lcall3/Controller/doc/img/cad assembly.JPG

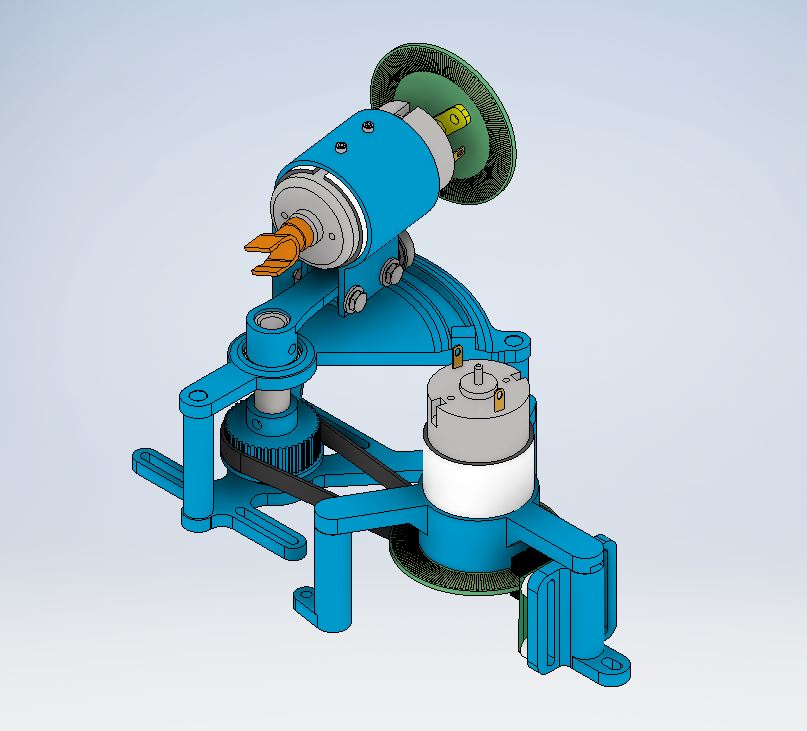
doc/img/cad assembly.JPG
