lcall3/Controller/doc/img/motor mount.png

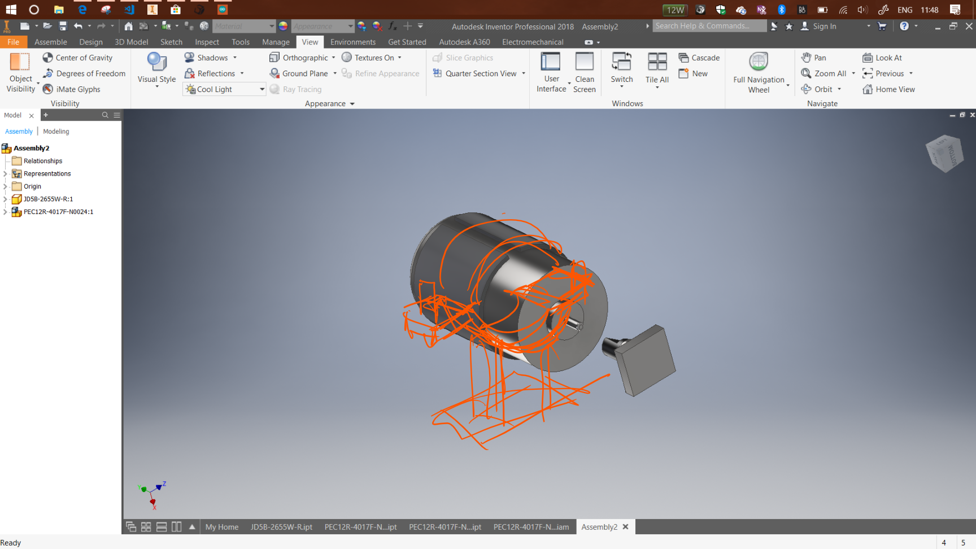
doc/img/motor mount.png
