lcall3/Controller/README.md

# ELEC391 Controller
ELEC391 Laser Lightshow Controller

> **Disclaimer**: Please use this repository as reference material only; we will not be responsible for any occurance of academic dishonesty.
