lcall3/Controller/doc/report/demo2 - demo.pptx

## Laser Light Show

ELEC 391 – Group B1

## Simulink Model

## The Process

Find Motor Parameters
Encoder PCB
System Setup
Controller Code

## Motor Parameters

- Resistance and Impedance
- Torque Constant
- Rotor Inertia
- Back EMF
- Kinetic Friction

R, L (8.4 Ω , 1.12mH)
R, L (8.4 Ω , 1.12mH)
Measured using multimeter
Kτ ( 23.54 (mNm)/A )
Kτ ( 23.54 mNm/A )
J ( 5.93×10^(−6) kg m^2 )
J ( 5.93×〖10〗^(−6) kg m^2 )
B ( 4.964 ×10^(−6) (kg m^2)/s )
B ( 4.964 ×〖10〗^(−6) (kg m^2)/s )
Torque determined from conservation of power
Calculated from mechanical time constant
Kv ( 628.5 (RPM)/V )
Kv ( 628.5 RPM/V )
Back EMF calculated from KVL
Kinetic friction from (torque)/(friction) at no load conditions
Kinetic friction from torque/friction at no load conditions

## Checking Motor Parameters

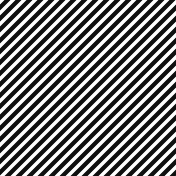
[picture p3: figure]

## Checking Motor Parameters

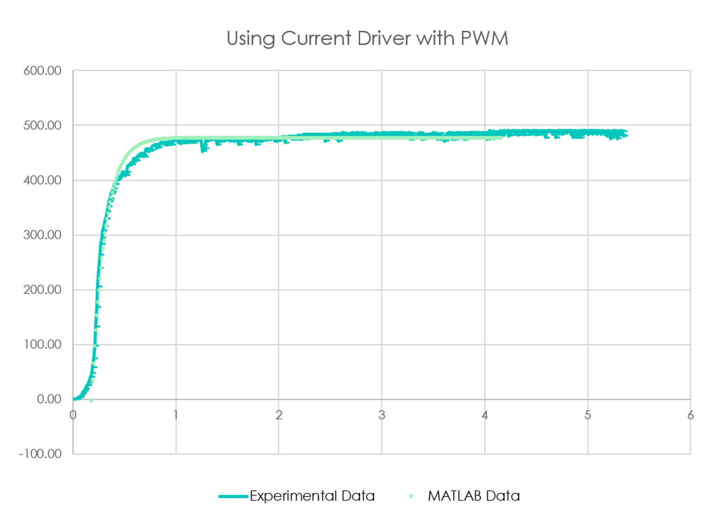
[picture p4: figure]

## Motor Model Roots

-7493

-8

0

* not to scale *

## Simulink Model with PID Control

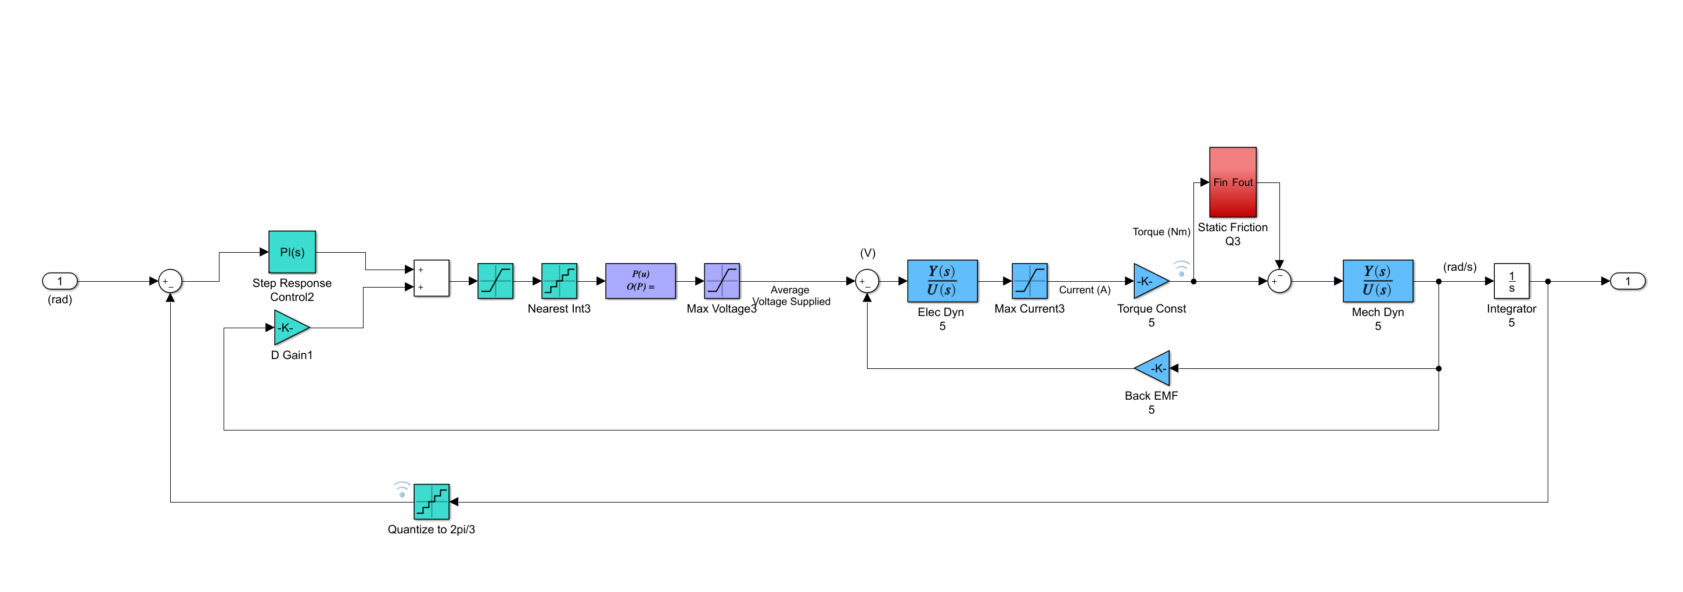
[picture p5: figure]

Static Friction and Cogging

PWM Value between
0 - 255

Input Step

Maps PWM to Average Voltage

Output Position

Derivative Gain on Velocity

Quantizes Angle to Encoder Resolution

Motor Transfer Function

## Controller Logic – Reading Position

On Encoder A Interrupt

A ^ B

Position++

Read Encoder A

End

Position--

On Encoder B Interrupt

Read Encoder B

A ^ B

Position++

End

Position--

State 01

State 00

State 11

State 10

Increment

Decrement

State
<A> <B>

## P Control

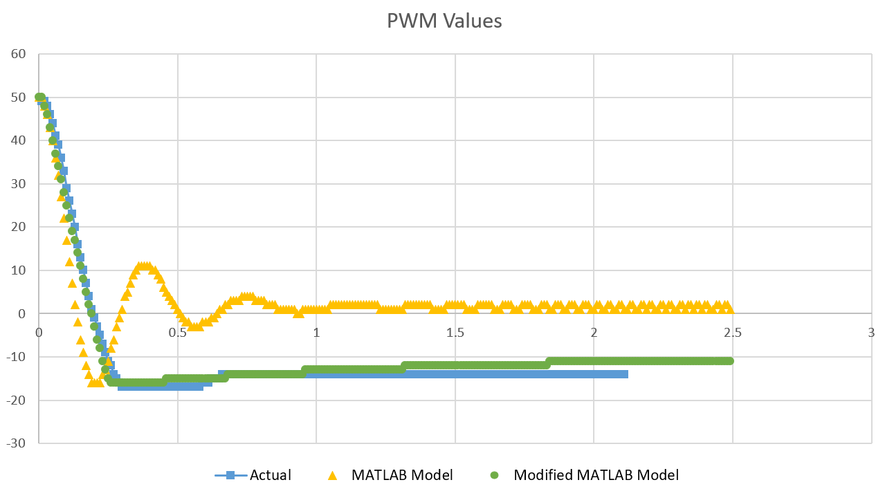
[picture p6: figure]

k_P =0.05(PWM)/(pulse)

## P Control

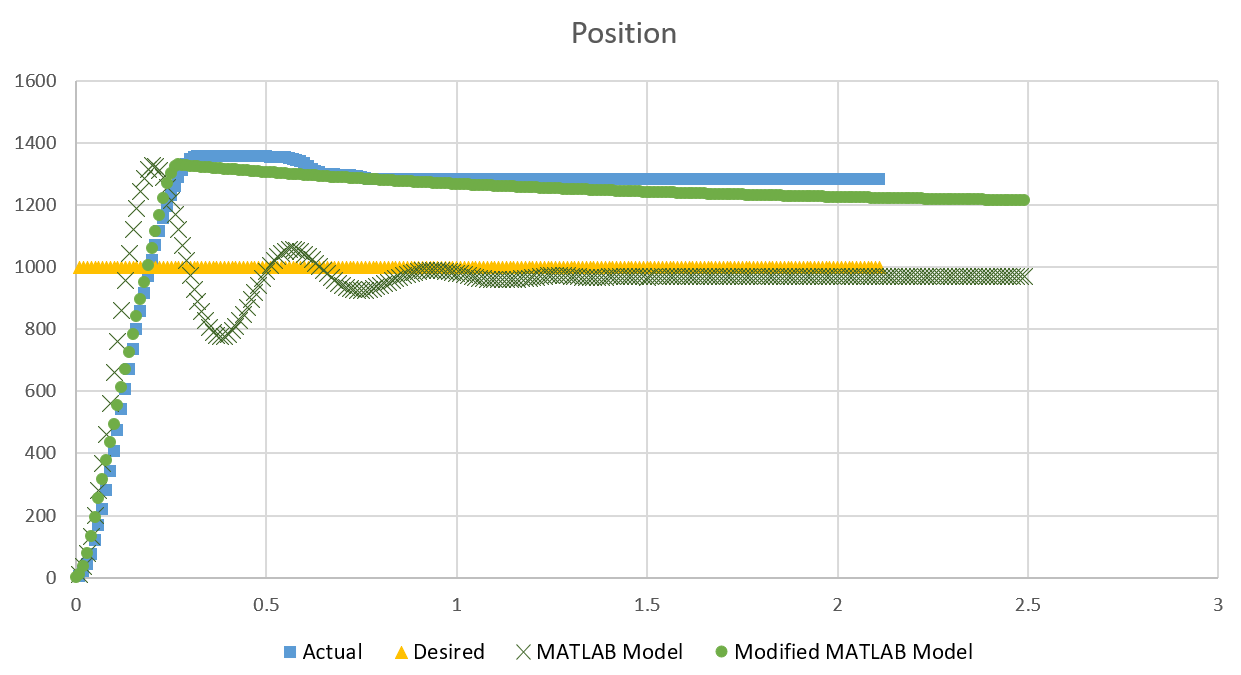
[picture p7: figure]

## PD Control

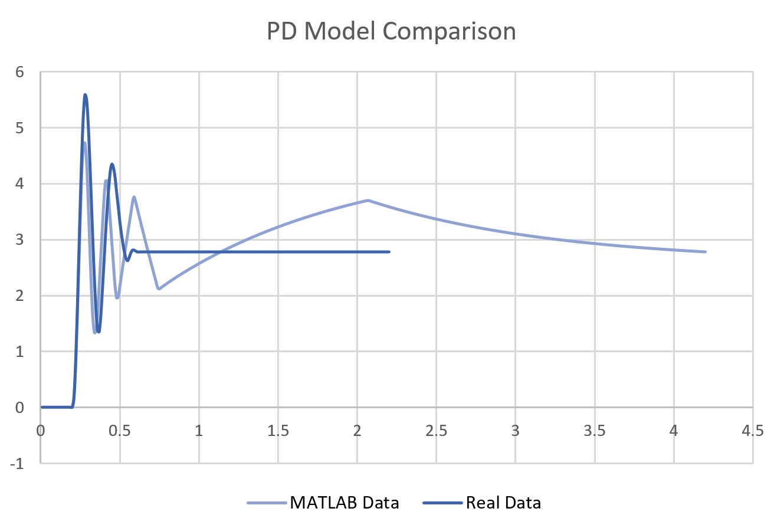
[picture p8: figure]

## Initial Control

- Aim for fastest rise time and small overshoot
- Ensure system is stable

Overshoot | 14.28 %
Rise Time | 0.1 s
Settle Time | 2 s
Control Frequency

k_P | k_I | k_D
17.7 | 0 | -0.4

## Performance

Overshoot | ~ 2 %
Rise Time | ~ 0.13 s
Settle Time | ~ 0.12 s
Control Frequency | ??

## Slide 16

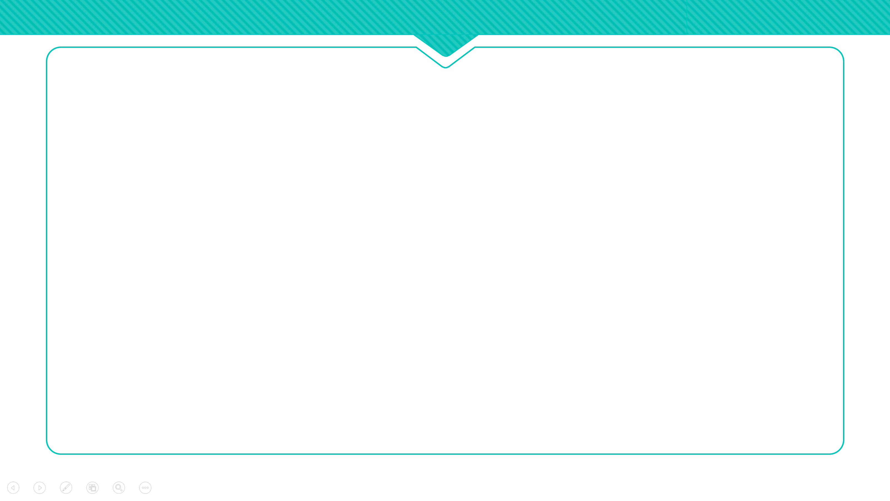
[picture p9: figure]

SYSTEM

INSERT IMAGE OF CAD MODEL FOR SYSTEM

## Performance

Overshoot | ~ 5 %
Rise Time | ~ 0.13 s
Settle Time | ~ 0.3 s
Control Frequency | ??

k_P | k_I | k_D
101.85 | 0 | -2.8838

## Next Steps - Integration

- Measure new motor parameters
- Adjust system integration design
- Improve gear ratios
- Retune PIDs

## System PCB

Current Driver

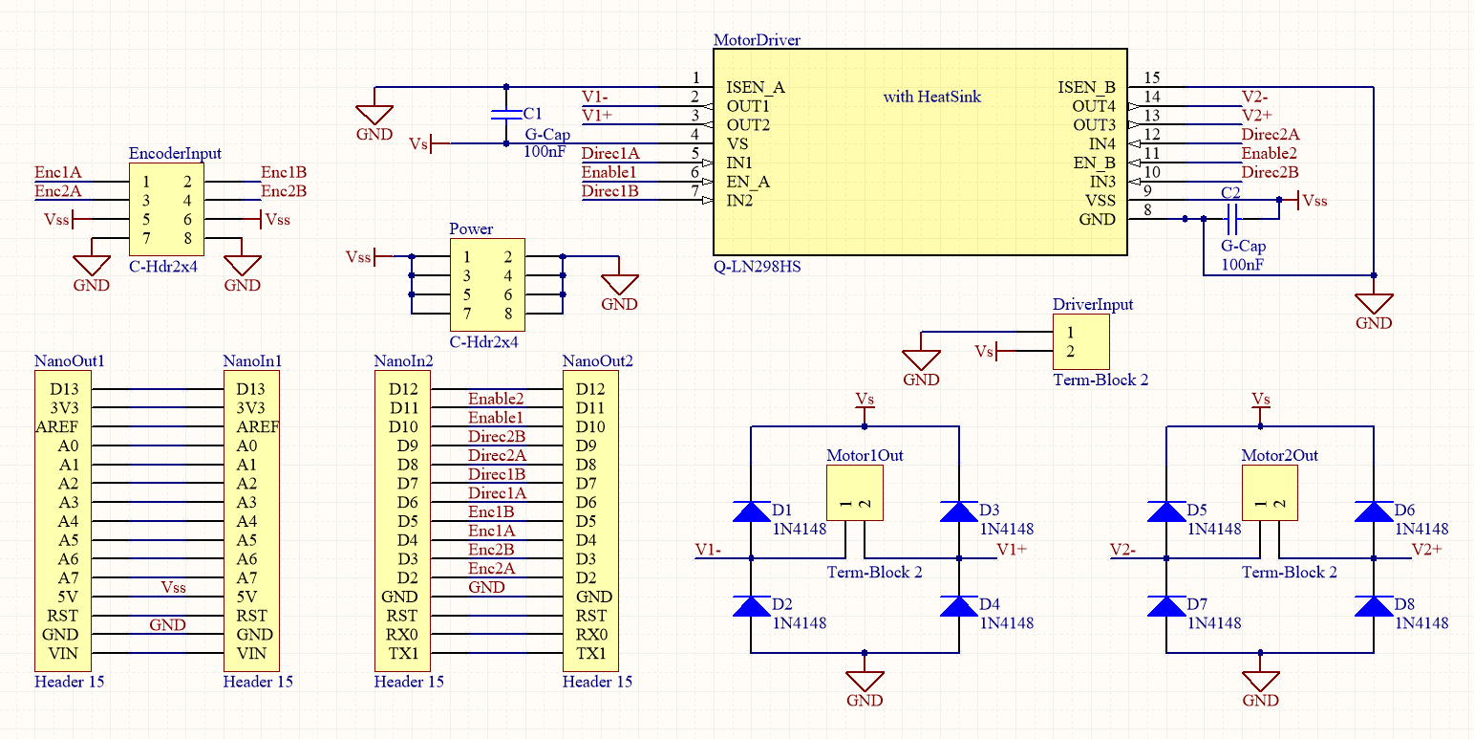
[picture p10: figure]

Pins from Encoder

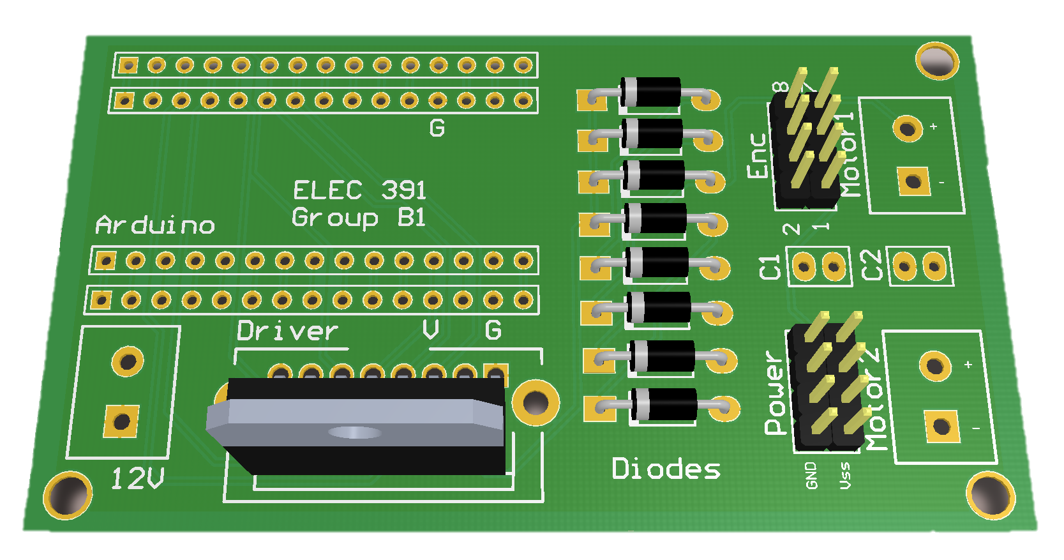
[picture p11: figure]

Extra 5V Pins

12V Input Pins

Arduino Base

Diode Bridge

## Coordinate Mapping Application

## Simulink Model
