lcall3/Controller/doc/report/demo2.pptx

## Laser Light Show

ELEC 391 – Group B1 ( Control )

## Simulink Model

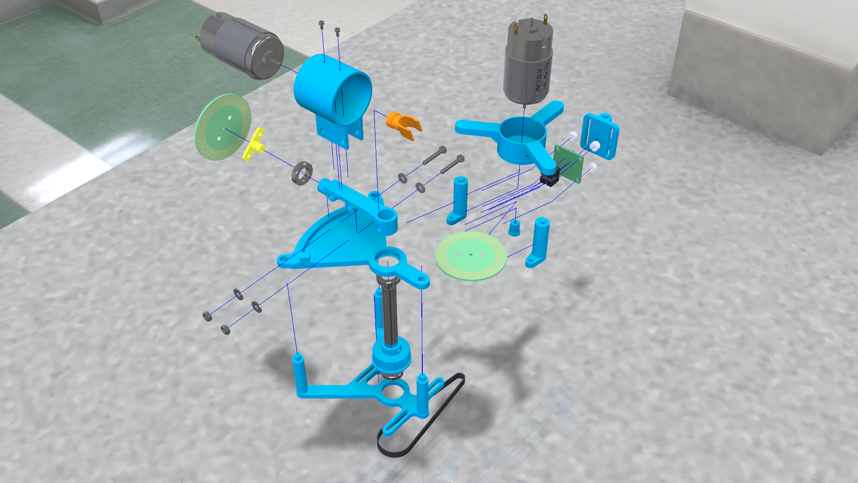
[picture p12: figure]
A birthday cake Description generated with high confidence
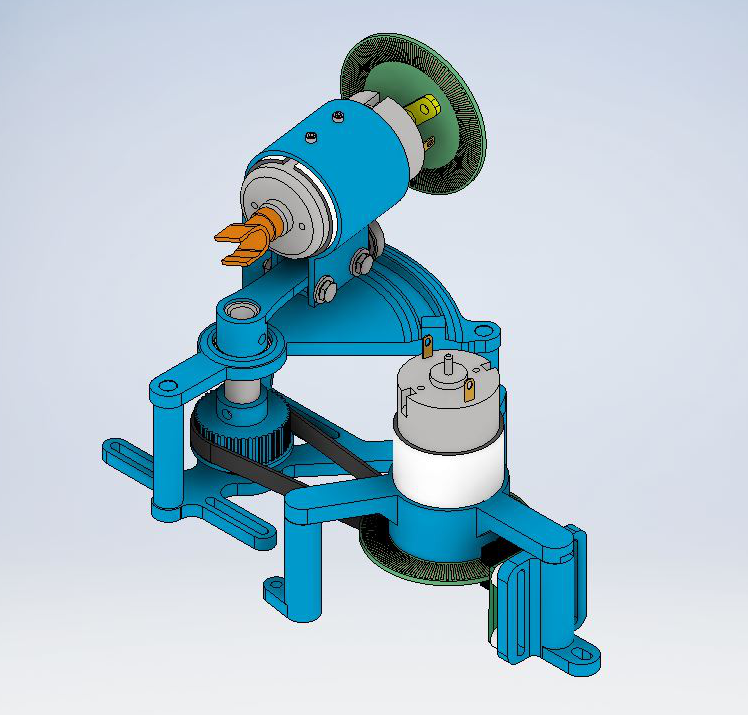
[picture p13: figure]
A close up of a toy Description generated with high confidence

## RCGs

Requirements
PID Values Obtained
Encoder Detects Position and Direction
Constraints
Max Memory / Speed of Microcontroller
Max Motor Current
( < 1A )
Goals
Rise Time
( < 0.017 s )
Overshoot
( < 10 % )
Functioning Microcontroller
No Breadboards
Max Encoder Resolution
( 400 pulses )
Simulink Model of Motor Within 5 % Error

## The Process

Find Motor Parameters
Encoder PCB
System Setup
Controller Code

## Motor Parameters

- Resistance and Impedance
- Torque Constant
- Rotor Inertia
- Back EMF
- Kinetic Friction

R, L (8.4 Ω , 1.12mH)
R, L (8.4 Ω , 1.12mH)
Measured using multimeter
Kτ ( 23.54 (mNm)/A )
Kτ ( 23.54 mNm/A )
J ( 5.93×10^(−6) kg m^2 )
J ( 5.93×〖10〗^(−6) kg m^2 )
B ( 4.964 ×10^(−6) (kg m^2)/s )
B ( 4.964 ×〖10〗^(−6) (kg m^2)/s )
Torque determined from conservation of power
Calculated from mechanical time constant
Kv ( 628.5 (RPM)/V )
Kv ( 628.5 RPM/V )
Back EMF calculated from KVL
Kinetic friction from (torque)/(friction) at no load conditions
Kinetic friction from torque/friction at no load conditions

## Checking Motor Parameters


## Closed Loop Simulink Model

Model Behaviour for Low PWM Values

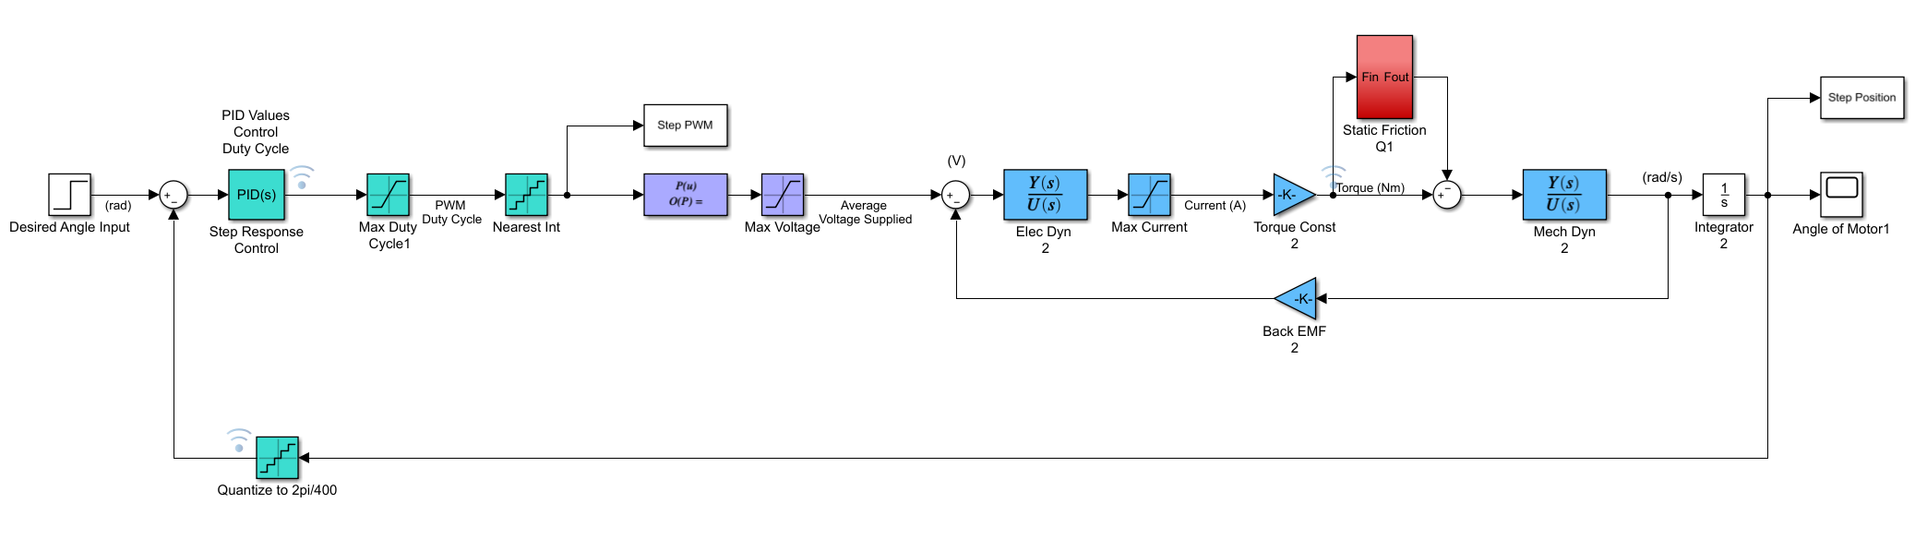
[picture p14: figure]

PWM Value between
0 - 255

Maps PWM to Average Voltage

Rounds PWM to Integer

Quantizes Angle to Encoder Resolution

Motor Transfer Function

## Controller Logic – Reading Position

On Encoder A Interrupt

A ^ B

Position++

Read Encoder A

End

Position--

On Encoder B Interrupt

Read Encoder B

A ^ B

Position++

End

Position--

State 01

State 00

State 11

State 10

Increment

Decrement

State
<A> <B>

## Initial Control

- Aim for fastest rise time and smallest overshoot
- Ensure system is stable

Overshoot
Rise Time
Settle Time
Control Frequency

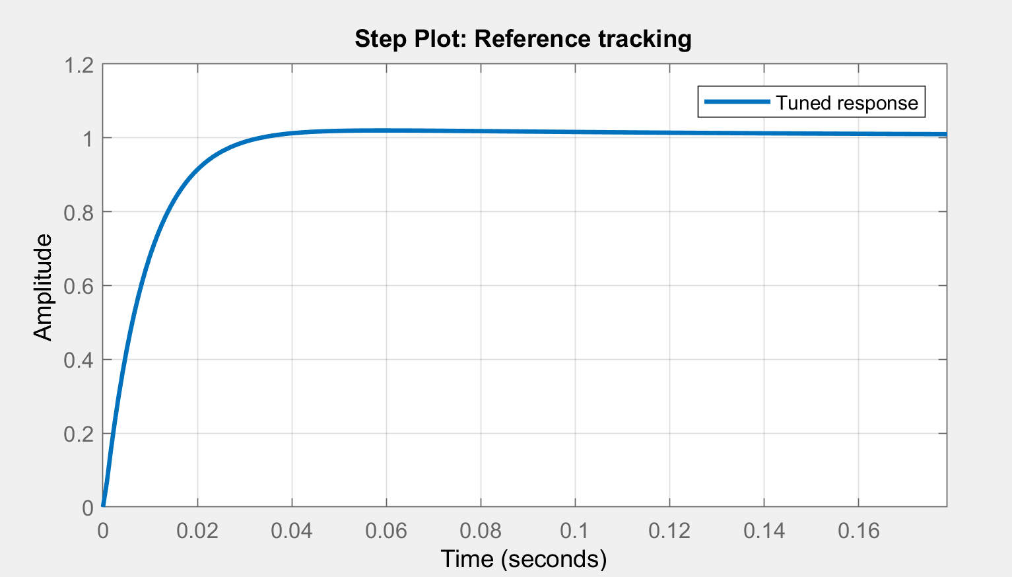
[picture p15: figure]

k_P | k_I | k_D | N
12.43 | 11.1 | 1.1 | 12783.9

## Controller Logic – PID Control

Proportional
Subtract current position from desired position for error value
Multiply by proportional gain
Integral
Keep sum of error values at small intervals
Multiply by integral gain
Derivative
Save position value every millisecond for velocity
Multiply velocity by derivative gain (negative)
Reset sum for each new coordinate

## P Control


Modified MATLAB Model accounts for values of PWM less than 30 being too low to overcome cogging and static friction


## PD Control

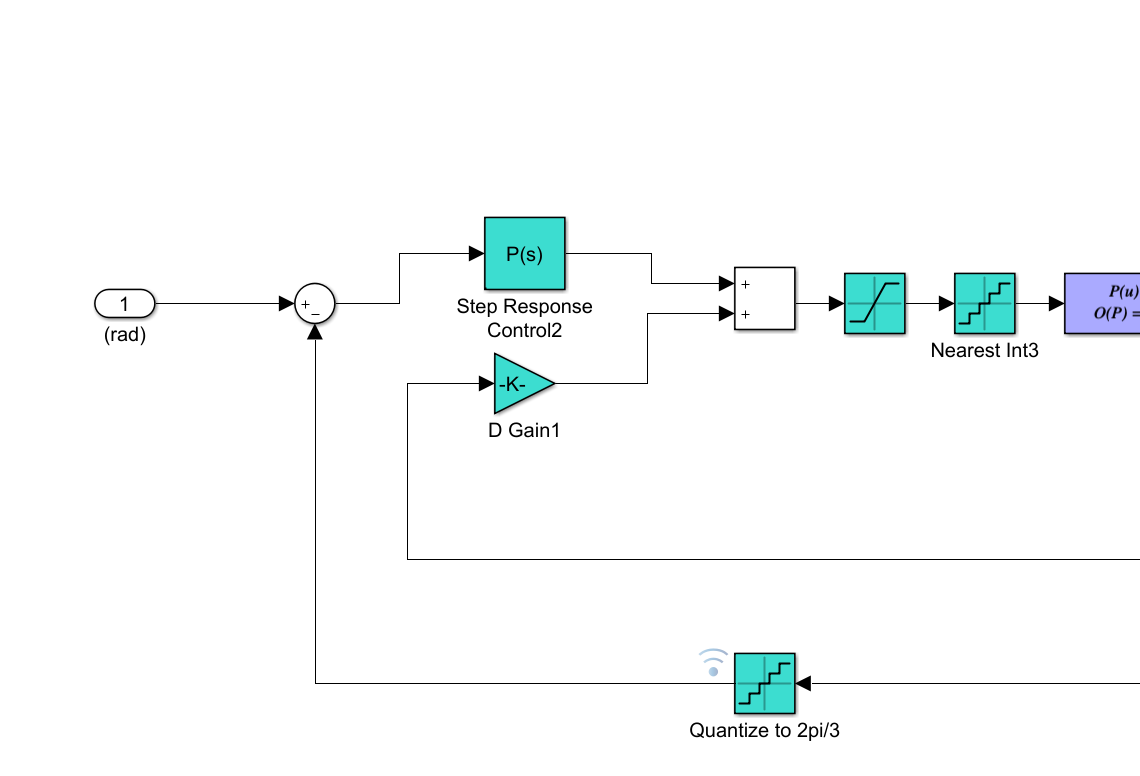
[picture p16: figure]

Simulink model adjusted for derivative control on current velocity instead of rate of error change.
This results in a negative derivative gain.


## Performance

Overshoot | ~ 5 %
Rise Time | ~ 0.13 s
Settle Time | ~ 0.3 s
Control Frequency | ??

## Slide 14


SYSTEM

INSERT IMAGE OF CAD MODEL FOR SYSTEM

## System PCB

Current Driver


Pins from Encoder


Extra 5V Pins

12V Input Pins

Arduino Base

Diode Bridge

## Homing

- dfsa

## Mapping

1

2

-0.7, 0.6

0.8, -0.2

θ1 = 7 pulses

θ1

- Map desired laser path to list of coordinates
- Inverse kinematics are applied to obtain angles
- Angles are converted to encoder positions
- Time vector is generated based on length of each line segment

To Controller

Points:
< n pulses >
Time:
< relative length>

3

4

-0.7, 0.6

0.8, -0.2

θ2

θ1

## Next Steps - Integration

- Measure new motor parameters
- Adjust system integration design
- Improve gear ratios
- Retune PIDs
