lcall3/Controller/data/code speed.pdf

## lcall3 Controller Software Performance Analysis

## Summary

| | Desired Freq | 1000 | Hz | | | Worse case time | 225.60 | us | | | Fmax | 4433 | Hz
Test 1 | Test 2 | Test 3
Encoder ISR with port read | Encoder ISR with digitalRead | float to int conversion
Time | Clock frequency | 1.60E+07 | Hz | Time | Time
[us] | Clock period | 6.25E-08 | s | [us] | [us]
1 | 8 | | | | 1 | 8 | | | | 1 | 0
2 | 4 | Minimum cycles | 64 | | 2 | 8 | Minimum cycles | 128 | | 2 | 4 | Minimum cycles | 0
3 | 4 | Maximum cycles | 128 | | 3 | 8 | Maximum cycles | 192 | | 3 | 4 | Maximum cycles | 64
4 | 8 | Average cycles | 90 | | 4 | 8 | Average cycles | 134 | | 4 | 4 | Average cycles | 51
5 | 4 | Average exec time | 5.60 | us | 5 | 8 | Average exec time | 8.40 | us | 5 | 4 | Average exec time | 3.20 | us
6 | 4 | Max frequency | 1.25E+05 | Hz | 6 | 8 | Max frequency | 8.33E+04 | Hz | 6 | 4 | Max frequency | 2.50E+05 | Hz
7 | 8 | | | | 7 | 8 | | | | 7 | 0
8 | 4 | | | | 8 | 8 | | | | 8 | 4
9 | 4 | | | | 9 | 12 | | | | 9 | 4
10 | 8 | | | | 10 | 8 | | | | 10 | 4
Average | 5.6 | | | | Average | 8.4 | | | | Average | 3.2
Test 4 | Test 5 | Test 6
Serial print 10 characters | Timer 1 ISR (single motor) | Timer 1 ISR (dual motor)
Time | Time | Time
[us] | [us] | [us]
1 | 760 | | | | 1 | 8 | | | | 1 | 8
2 | 760 | Minimum cycles | 12160 | | 2 | 8 | Minimum cycles | 64 | | 2 | 8 | Minimum cycles | 128
3 | 764 | Maximum cycles | 12224 | | 3 | 4 | Maximum cycles | 128 | | 3 | 8 | Maximum cycles | 192
4 | 760 | Average cycles | 12186 | | 4 | 8 | Average cycles | 109 | | 4 | 12 | Average cycles | 141
5 | 760 | Average exec time | 761.60 | us | 5 | 8 | Average exec time | 6.80 | us | 5 | 8 | Average exec time | 8.80 | us
6 | 764 | Max frequency | 1.31E+03 | Hz | 6 | 4 | Max frequency | 1.25E+05 | Hz | 6 | 12 | Max frequency | 8.33E+04 | Hz
7 | 764 | | | | 7 | 8 | | | | 7 | 8
8 | 760 | | | | 8 | 4 | | | | 8 | 8
9 | 764 | | | | 9 | 8 | | | | 9 | 8
10 | 760 | | | | 10 | 8 | | | | 10 | 8
Average | 761.6 | | | | Average | 6.8 | | | | Average | 8.8
Test 7 | Test 8
Single motor test | Dual motor PID control test
Time | Time
[us] | [us]
1 | 20 | | | | 1 | 188
2 | 20 | Minimum cycles | 256 | | 2 | 184 | Minimum cycles | 2944
3 | 16 | Maximum cycles | 448 | | 3 | 184 | Maximum cycles | 3136
4 | 28 | Average cycles | 326 | | 4 | 196 | Average cycles | 3021
5 | 24 | Average exec time | 20.40 | us | 5 | 196 | Average exec time | 188.80 | us
6 | 16 | Max frequency | 3.57E+04 | Hz | 6 | 184 | Max frequency | 5.10E+03 | Hz
7 | 28 | | | | 7 | 184
8 | 16 | | | | 8 | 192
9 | 20 | | | | 9 | 188
10 | 16 | | | | 10 | 192
Average | 20.4 | | | | Average | 188.8
Trial | Trial
Trial | Trial | Trial
Trial | Trial | Trial
