lcall3/Controller/doc/papers/motorParameter.pdf

MEASURING MOTOR PARAMETERS | File: Motor parameters

These are the motor parameters that are needed:
Motor voltage constant | Ke (volts-sec/rad)
Motor torque constant | KT (lb-in/amp)
Motor resistance | Ra (ohms)
Motor inductance | La (Henries)
Motor inertia | Jm (lb-in-sec^2)
Load inertia reflected to the motor armature shaft Jload (lb-in-sec^2)
Total inertia=Jm+Jload | Jtotal(lb-in-sec^2)

Note that the above values are stated for a single winding with dc motors, and are the phase values for a BLDC motor. Brushless dc motors (BLDC) are 3 phase synchronous motors used in a configuration to be treated as dc drives.

MOTOR RESISTANCE

For the winding resistance use an ohmmeter. For a dc motor measure the resistance between the 2 armature wires. If it is a WYE connected BLDC motor, the resistance is the line-to-line resistance. Thus divide the resistance(l-l) by 2 to get the phase resistance.

MOTOR VOLTAGE CONSTANT Ke

To measure the Ke of the motor, put the motor shaft in a lathe and rotate the shaft at some speed [rpm] such as 1000rpm. With a dc motor, use a dc voltmeter to measure the armature voltage. The Ke is then the voltage you read divided by the speed in rad/sec. Convert rpm to rad/sec as-

- = 60sec | sec
2 | min
min

rad
x
rev

radians
x

rev π
[ ]
speed[] rpm

Volts v
or
speed rad
Volts v Ke | [ | /sec]

[ ] =

With a BLDC motor use an ac voltmeter to measure the voltage between any 2 wires of the 3 motor wires and then convert the line-to-line voltage to the phase voltage value by dividing the line-to-line voltage by 3 =1.73.

1.73

( | ) ( | ) K line to line K phase | e

e

− − =

MOTOR TORQUE CONSTANT KT (for a BLDC MOTOR)

The motor torque constant (KT) can be computed from the voltage constant (Ke) as-

- =
- − | − rpm
K | volts
amp
lb in K | e | l l

T

( )
0.00684

The derivation for the above equation is-

Equate Electrical Power to Mechanical Power converted to Watts

1.356
60 | 12
2 3 | x

T
x E x I x N x

π =

where: T= lb-in
I= Amps
E= Voltsrms(line-to-line)
N= rpm
Rearranging terms and simplifying:
| I

T
N

E Ke = = 0.00684

- = | = | −
rpm

Volts
K | Back emf cons | t
N
E Where | rms l l

e

( | ) : | tan ,
- | − = | = | A
lb in K | Torque cons | t
I

T
T | tan ,

Converting rpm to rad/sec-

=

=

= | −
| sec

9.554
2
sec

60
2 min
min
60sec | ( | )
rad

v

x

rad

v x
x

rev

v x rev x K | l l

e
π | π

Thus

0.00684 9.554

[ sec/ ]
x
K v | rad K | e

T

− =

=
- − | −
| sec
15.3 | ( | )
rad

v
K
amp
lb in K | l l
T | e

MOTOR TORQUE CONSTANT Kt (for a DC MOTOR)

1.356
60 12

2
x

T E I N π =

E I = 0.011827 N T

I

T
N

E Ke = = 0.011827

- =
- −
RPM

K V
amp
lb in Therefore | K | e
T | 0.011827

:

MOTOR INERTIA Jm

Motor rotor inertia can be measured by making an experiment. The inertia can be calculated from the equation-
[ | ] | [ | ] |
- − = | − − | sec^2
rad Acceleration torque lb in Inertia lb in sec^2 x acceleration
Also | (rearranging terms)
[ | ] lb in sec^2
acceleration
accel torque Inertia = | − −

DC MOTORS

To do this test it is necessary to measure the acceleration of the motor rotor and the acceleration torque of the motor rotor. These two parameters are described as follows:

ACCELERATION – This parameter is determined by putting a step in current into the motor winding to bring the motor up to rated speed. The motor will accelerate exponentially. The acceleration is a measure of the rate of change of velocity over a period of time. To make this test, a dc tachometer should be connected to the motor shaft. The output of the tachometer should be connected to a stripchart recorder. When a step input in current is applied to the motor winding, the chart recorder will plot the rate of change of the motor shaft velocity as a function of the tachometer output voltage. The tachometer calibration can be used to convert volts to rpm. The acceleration is therefore the change in velocity for the linear part of the exponential curve divided by the time elapsed for the detected rate of change in velocity. The resulting calculation of the acceleration must have the dimensions changed to be in units of rad/sec^2.

TORQUE- An ammeter must be inserted in series with the motor input winding. When the step in input current is applied to the motor input, the maximum value of current should be noted. This current must be converted to torque. The torque is equal to the maximum value of current observed multiplied by the motor torque constant. Torque [lb-in]= amps[a] x KT [lb-in/a]. The inertia is then the acceleration torque divided by the acceleration as stated above.

BLDC MOTORS- The tests described thus far must be modified for a bldc motor. A bldc motor must be tested with its servo amplifier. The step input will be a step in dc voltage to the servo amplifier input. The voltage step should be large enough to cause the motor to reach rated speed. With bldc motors it is not possible to measure the high frequency phase current in a WYE connected motor. Thus some other procedure must be used to measure the current or torque and velocity. Commercial bldc servo amplifiers have two dc output test points. One output is a dc voltage proportional to velocity with a given calibration. The voltage can be directly connected to a strip chart as described previously to measure the motor acceleration, A second test output provides a dc voltage proportional to torque or a percentage of rated torque. This calibrated voltage can also be recorded with a stripchart recorder to observe its maximum value for a step voltage input to the servo amplifier. The inertia can thus be calculated as done previously.
MOTOR INDUCTANCE L

To measure the motor inductance use a low voltage ac source to the motor winding. For a dc motor, apply the ac voltage to the armature winding. For a BLDC motor apply the ac voltage to one pair of the three wires. In both cases measure the voltage and the current. Remember that the BLDC motor is usually connected in WYE. Thus the readings will be line-to-line. You want the phase values for the voltage, so divide the voltage by 2. The impedance of the BLDC motor phase winding is then-
[]
[ | ] [ | ] ohms
line current amps
phase voltage volts Im pedance = | =
The | tan | tan | [ | ] ² | 2 impedance = reacc | ce + resis | ce = ohms
[] | 2 | 2 Reac tan ce vars = impedance − resistan ce

Solve for the reactance from this equation. Note that the phase resistance was measured previously. The inductance can than be calculated from-

The reac tan ce [vars] = 2π x frequency x induc tan ce
The frequency is probably going to be from the ac source at 60 Hz. Thus-
[ | ] | [ ]
x frequency[] hZ
reac | ce | s Induc | ce henries
2π

tan var
tan | =

METRIC CONVERSIONS

If metric values are used, units conversions are included

The equation to calculate inertia for round objects (such as the motor shaft) is-

SHAFTS,PULLEYS,GEARS

ENGLISH

J = D[in]⁴

x LGTH[in] x 7.2 x 10⁻⁵ = [lb-in-s²
]
D=Diameter
METRIC

J = D[cm]⁴

x LGTH[cm] x 0.077 x 10⁻⁶ = [Kg-M² ]

The equation to calculate the inertia of round hollow shafts is-

HOLLOW SHAFT-GEAR OR PULLEY

ENGLISH

J = [D1

4
– D2

4

] x LGTH [in] x 7.2 x 10⁻⁵ = [lb-in-sec² ]

D = [in]

METRIC

J = [D1

4
– D2

4

] x LGTH [cm] x 0.077 x 10⁻⁶ = [KG-M² ]

D= [cm]

MECHANICAL TIME CONSTANT tm

With the motor constants known, you can then calculate the mechanical time constant-

[] | e( L L ) | T
l l | total at motor

T

e( L L )

L L
m | K | * K
| R * J
sec | 0.86
* K
1.73

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
Note that we use the phase values instead of line-to-line values. Use half the resistance line-to-line and add some resistance for the wiring from the amplifier to the motor. Usually a factor of 1.35 times the phase value of the resistance is a good approximation.

The equation to calculate the reflected inertia of a lead screw is-

LEAD SCREW

METRIC

[ | ] 16 6366
[ ] | [ ] 0.00788[ | / cm ] J | 2

2

4 | 3
ref | Kg M
x | xN
D cm xL cm x | Kg = | = | −
0.077 10 | [ | ] [cm] | [ ] J | 6 | 2

2

4
ref | x | x | Kg M
N
D | x L cm = | = | − ⁻

ENGLISH

[ | sec ] N | 16 246 in
D[in] | L[in] x 0.284[lb/in ] J | 2
2 | 2
4 | 3
ref = | = lb − in − x | x | x

x

[Lb -in -sec ] N

D[in] L[in]x 7.21 x 10 J | 2

2

4 | -5
ref = | = x

The equation to calculate the reflected inertia of a rack drive is-

RACK DRIVE

L=lead = in/rev

ENGLISH
[] |
- =
- = | 2

2 2 2
ref | 386(2 ) lb -in -sec
[2 rad]

[rev]
[rev]

L[in]
386

sec J
π | π
x | x

WT lbs x

=
- − − 0.00259
(2 )

sec

2

2
x

lb in
π

0.00259 [lb -in -s ] 2

in J | WT[lb] x L | 2

2
ref | =

- = | x
π

Jref = WT[lbs] x L²

x 0.00006569 = [lb-in-sec² ]

METRIC

2

2 2
ref | 2 rad 10mm | (20 )
| rev
x
rev
mm J | WT[Kg] x L
π | π
cm | Kg cm
x | − =
- =
[ | ] (20 ) (100cm)
cm J | Wt[Kg] x L | 2

2
ref | Kg M M
x | = | −
- = | π

0.00000002535
rev

mm J WT[Kg] x L

2
ref | x
- =

0.02535 10 [Kg - M ]
rev
mm J | WT[Kg] x L | 6 | 2

2
ref | =
- = | − x | x
