lcall3/Controller/CAD/Motor serial.png

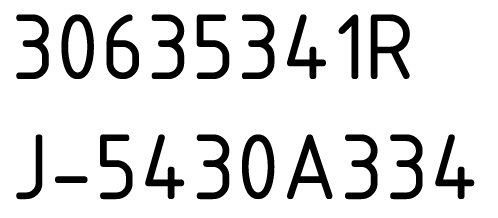
CAD/Motor serial.png
