lcall3/Controller/doc/img/control.png

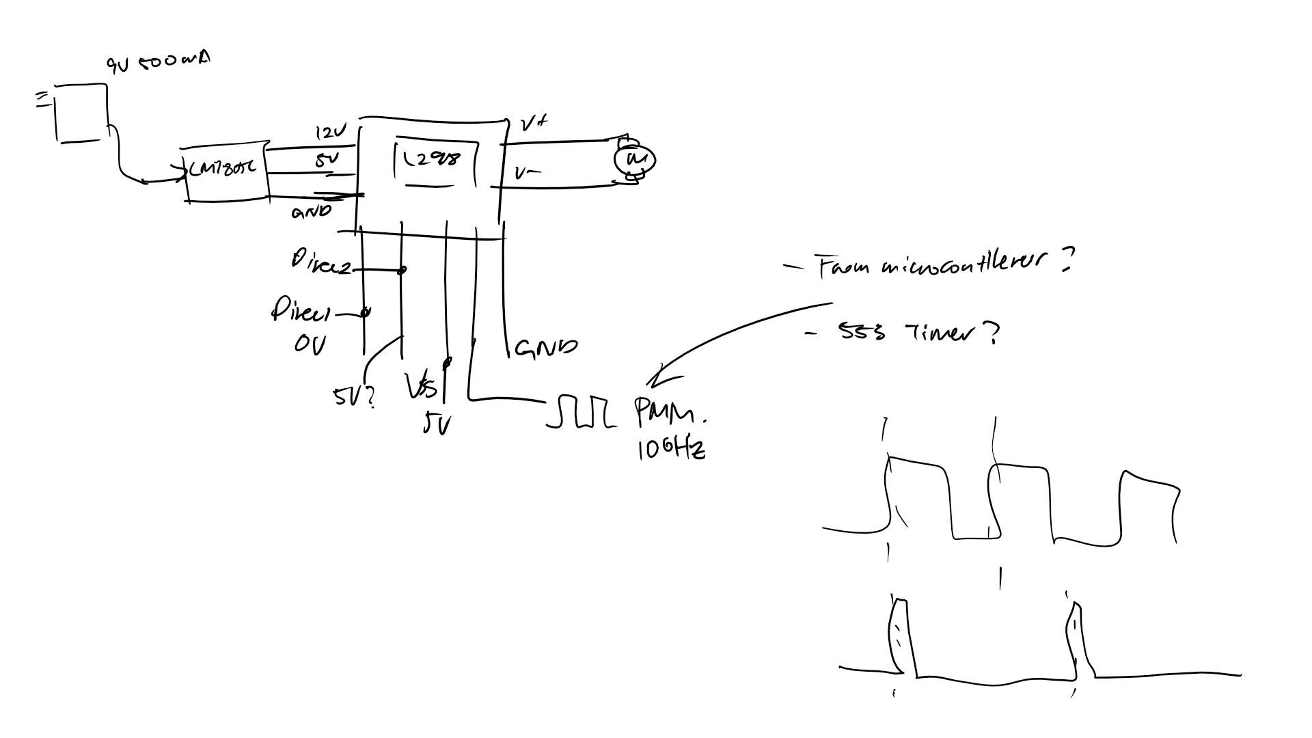
doc/img/control.png
