lcall3/Controller/doc/img/current driver functions.JPG

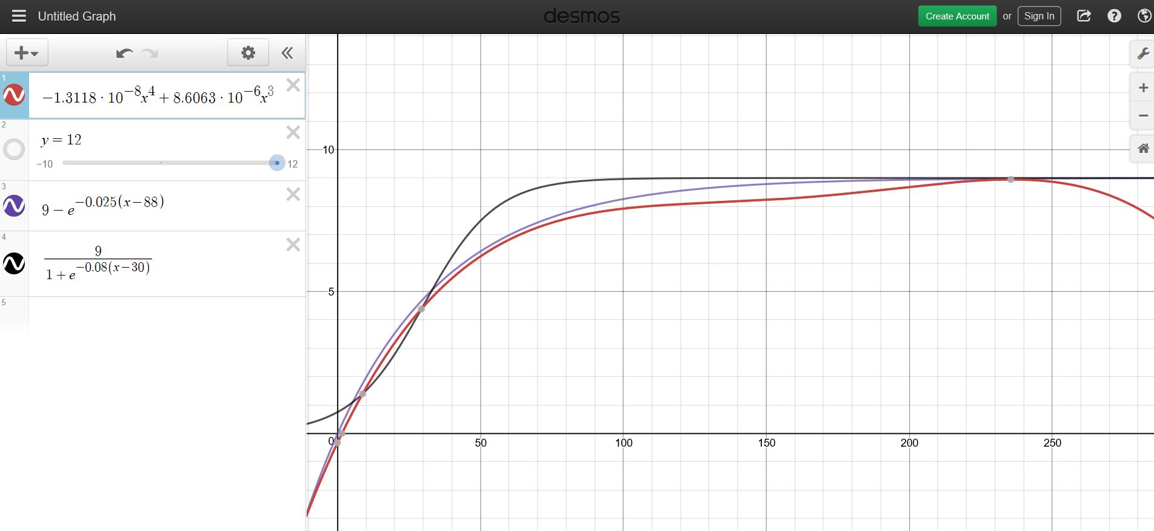
doc/img/current driver functions.JPG
