lcall3/Controller/doc/img/MotorInertia.JPG

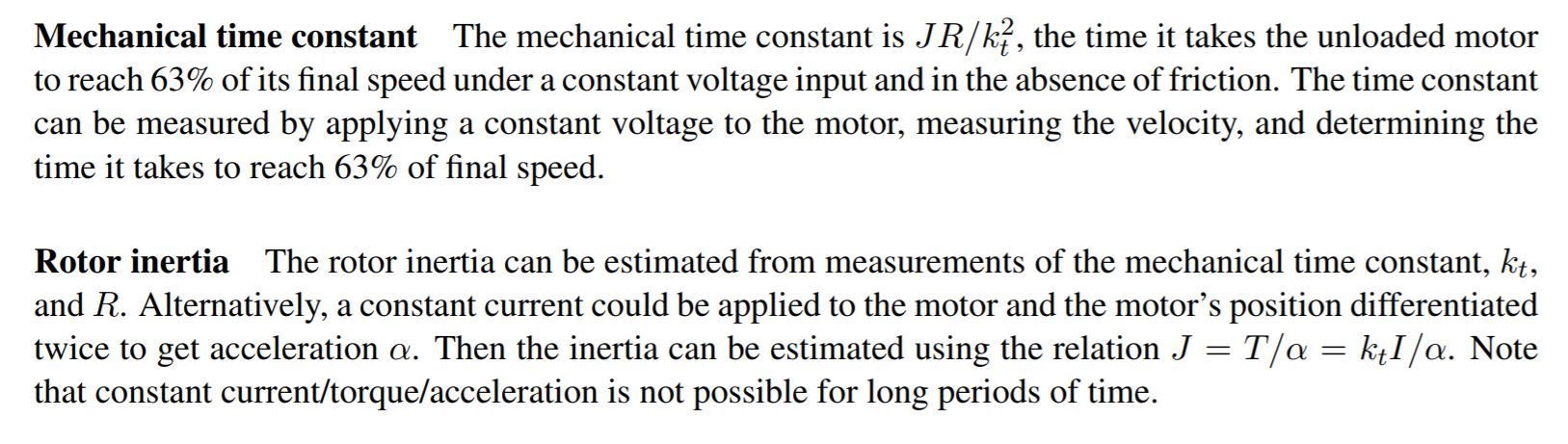
doc/img/MotorInertia.JPG
