lcall3/Controller/doc/img/v1.png

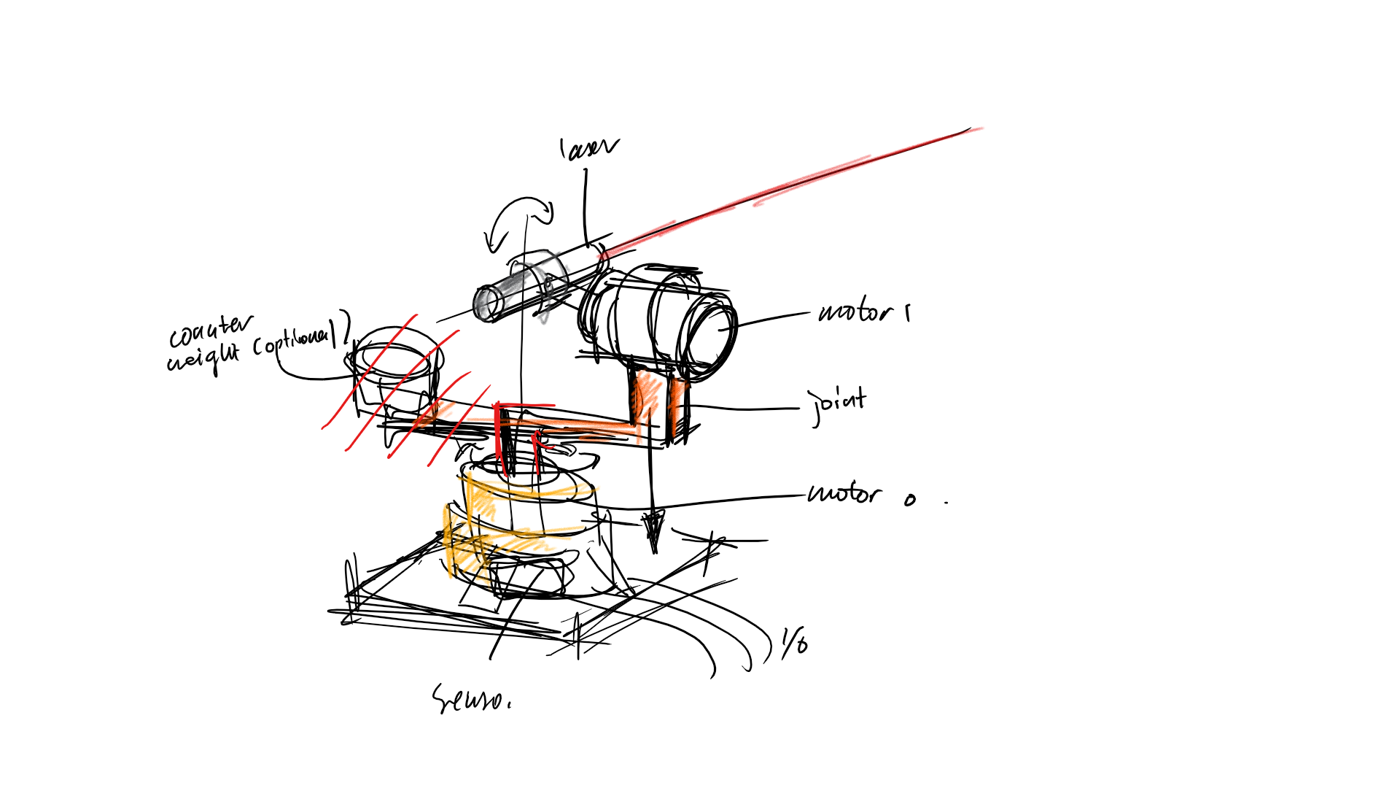
doc/img/v1.png
