lcall3/Controller/doc/img/View1 (2).png

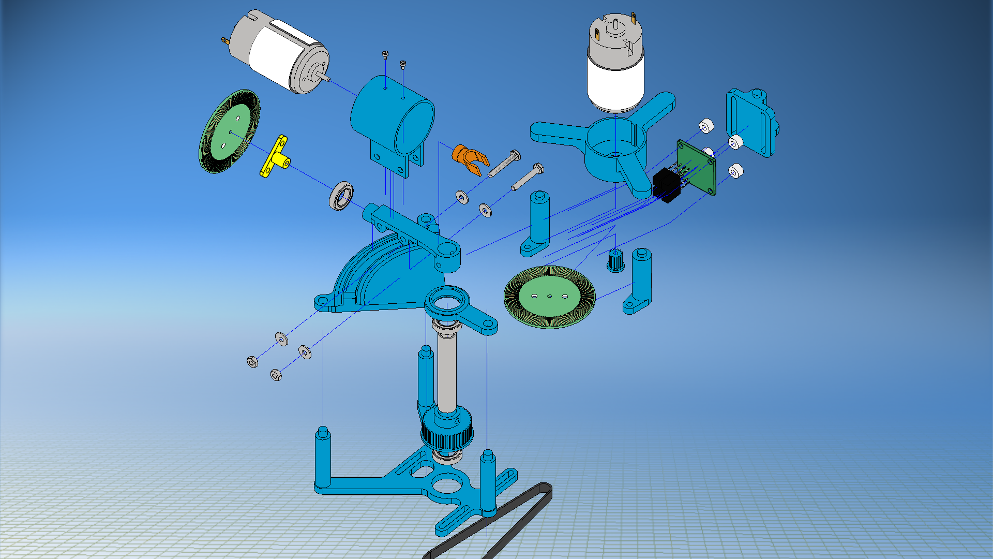
doc/img/View1 (2).png
