lcall3/Controller/doc/img/View1.png

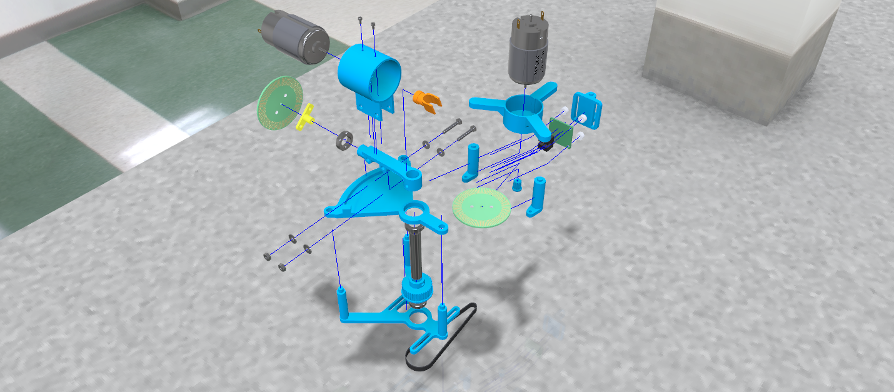
doc/img/View1.png
