lcall3/Controller/model/Single Motor - Commercial/Images/pid_rlocus.png

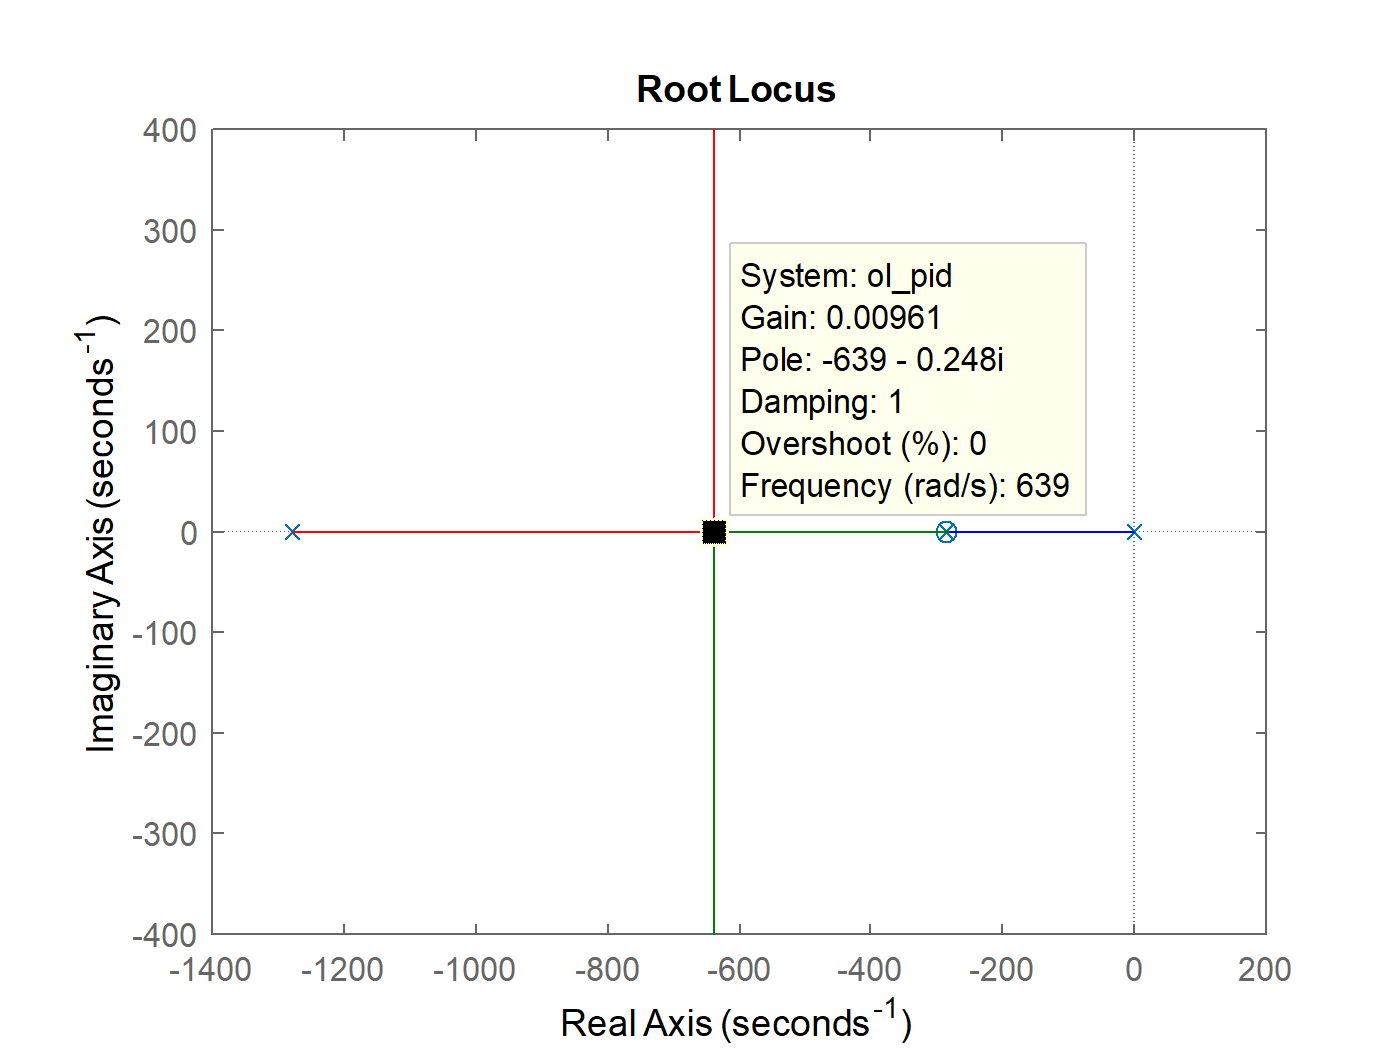
model/Single Motor - Commercial/Images/pid_rlocus.png
