lcall3/Controller/cad/dxf/16gt2.dxf

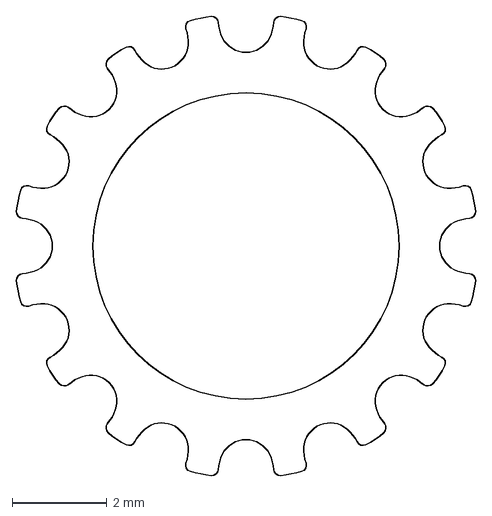
[picture p25: CAD file, 2018-04-03]
cad/dxf/16gt2.dxf
9.68 x 9.68 mm
