lcall3/Controller/cad/release/40x40x10 DC Fan.STEP

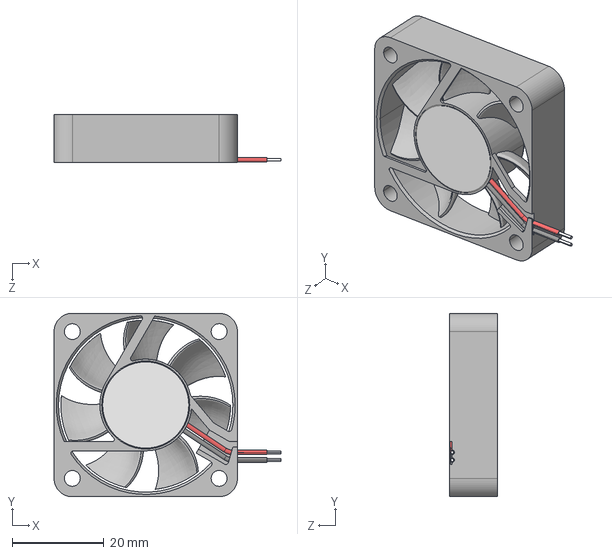
[picture p26: CAD file, 2018-03-31]
cad/release/40x40x10 DC Fan.STEP
49.5 x 40.0 x 10.5 mm
