lcall3/Controller/cad/stl/04-02 - GT2Yaw1p9mm.stl

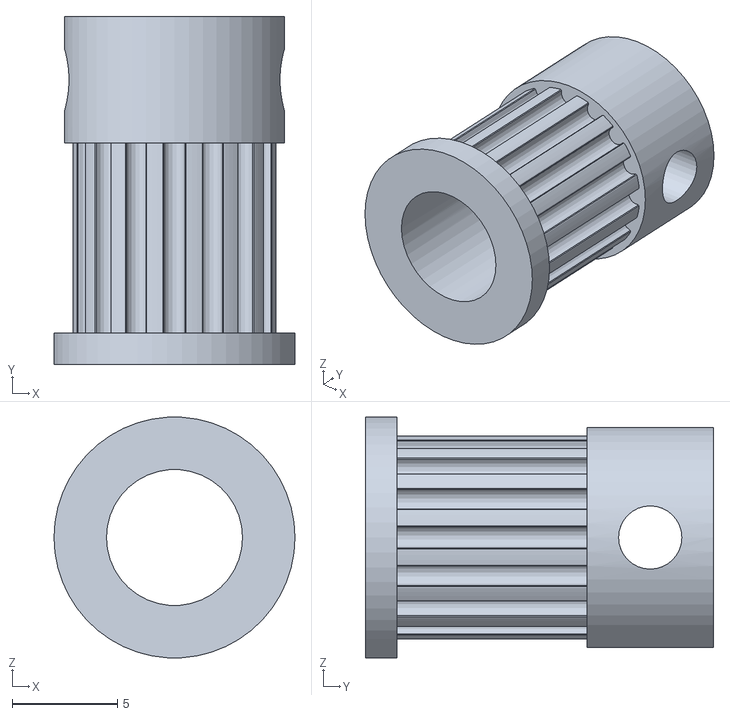
[picture p27: CAD file, 2018-04-03]
cad/stl/04-02 - GT2Yaw1p9mm.stl
11.4 x 16.5 x 11.4
