lcall3/Controller/cad/dxf/ctrlLeft.dxf

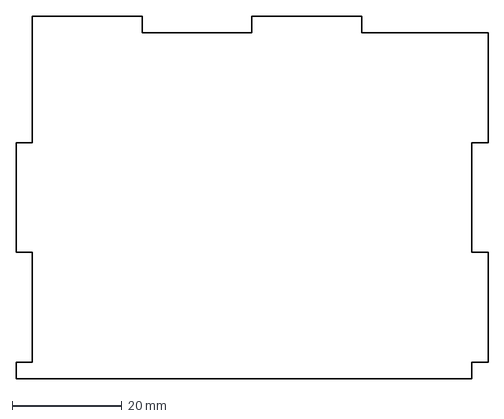
[picture p28: CAD file, 2018-03-31]
cad/dxf/ctrlLeft.dxf
86.0 x 66.0 mm
