lcall3/Controller/cad/stl/04-02 GT2Yaw1p95.stl

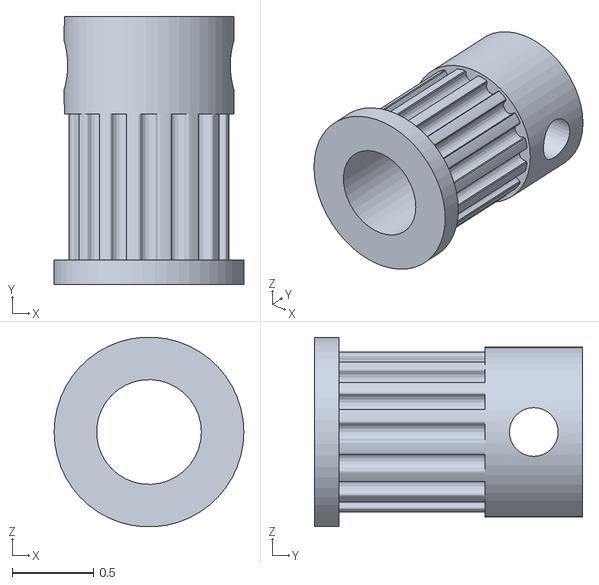
[picture p29: CAD file, 2018-04-03]
cad/stl/04-02 GT2Yaw1p95.stl
1.17 x 1.65 x 1.17
