lcall3/Controller/cad/dxf/ctrlRightPowerPlate.dxf

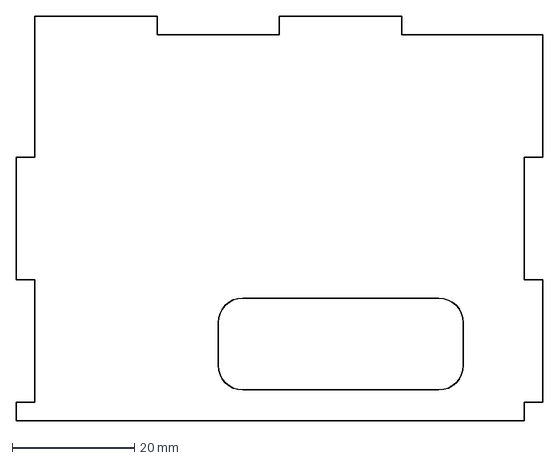
[picture p30: CAD file, 2018-03-31]
cad/dxf/ctrlRightPowerPlate.dxf
86.0 x 66.0 mm
