lcall3/Controller/cad/stl/04-02 GT2Yaw1p9.stl

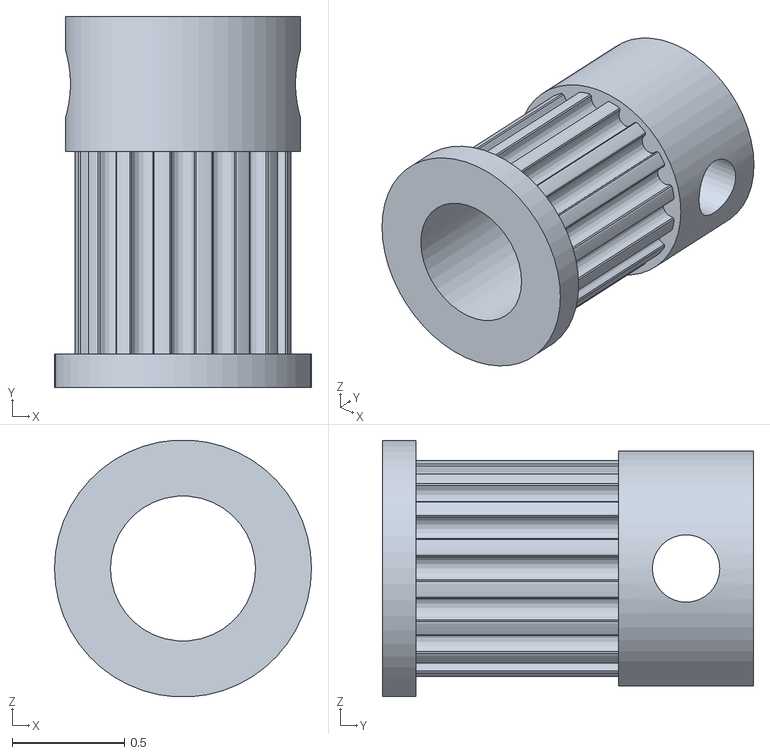
[picture p31: CAD file, 2018-04-03]
cad/stl/04-02 GT2Yaw1p9.stl
1.14 x 1.65 x 1.14
