lcall3/Controller/cad/dxf/ctrlTopPlate.dxf

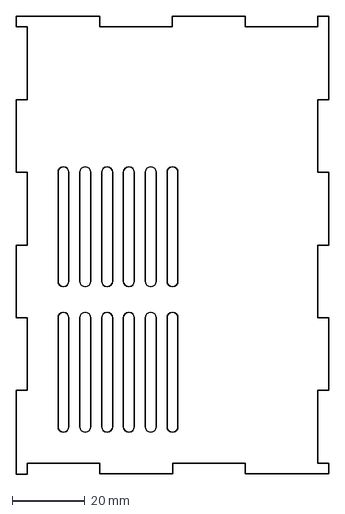
[picture p32: CAD file, 2018-03-31]
cad/dxf/ctrlTopPlate.dxf
86.0 x 126.0 mm
