lcall3/Controller/cad/dxf/ctrlBackPlate.dxf

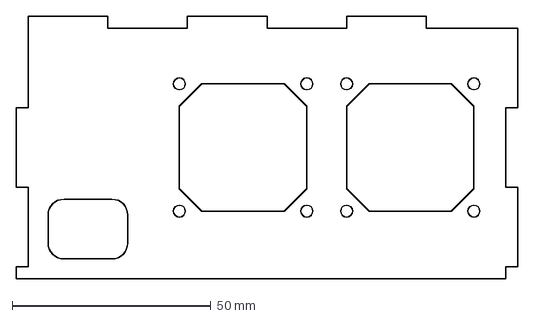
[picture p33: CAD file, 2018-03-31]
cad/dxf/ctrlBackPlate.dxf
126.0 x 66.0 mm
