lcall3/Controller/cad/stl/04-02 ShaftSyncAdapter.stl

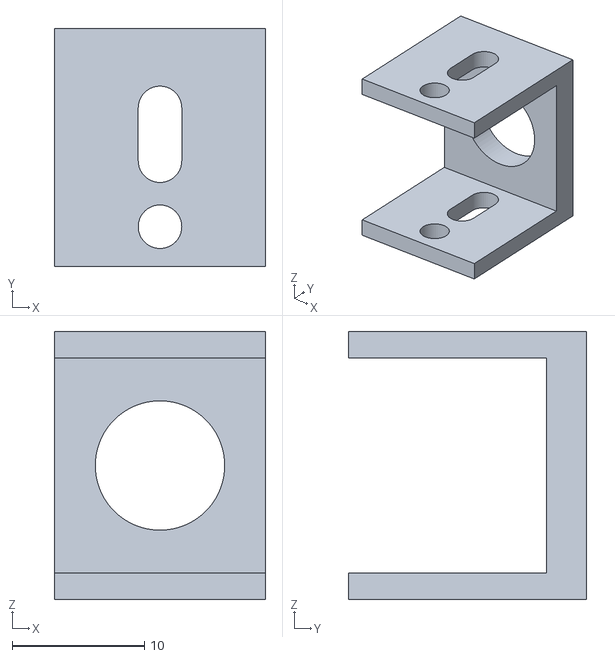
[picture p34: CAD file, 2018-04-03]
cad/stl/04-02 ShaftSyncAdapter.stl
16.0 x 18.0 x 20.3
