lcall3/Controller/cad/dxf/ctrlFrontPlate.dxf

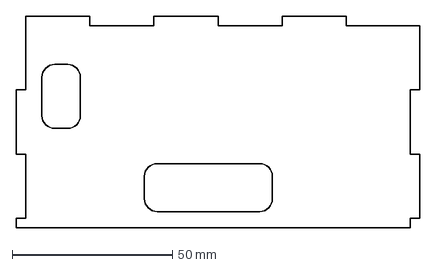
[picture p35: CAD file, 2018-03-31]
cad/dxf/ctrlFrontPlate.dxf
126.0 x 66.0 mm
