lcall3/Controller/cad/stl/04-02 ForceStopper.stl

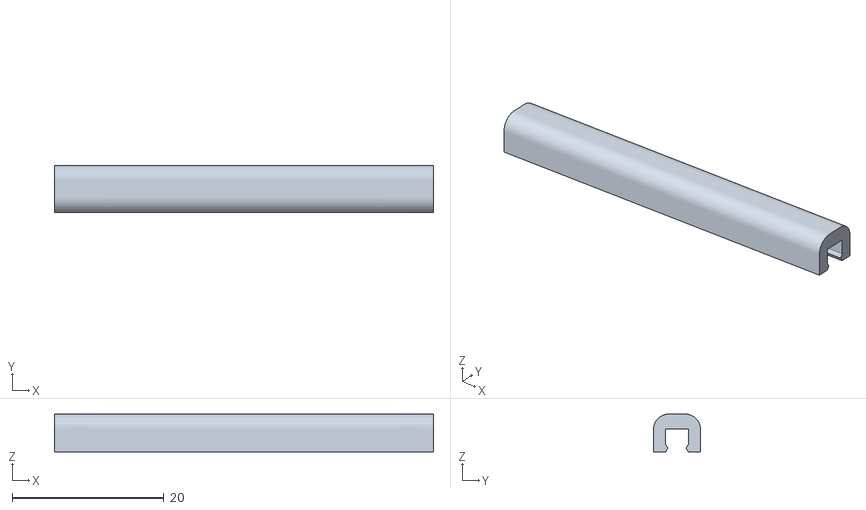
[picture p36: CAD file, 2018-04-03]
cad/stl/04-02 ForceStopper.stl
50.0 x 6.20 x 5.00
