lcall3/Controller/cad/dxf/pitchencodermount.dxf

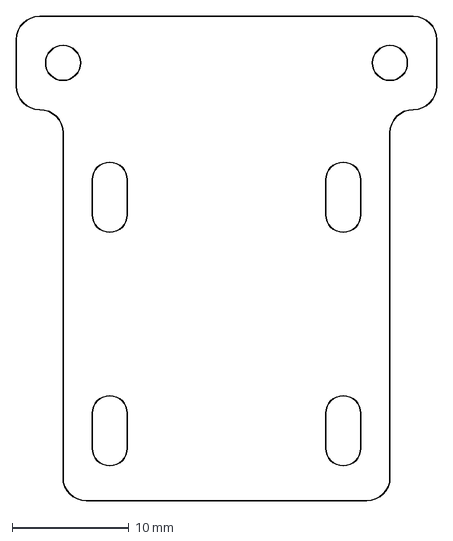
[picture p37: CAD file, 2018-03-30]
cad/dxf/pitchencodermount.dxf
36.0 x 41.5 mm
