lcall3/Controller/cad/stl/04-01 OmegaRing.stl

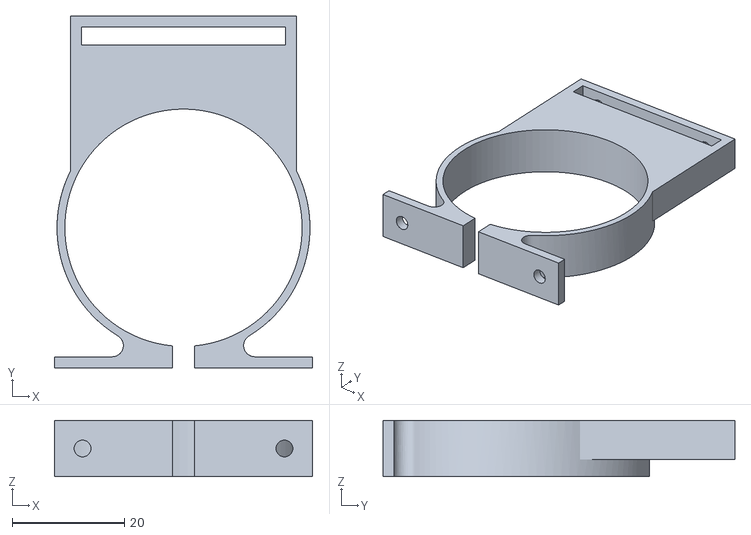
[picture p38: CAD file, 2018-04-02]
cad/stl/04-01 OmegaRing.stl
46.0 x 62.8 x 10.0
