lcall3/Controller/cad/dxf/pitchbase.dxf

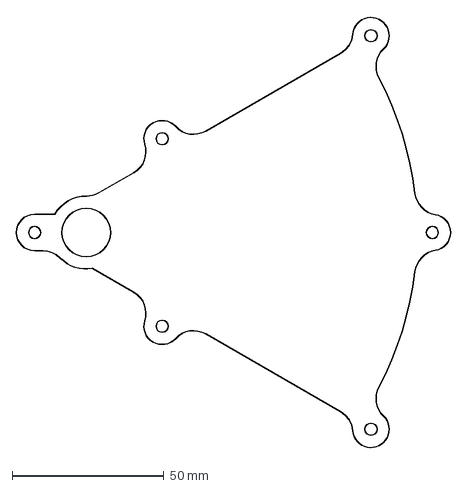
[picture p39: CAD file, 2018-03-30]
cad/dxf/pitchbase.dxf
143.0 x 142.4 mm
