lcall3/Controller/cad/stl/04-01 LaserDiodeAdapterLarge.stl

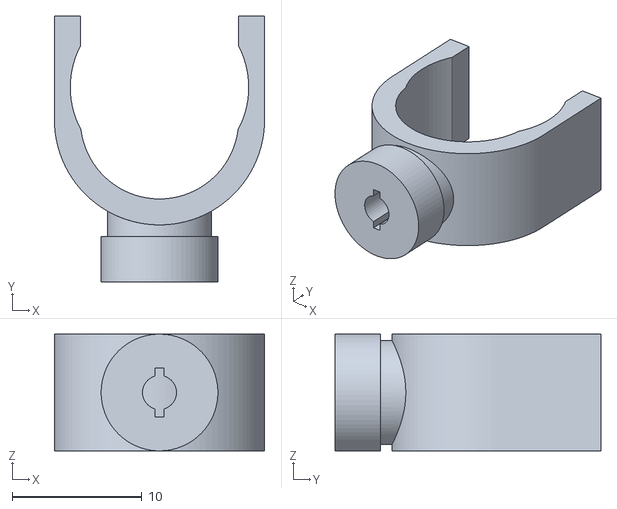
[picture p40: CAD file, 2018-04-01]
cad/stl/04-01 LaserDiodeAdapterLarge.stl
16.2 x 20.5 x 9.00
