lcall3/Controller/cad/dxf/bottombaseplate.dxf

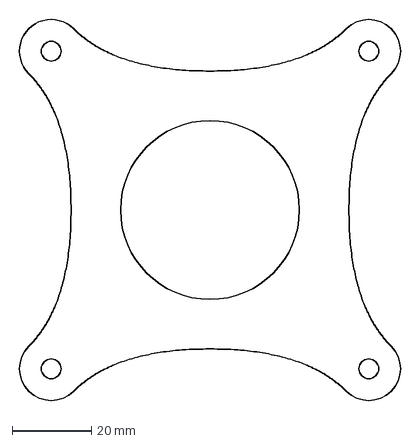
[picture p41: CAD file, 2018-03-30]
cad/dxf/bottombaseplate.dxf
97.6 x 97.6 mm
