lcall3/Controller/cad/stl/03-31 ShaftBushing.stl

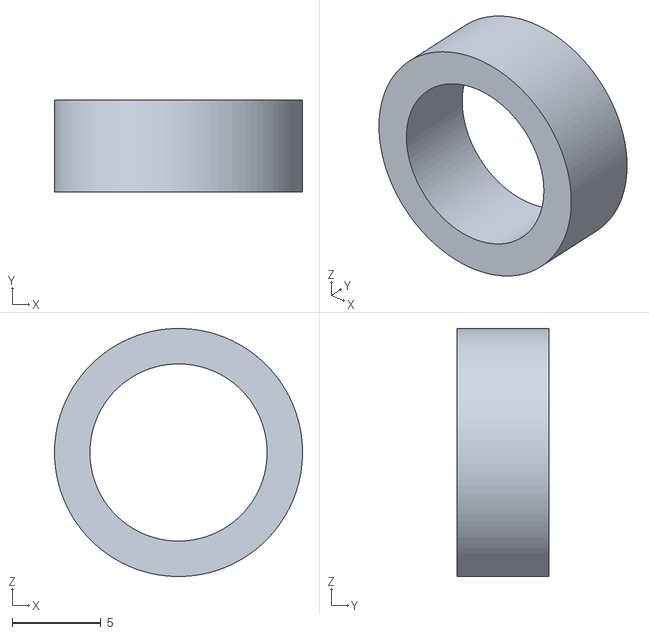
[picture p42: CAD file, 2018-03-31]
cad/stl/03-31 ShaftBushing.stl
14.0 x 5.20 x 14.0
