lcall3/Controller/cad/dxf/baseplate.dxf

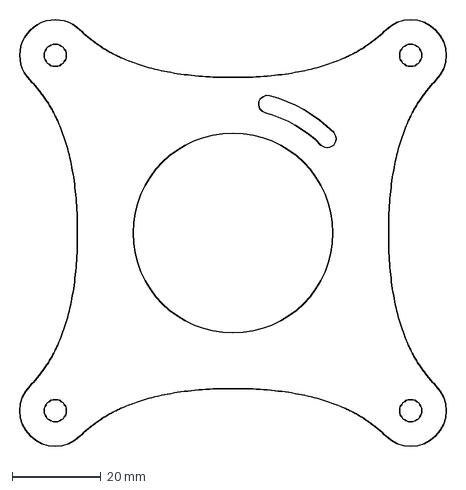
[picture p43: CAD file, 2018-03-30]
cad/dxf/baseplate.dxf
97.6 x 97.6 mm
