lcall3/Controller/cad/stl/03-31 EncoderWheelAdapter.stl

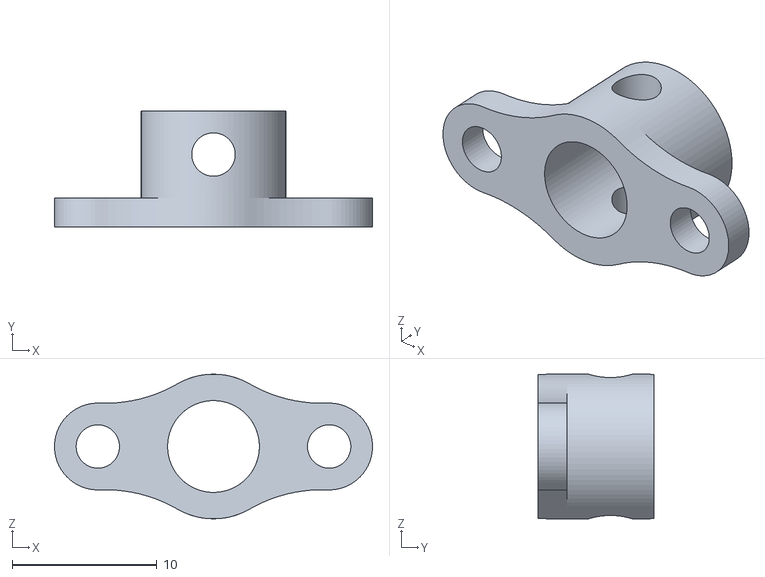
[picture p44: CAD file, 2018-03-31]
cad/stl/03-31 EncoderWheelAdapter.stl
22.0 x 8.00 x 10.0
