lcall3/Controller/cad/dxf/yawencodermount.dxf

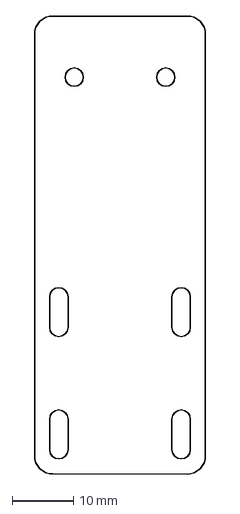
[picture p45: CAD file, 2018-03-30]
cad/dxf/yawencodermount.dxf
28.0 x 75.0 mm
