lcall3/Controller/cad/stl/03-31 tube.stl

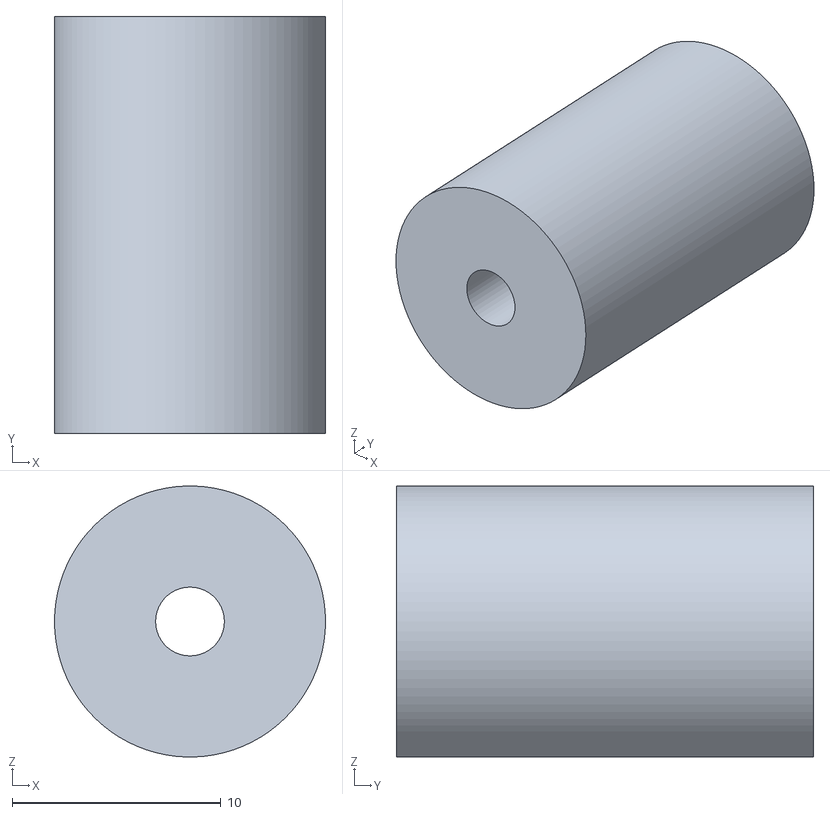
[picture p46: CAD file, 2018-03-31]
cad/stl/03-31 tube.stl
13.0 x 20.0 x 13.0
