lcall3/Controller/cad/dxf/yawplate.dxf

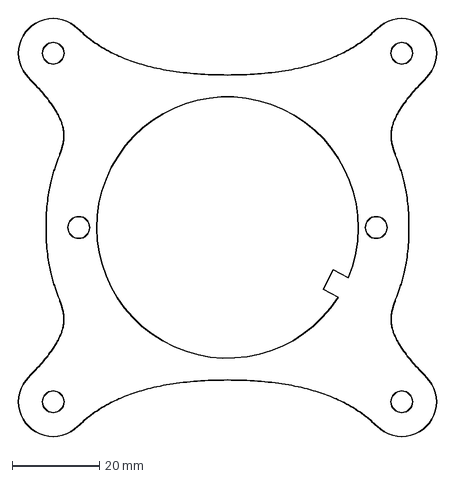
[picture p47: CAD file, 2018-03-30]
cad/dxf/yawplate.dxf
96.9 x 96.9 mm
