lcall3/Controller/cad/stl/03-31 Tensioner.stl

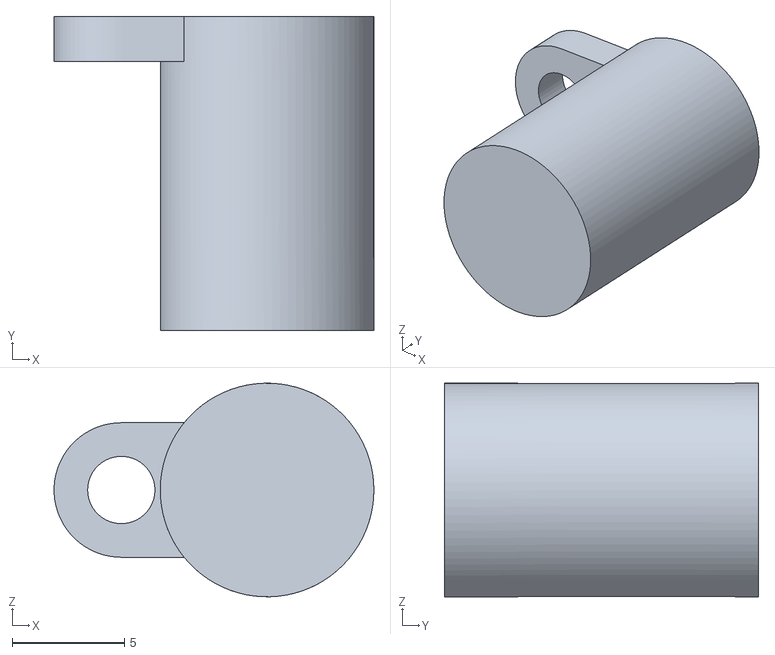
[picture p48: CAD file, 2018-03-31]
cad/stl/03-31 Tensioner.stl
14.3 x 14.0 x 9.52
