lcall3/Controller/cad/dxf/EncoderPCBMount.dxf

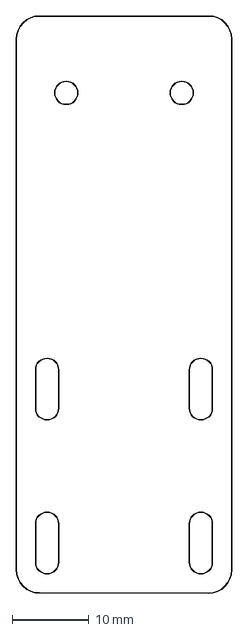
[picture p49: CAD file, 2018-03-28]
cad/dxf/EncoderPCBMount.dxf
28.0 x 75.0 mm
