lcall3/Controller/cad/stl/03-31B DefaultMotorMount.stl

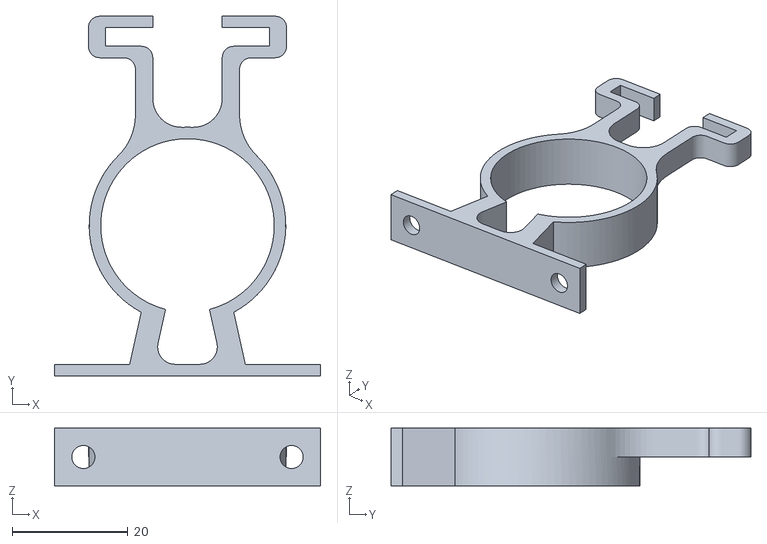
[picture p50: CAD file, 2018-03-31]
cad/stl/03-31B DefaultMotorMount.stl
46.0 x 62.2 x 10.0
