lcall3/Controller/cad/dxf/RailPlate.dxf

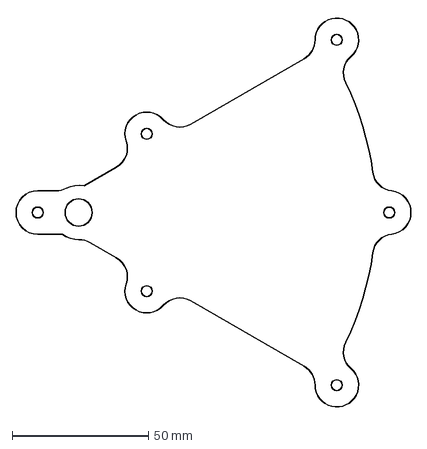
[picture p51: CAD file, 2018-03-28]
cad/dxf/RailPlate.dxf
145.0 x 144.0 mm
