lcall3/Controller/cad/stl/03-31B DefaultMotorMountBack.stl

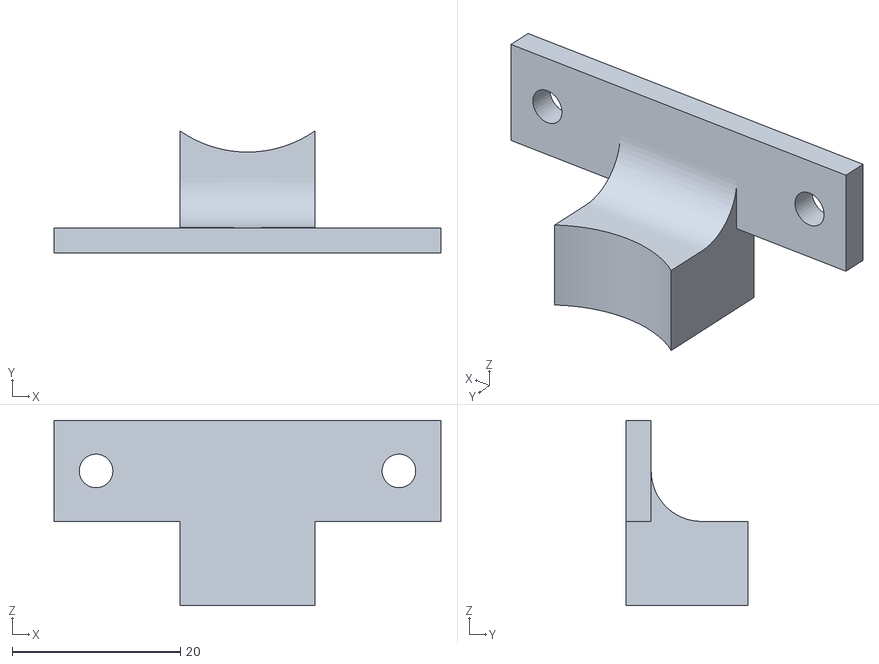
[picture p52: CAD file, 2018-03-31]
cad/stl/03-31B DefaultMotorMountBack.stl
46.0 x 14.5 x 22.0
