lcall3/Controller/cad/dxf/YawBottomPlate.dxf

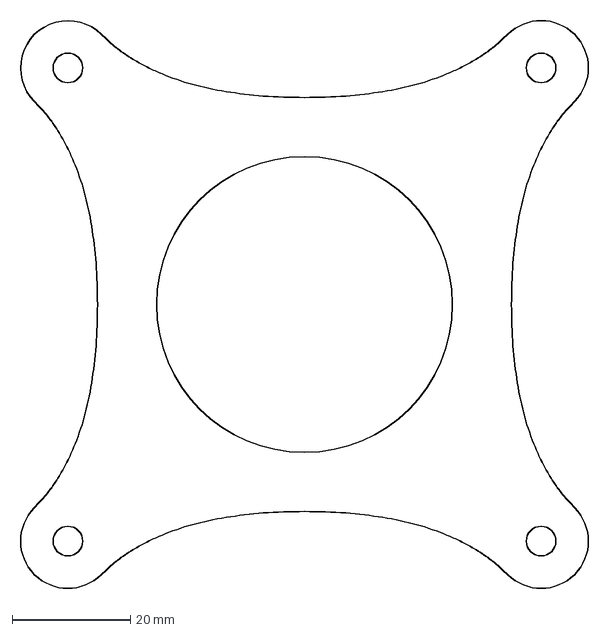
[picture p53: CAD file, 2018-03-28]
cad/dxf/YawBottomPlate.dxf
97.6 x 97.6 mm
