lcall3/Controller/cad/stl/pitch6mmBearingAdapter.stl

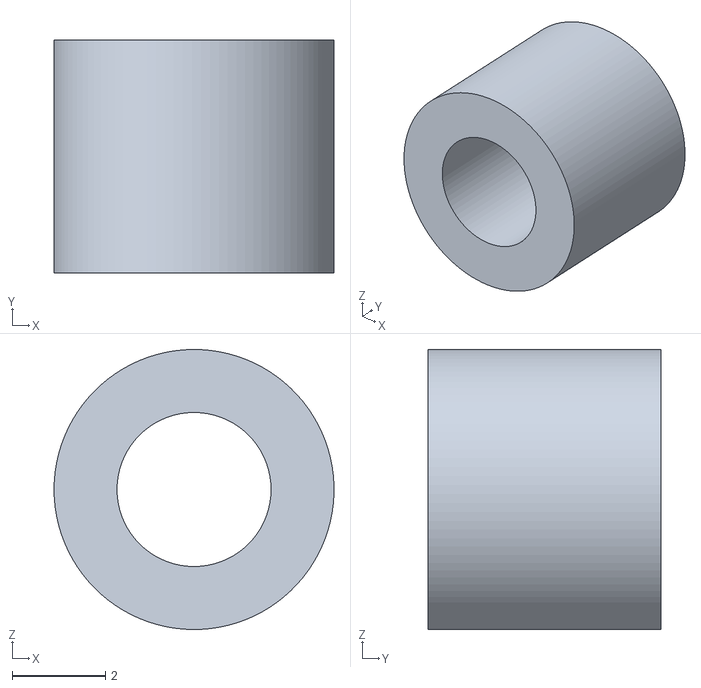
[picture p54: CAD file, 2018-03-31]
cad/stl/pitch6mmBearingAdapter.stl
6.00 x 5.00 x 6.00
