lcall3/Controller/cad/dxf/YawMotorPlate.dxf

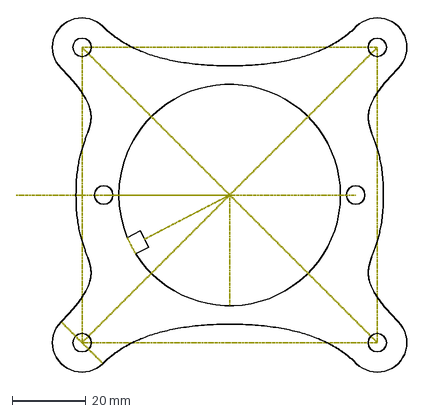
[picture p55: CAD file, 2018-03-27]
cad/dxf/YawMotorPlate.dxf
106.2 x 96.9 mm
