lcall3/Controller/cad/stl/03-31 LaserDiodeAdapter.stl

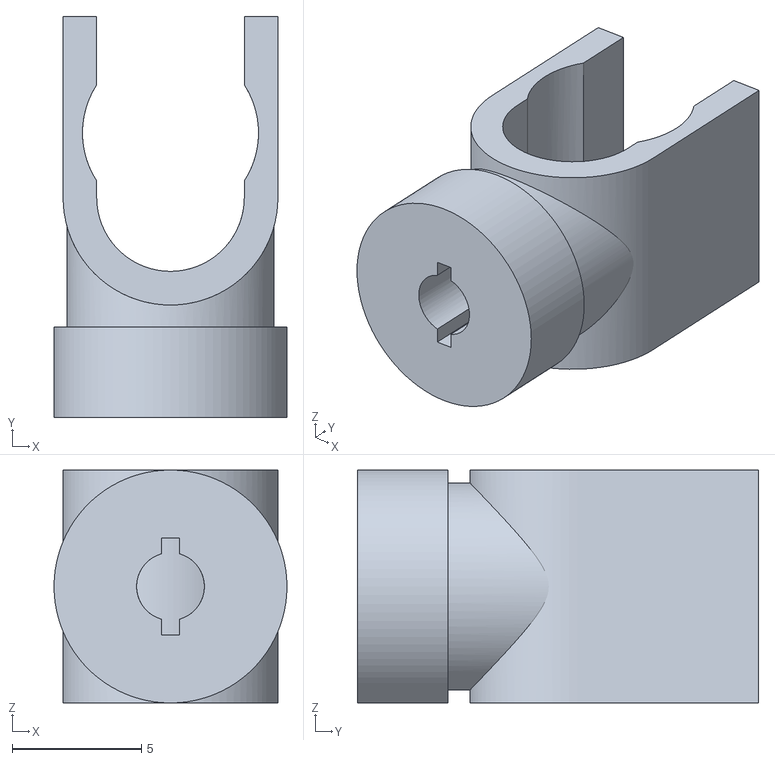
[picture p56: CAD file, 2018-03-31]
cad/stl/03-31 LaserDiodeAdapter.stl
9.00 x 15.5 x 9.00
