lcall3/Controller/cad/stl/pitchThings.stl

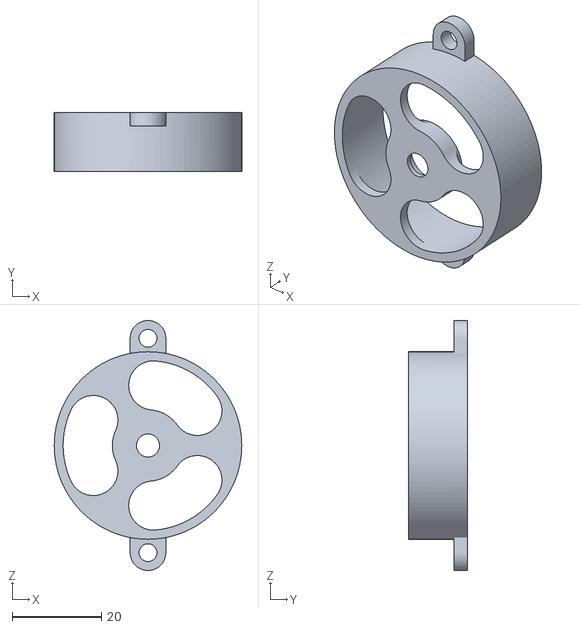
[picture p57: CAD file, 2018-03-31]
cad/stl/pitchThings.stl
42.0 x 13.2 x 56.0
