lcall3/Controller/cad/stl/04-01 EncoderWheelAdapterSmallSlotted.stl

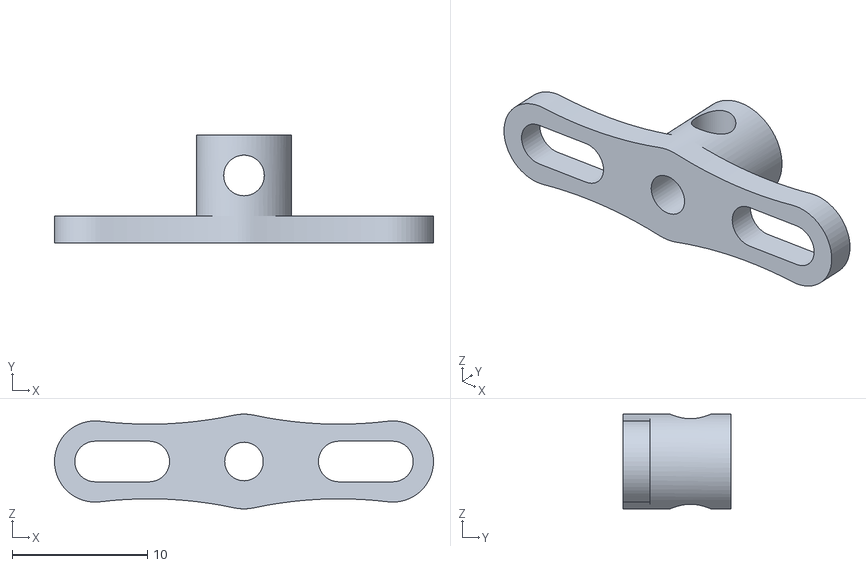
[picture p58: CAD file, 2018-03-31]
cad/stl/04-01 EncoderWheelAdapterSmallSlotted.stl
28.0 x 8.00 x 7.00
