lcall3/Controller/cad/stl/03-31 EncoderWheelAdapterSlotted.stl

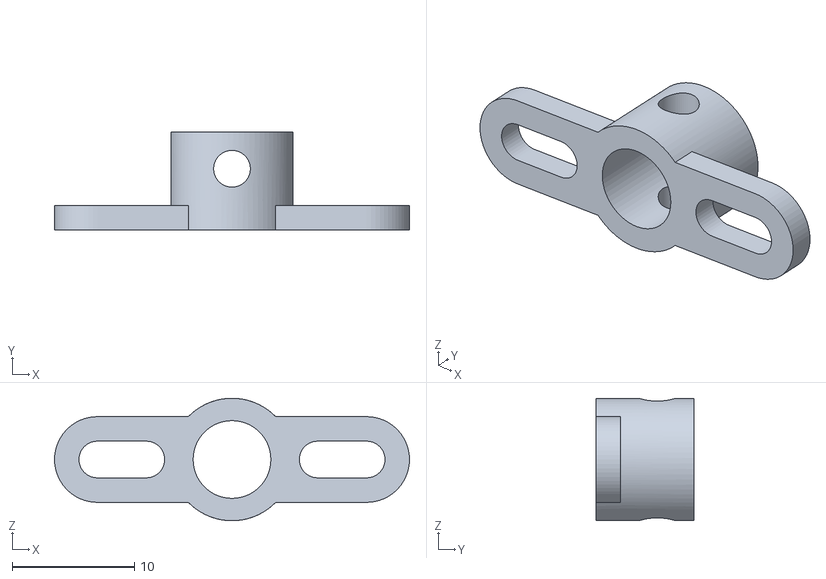
[picture p59: CAD file, 2018-03-31]
cad/stl/03-31 EncoderWheelAdapterSlotted.stl
29.0 x 8.00 x 10.0
