lcall3/Controller/cad/stl/03-31 EncoderWheelAdapterSmall.stl

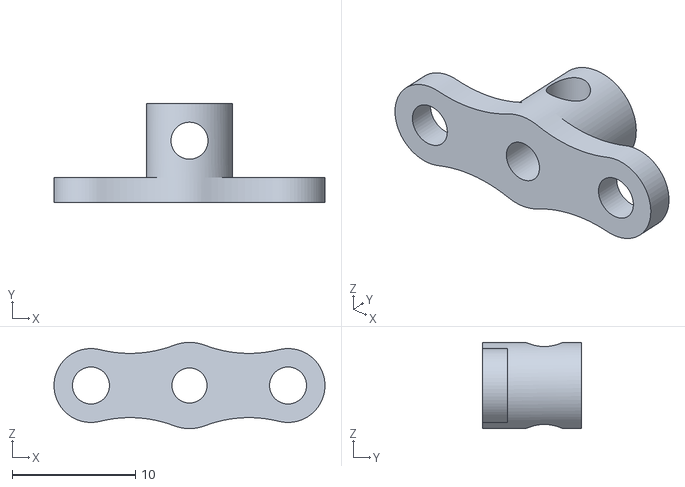
[picture p60: CAD file, 2018-03-31]
cad/stl/03-31 EncoderWheelAdapterSmall.stl
22.0 x 8.00 x 7.00
