lcall3/Controller/cad/stl/pitch_stator_front_attachment_flashlight_v2.stl

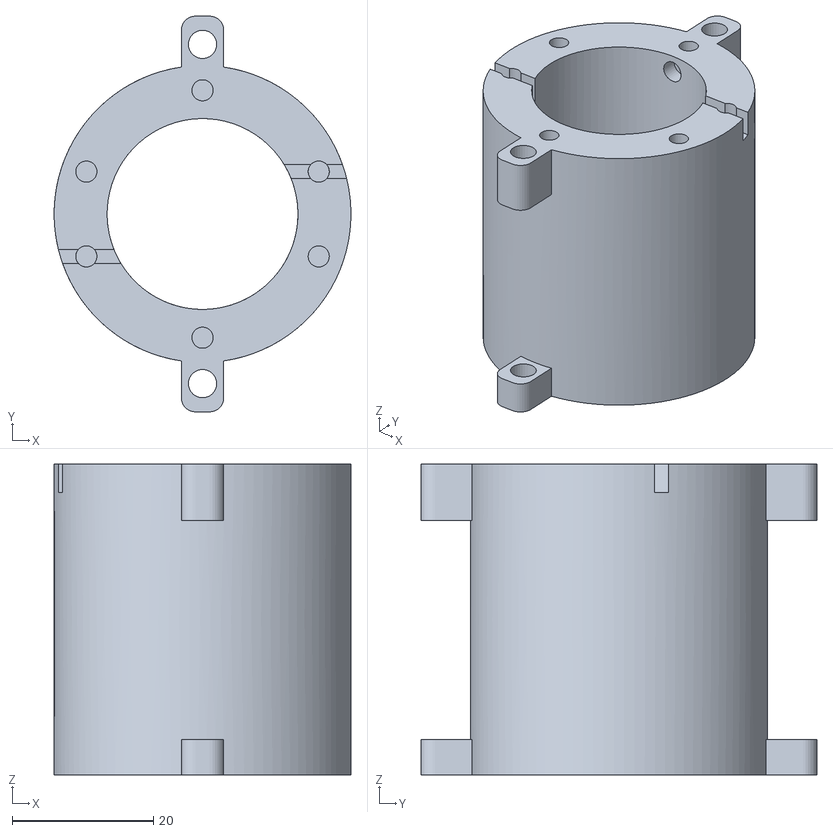
[picture p61: CAD file, 2018-03-31]
cad/stl/pitch_stator_front_attachment_flashlight_v2.stl
42.0 x 56.0 x 44.0
