lcall3/Controller/cad/stl/03-29 GT2Yaw.stl

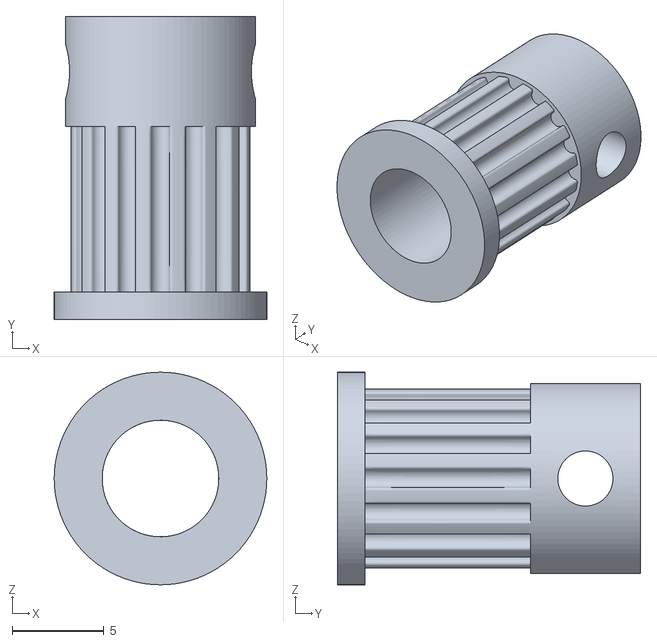
[picture p62: CAD file, 2018-03-30]
cad/stl/03-29 GT2Yaw.stl
11.6 x 16.5 x 11.6
