lcall3/Controller/cad/stl/03-29 YawTopClamp.stl

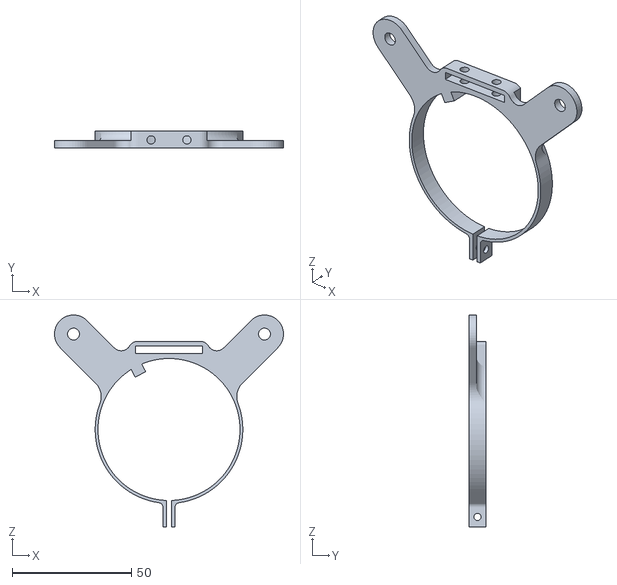
[picture p63: CAD file, 2018-03-30]
cad/stl/03-29 YawTopClamp.stl
96.0 x 7.00 x 88.8
