lcall3/Controller/cad/stl/03-29.stl

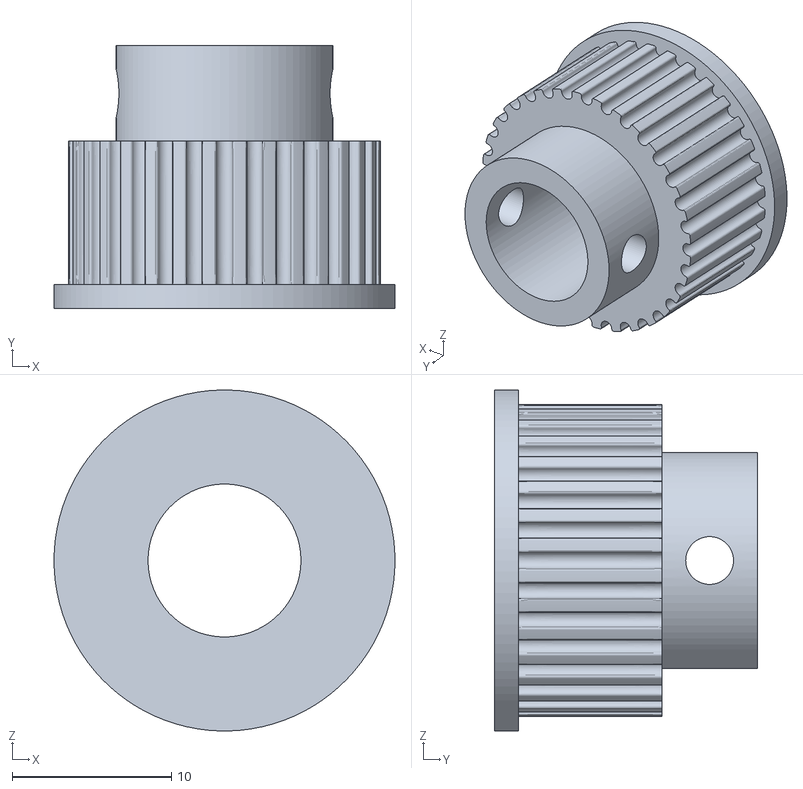
[picture p64: CAD file, 2018-03-30]
cad/stl/03-29.stl
21.4 x 16.5 x 21.4
