lcall3/Controller/cad/stl/04-01 OmegaRingTypeC.stl

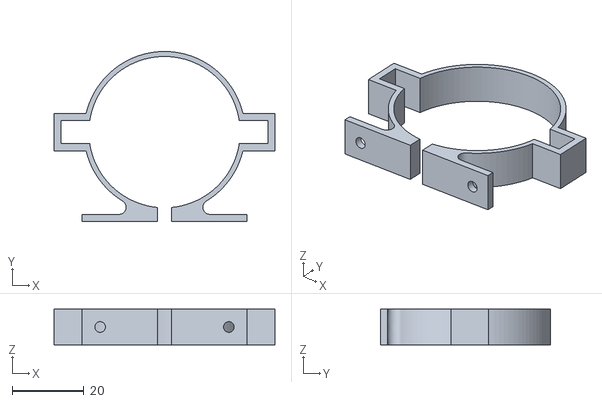
[picture p65: CAD file, 2018-03-30]
cad/stl/04-01 OmegaRingTypeC.stl
61.8 x 47.5 x 10.0
