lcall3/Controller/cad/stl/03-29 ShaftArm.stl

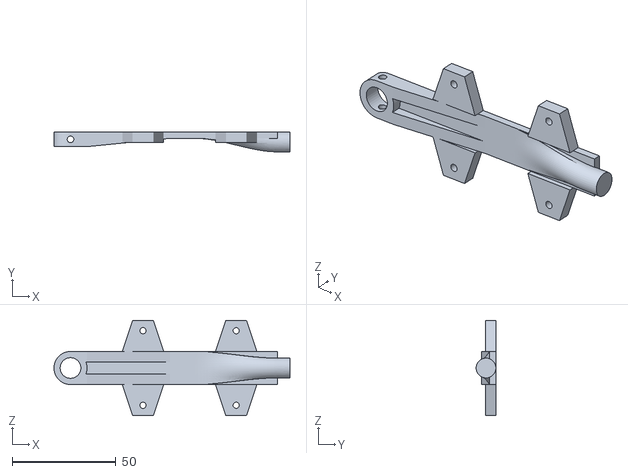
[picture p66: CAD file, 2018-03-30]
cad/stl/03-29 ShaftArm.stl
114.0 x 9.53 x 46.0
