lcall3/Controller/cad/STL/03-05 Pok Mk3 Yaw Motor Support.stl

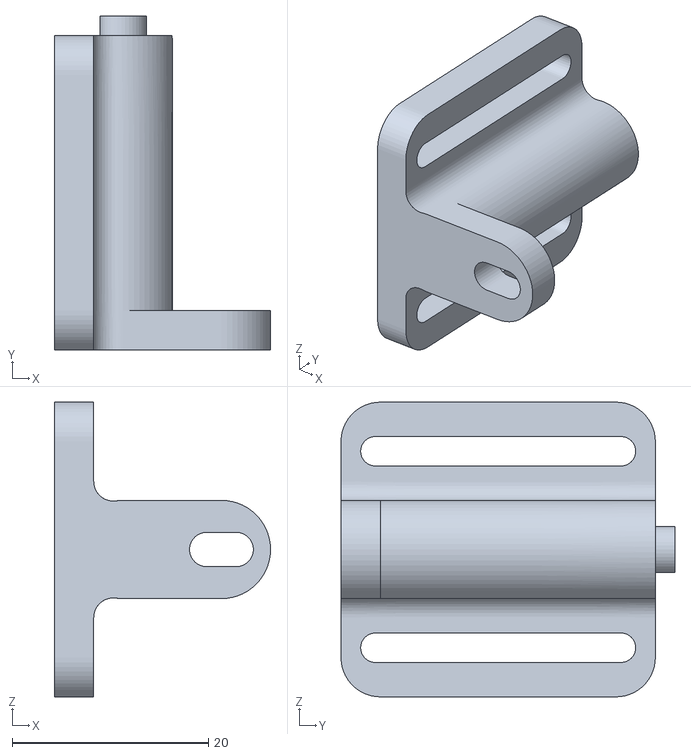
[picture p67: CAD file, 2018-03-06]
cad/STL/03-05 Pok Mk3 Yaw Motor Support.stl
22.0 x 34.0 x 30.0
