lcall3/Controller/cad/STL/03-05 ER Pok Mk3 Support .stl

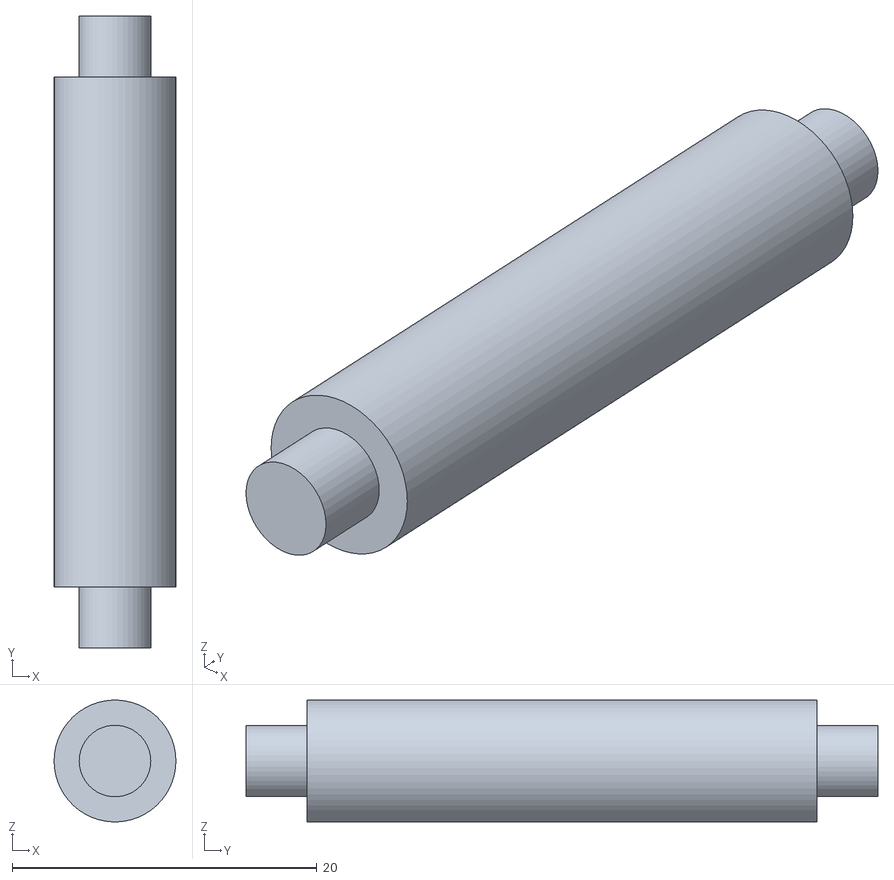
[picture p68: CAD file, 2018-03-06]
cad/STL/03-05 ER Pok Mk3 Support .stl
8.00 x 41.5 x 7.99
