lcall3/Controller/cad/STL/03-05 Pok Mk3 Base.stl

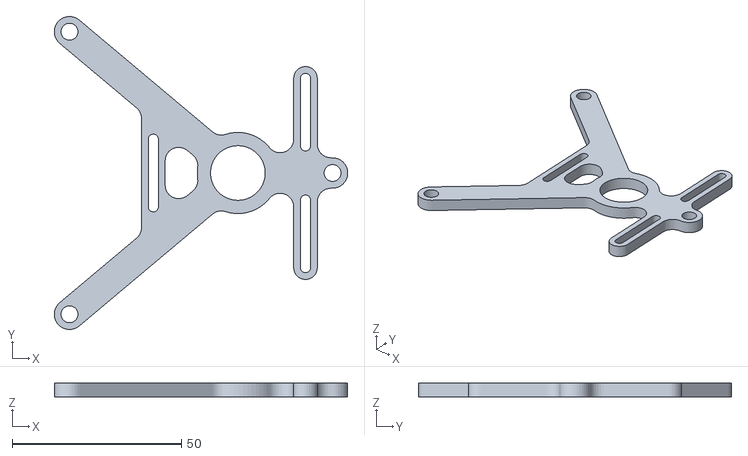
[picture p69: CAD file, 2018-03-06]
cad/STL/03-05 Pok Mk3 Base.stl
86.8 x 92.6 x 4.00
