lcall3/Controller/cad/STL/03-04 GT2 Gear Big.stl

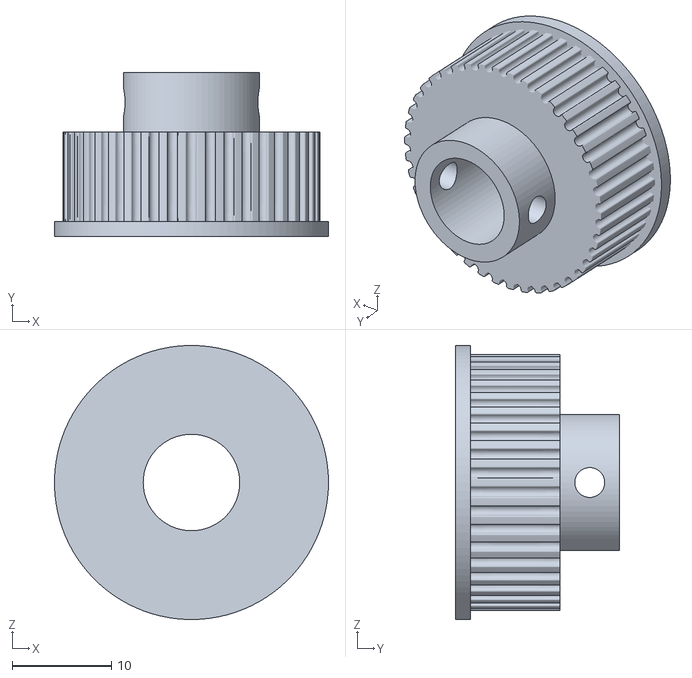
[picture p70: CAD file, 2018-03-05]
cad/STL/03-04 GT2 Gear Big.stl
27.5 x 16.5 x 27.5
