lcall3/Controller/cad/STL/03-04 Yaw Platform Top.stl

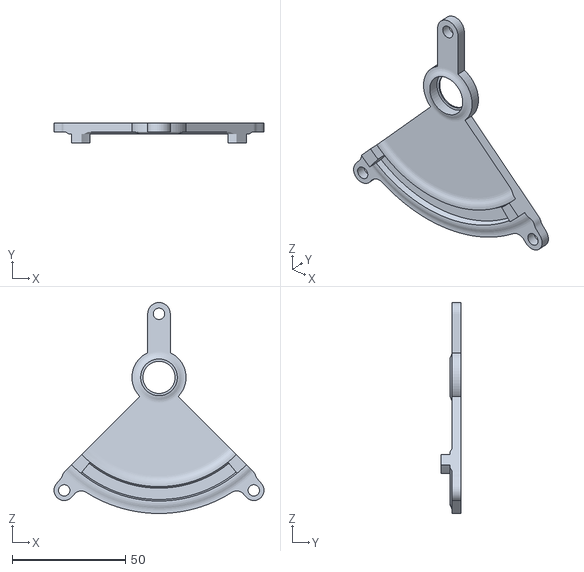
[picture p71: CAD file, 2018-03-05]
cad/STL/03-04 Yaw Platform Top.stl
92.6 x 9.00 x 93.0
