lcall3/Controller/cad/STL/03-04 Pok Mk3 Yaw Motor Mount Mk2.stl

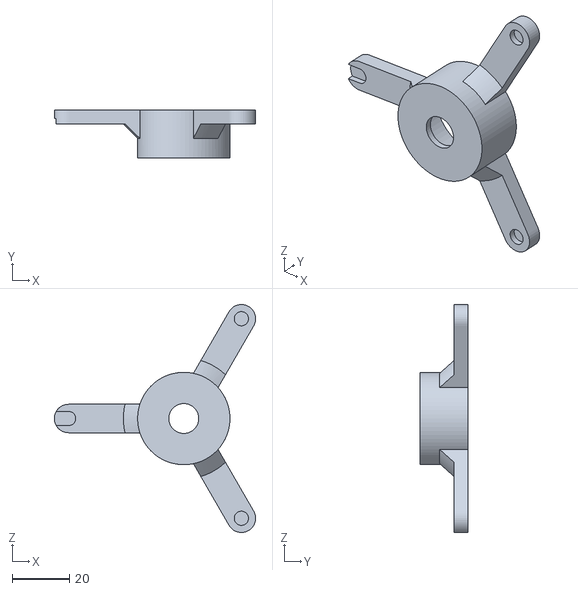
[picture p72: CAD file, 2018-03-05]
cad/STL/03-04 Pok Mk3 Yaw Motor Mount Mk2.stl
70.6 x 17.0 x 80.0
