lcall3/Controller/cad/STL/03-04 GT2 Gear Pinion.stl

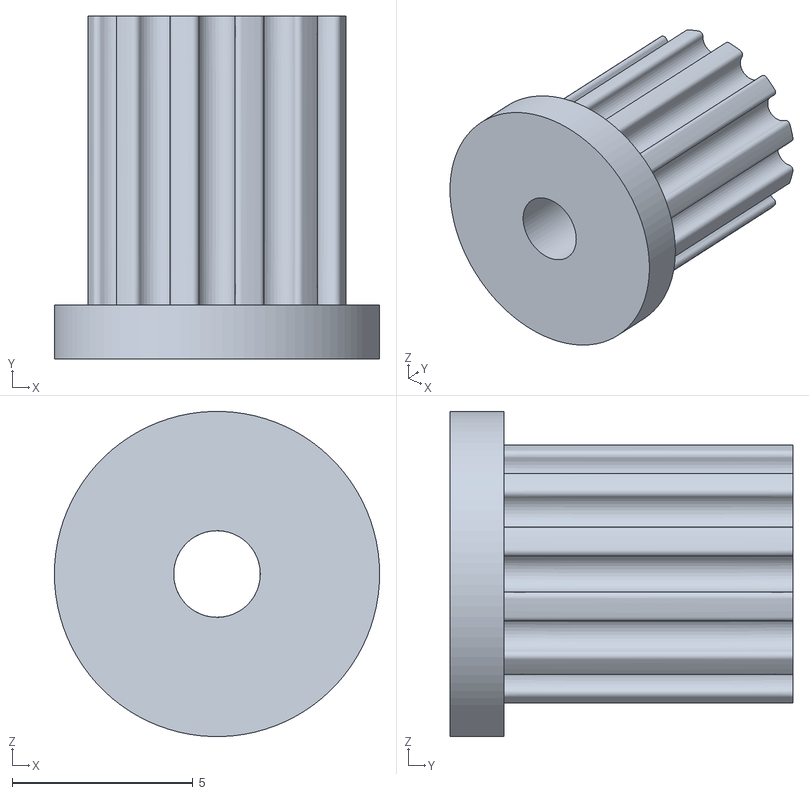
[picture p73: CAD file, 2018-03-05]
cad/STL/03-04 GT2 Gear Pinion.stl
9.01 x 9.50 x 9.00
