lcall3/Controller/CAD/STL/feb28 Pok Mk3 Yaw Motor Mount Mk2.stl

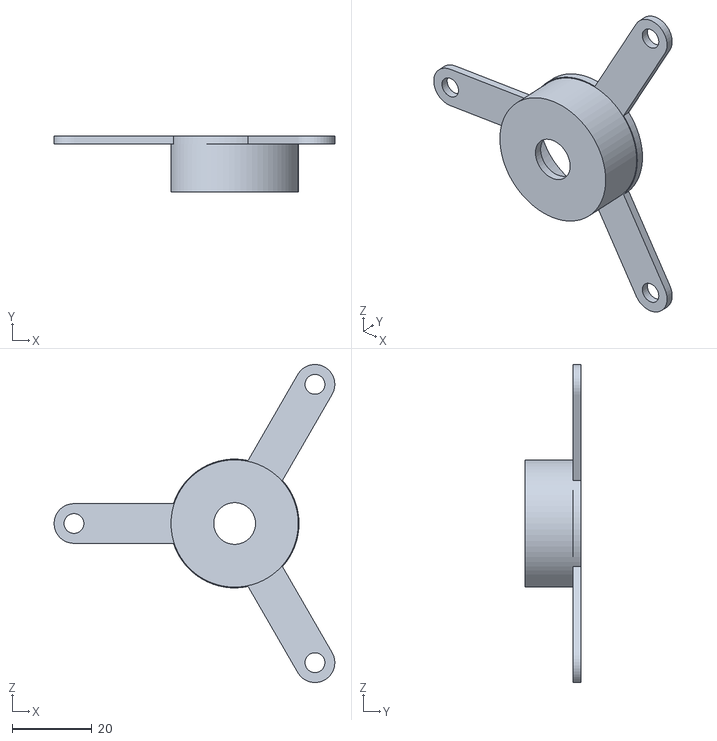
[picture p74: CAD file, 2018-03-02]
CAD/STL/feb28 Pok Mk3 Yaw Motor Mount Mk2.stl
70.6 x 14.0 x 80.0
