lcall3/Controller/CAD/STL/feb28 Pok Mk3 Yaw Motor Support.stl

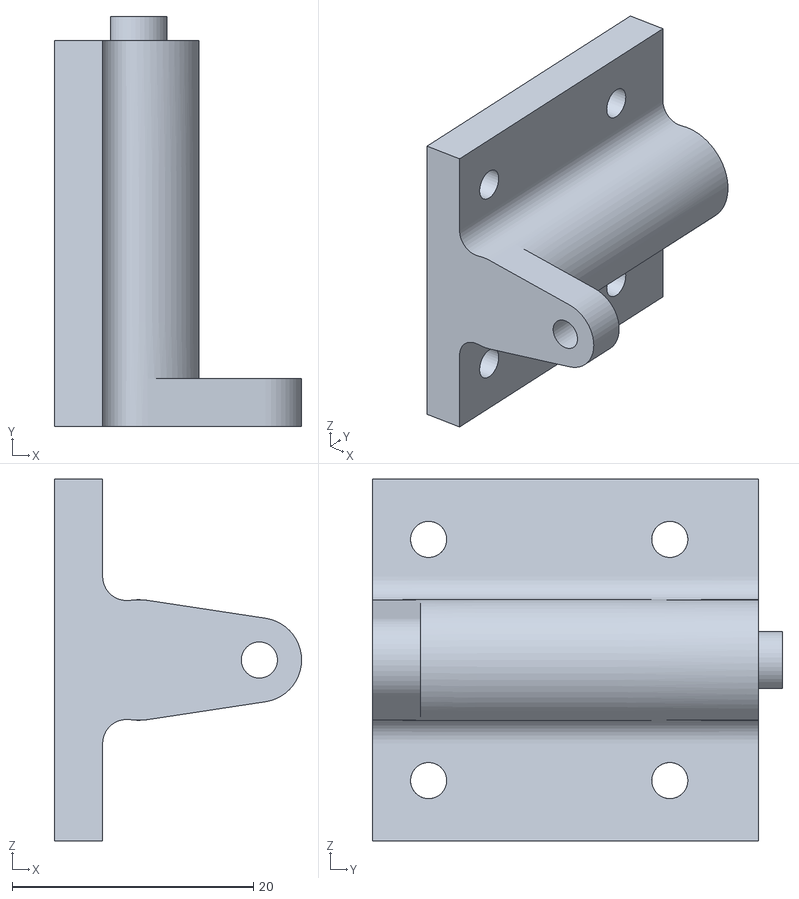
[picture p75: CAD file, 2018-03-02]
CAD/STL/feb28 Pok Mk3 Yaw Motor Support.stl
20.5 x 34.0 x 30.0
