lcall3/Controller/CAD/STL/feb28 Pok Mk3 Yaw Motor Support Min.stl

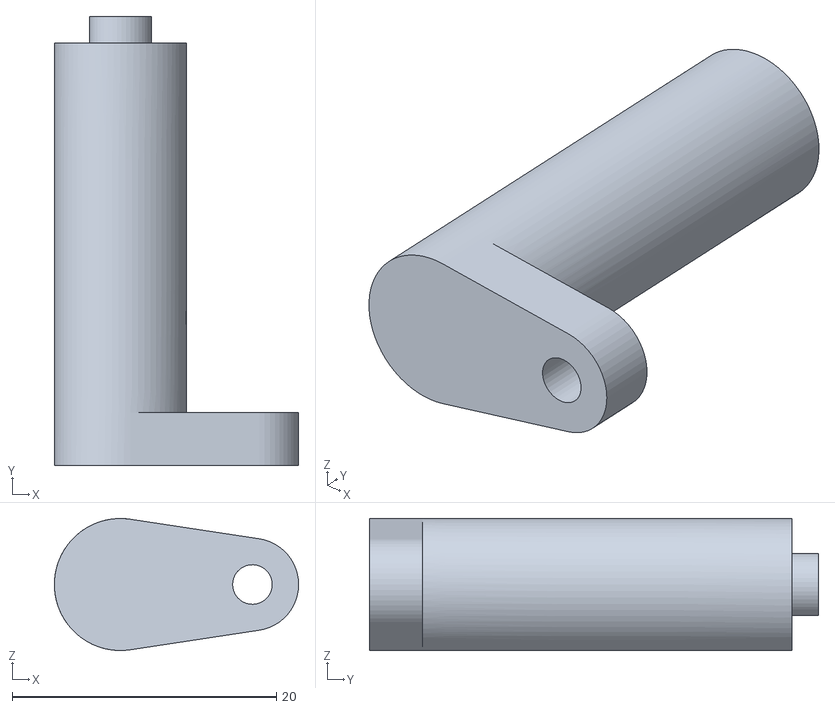
[picture p76: CAD file, 2018-03-02]
CAD/STL/feb28 Pok Mk3 Yaw Motor Support Min.stl
18.5 x 34.0 x 10.00
