lcall3/Controller/CAD/STL/GT2 Gear Big.stl

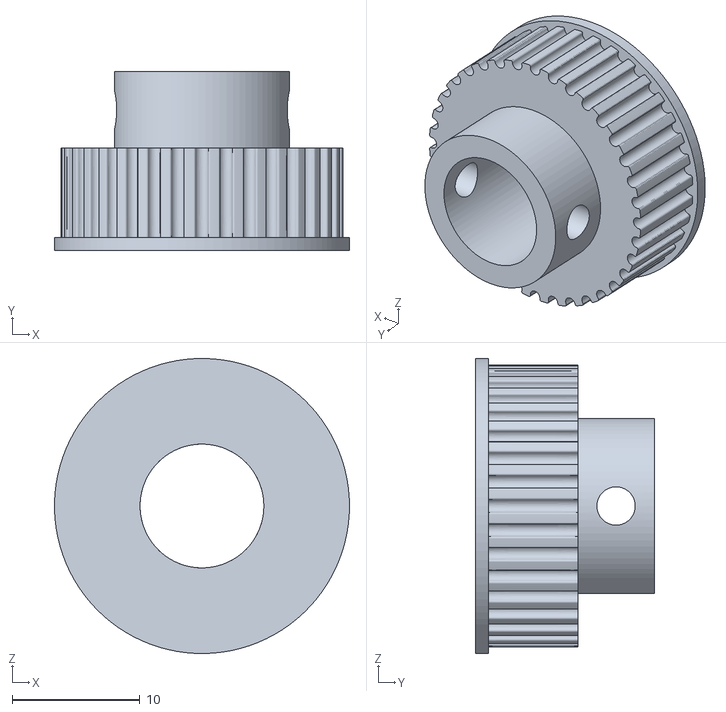
[picture p77: CAD file, 2018-02-28]
CAD/STL/GT2 Gear Big.stl
23.1 x 14.0 x 23.1
