lcall3/Controller/CAD/STL/Feb13 - Test GT2 Gear.stl

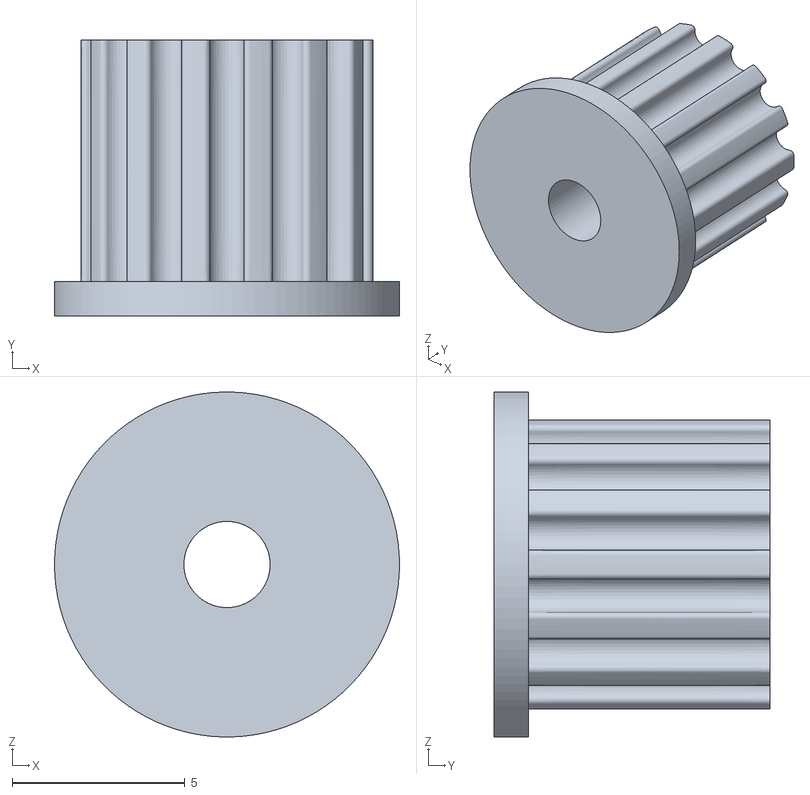
[picture p78: CAD file, 2018-02-14]
CAD/STL/Feb13 - Test GT2 Gear.stl
10.0 x 8.00 x 9.99
