lcall3/Controller/CAD/STL/Feb13 - Pok Base.stl

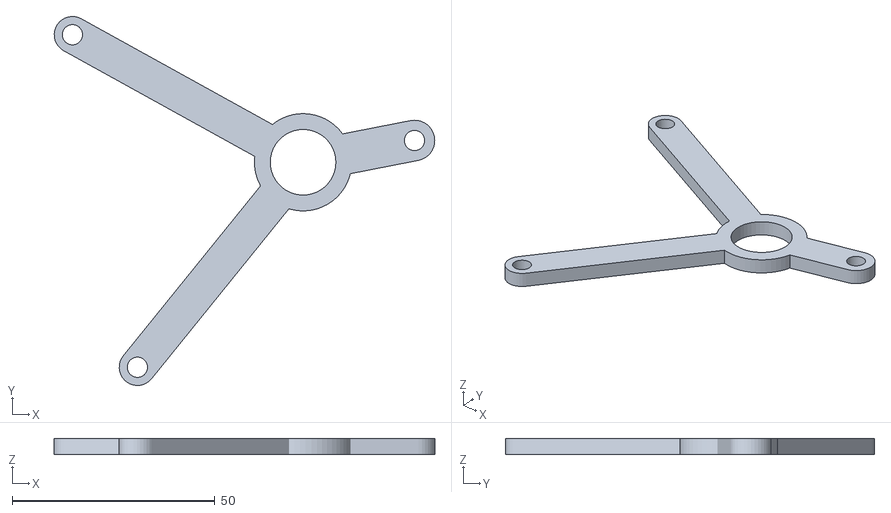
[picture p79: CAD file, 2018-02-14]
CAD/STL/Feb13 - Pok Base.stl
93.9 x 91.0 x 4.00
