lcall3/Controller/CAD/STL/Feb13 - Default Test motor mount.stl

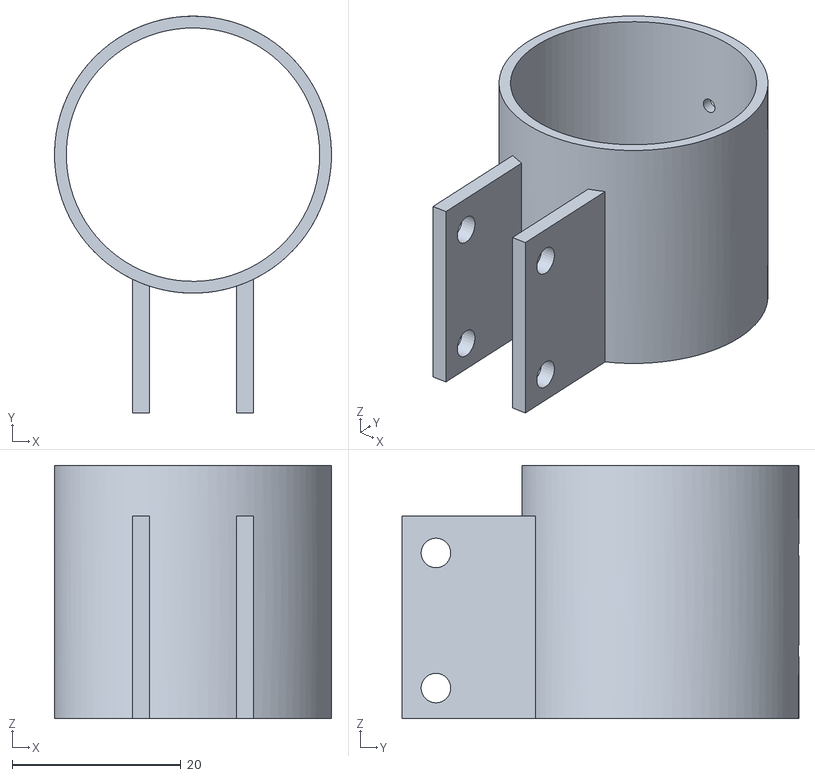
[picture p80: CAD file, 2018-02-14]
CAD/STL/Feb13 - Default Test motor mount.stl
32.8 x 47.0 x 30.0
