lcall3/Controller/CAD/STL/GT2 16 Teeth Free Pulley.stl

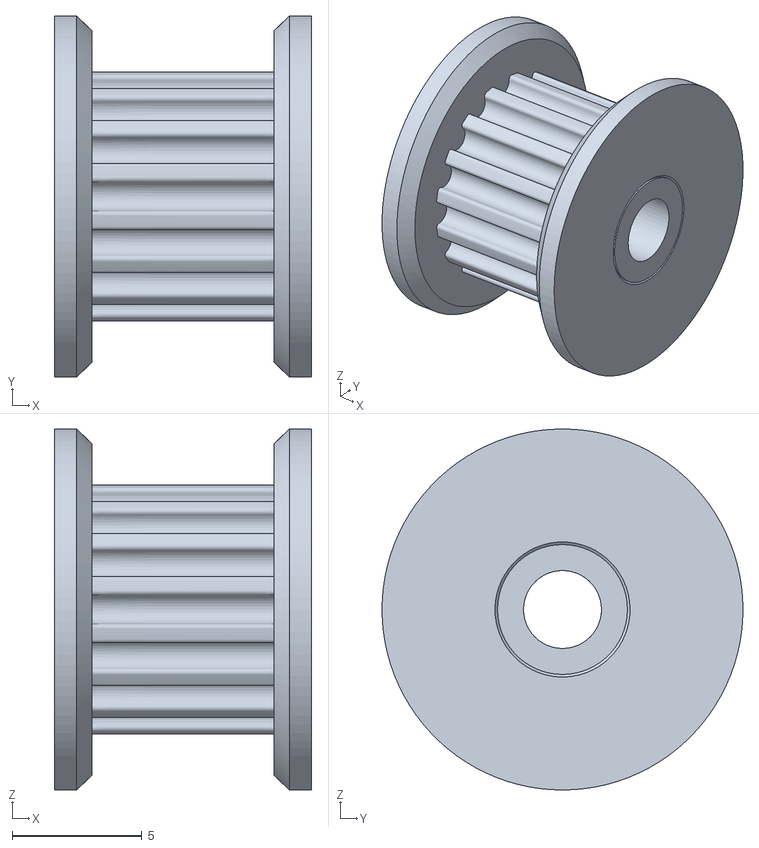
[picture p81: CAD file, 2018-02-14]
CAD/STL/GT2 16 Teeth Free Pulley.stl
9.90 x 13.9 x 13.9
