lcall3/Controller/cad/STL/03-05 Pok Mk3 Support.stl

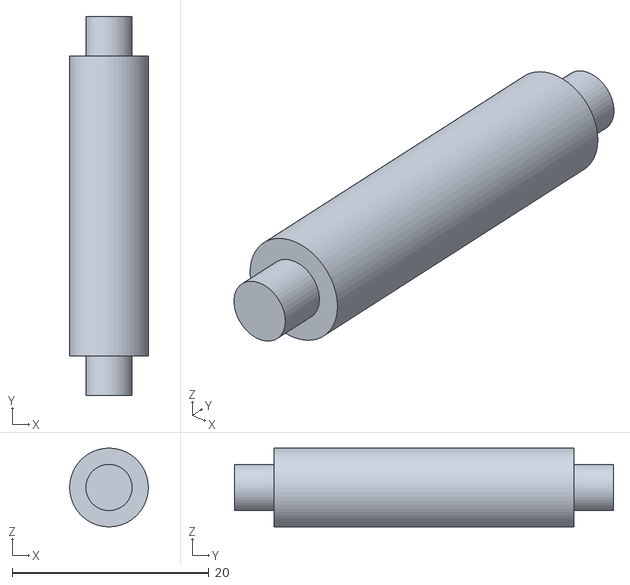
[picture p82: CAD file, 2018-02-13]
cad/STL/03-05 Pok Mk3 Support.stl
8.00 x 38.5 x 8.00
