lcall3/Controller/CAD/STL/Feb13 - Pok Header Mount.stl

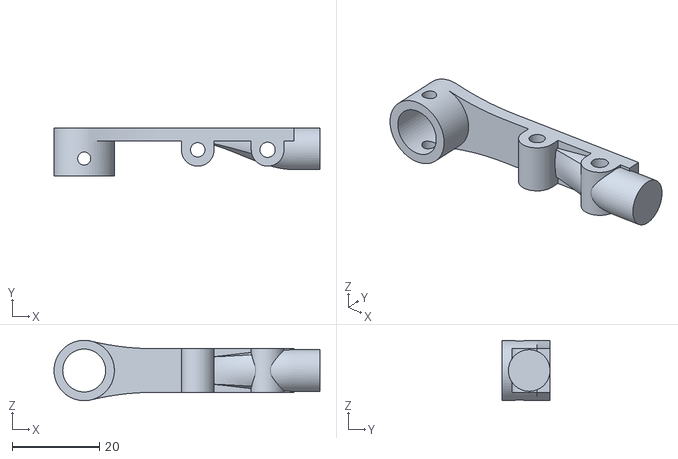
[picture p83: CAD file, 2018-02-13]
CAD/STL/Feb13 - Pok Header Mount.stl
60.9 x 11.0 x 13.8
