lcall3/Controller/CAD/STL/Feb13 - Yaw Platform Top.stl

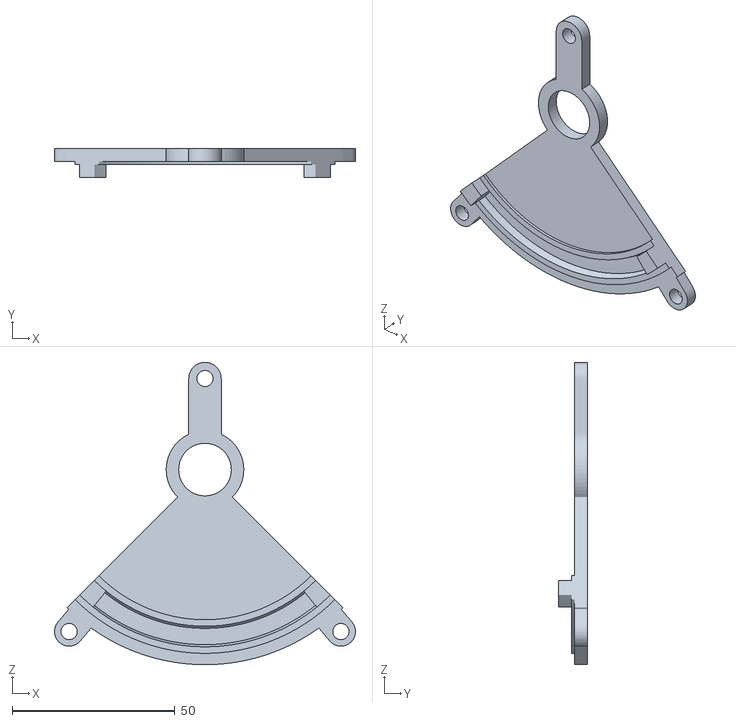
[picture p84: CAD file, 2018-02-13]
CAD/STL/Feb13 - Yaw Platform Top.stl
92.6 x 9.00 x 93.0
