lcall3/Controller/CAD/STL/Pok Yaw Motor Face Mount.stl

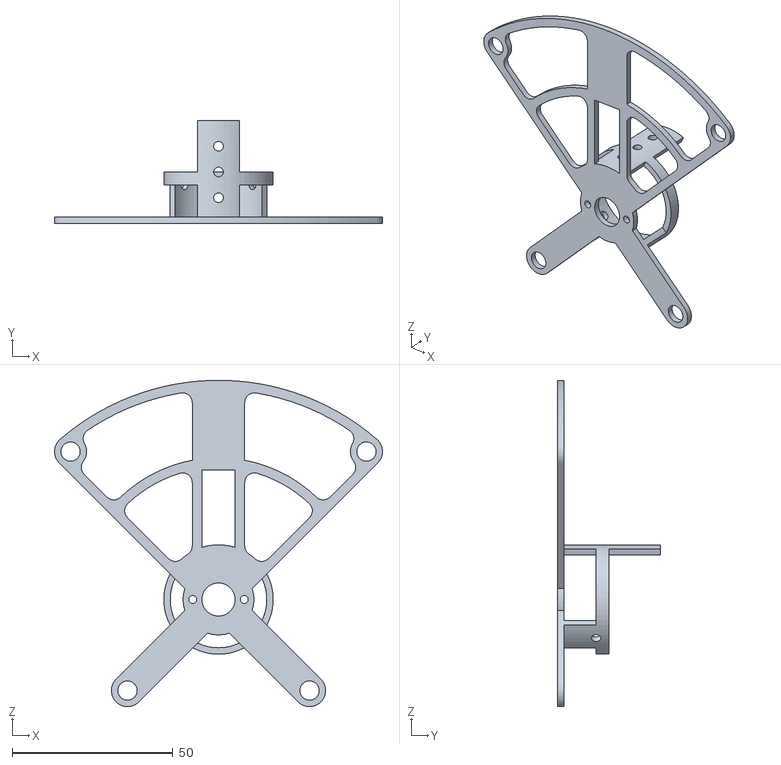
[picture p85: CAD file, 2018-02-07]
CAD/STL/Pok Yaw Motor Face Mount.stl
101.9 x 32.0 x 101.4
