lcall3/Controller/CAD/STL/Encoder Mount.stl

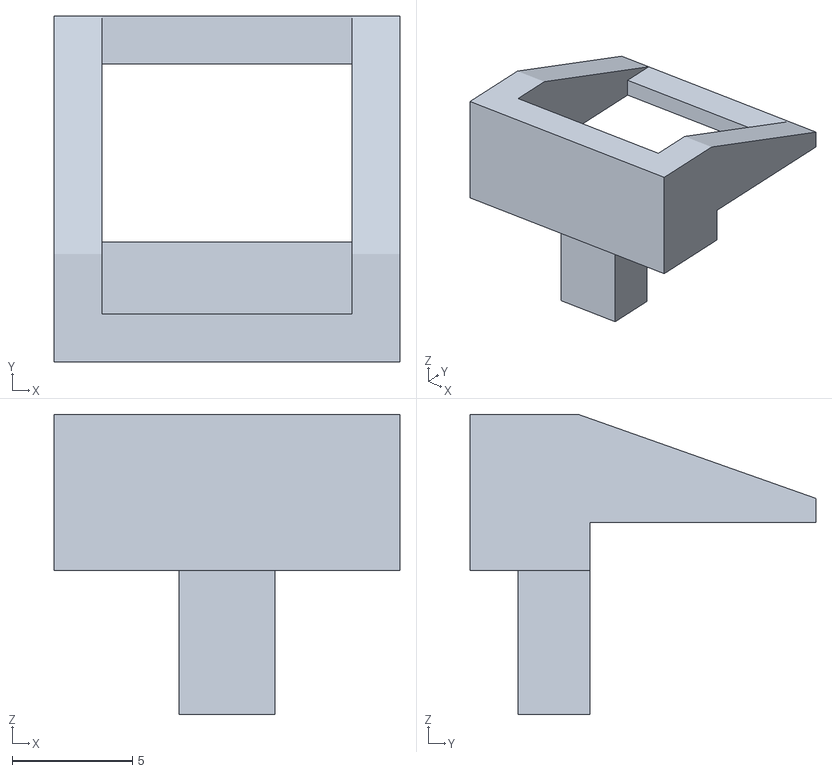
[picture p86: CAD file, 2018-01-30]
CAD/STL/Encoder Mount.stl
14.4 x 14.4 x 12.5
