lcall3/Controller/CAD/STL/Jan25 - Laser Mount.stl

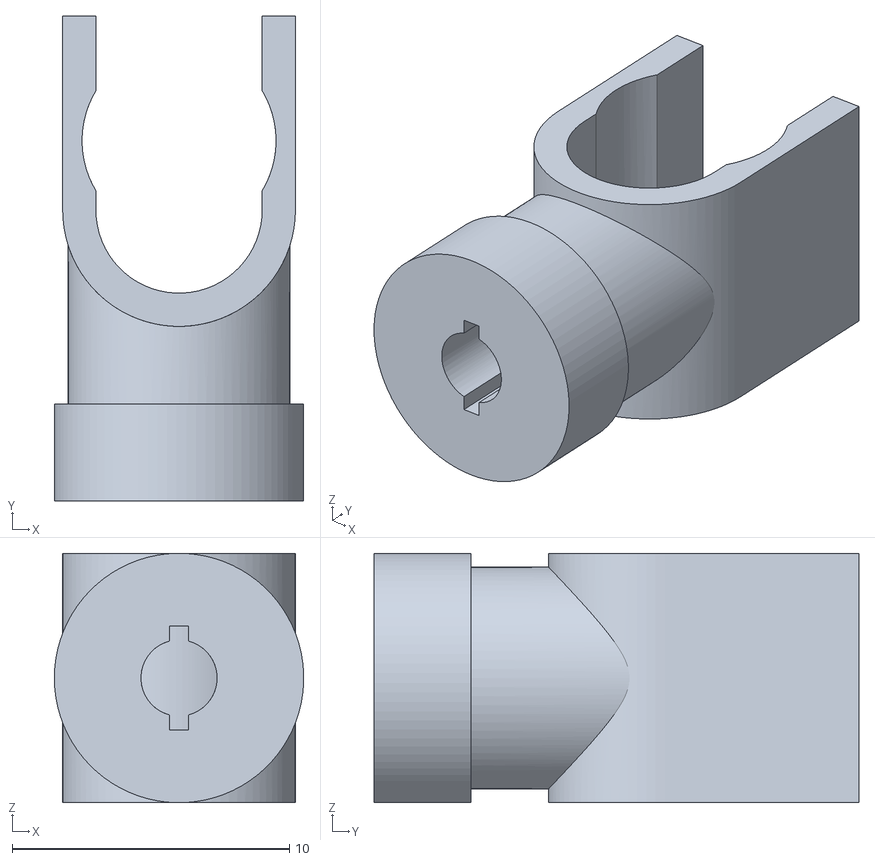
[picture p88: CAD file, 2018-01-29]
CAD/STL/Jan25 - Laser Mount.stl
9.00 x 17.5 x 9.00
