lcall3/Controller/CAD/STL/Jan25 - Motor Mount Slot Lock.stl

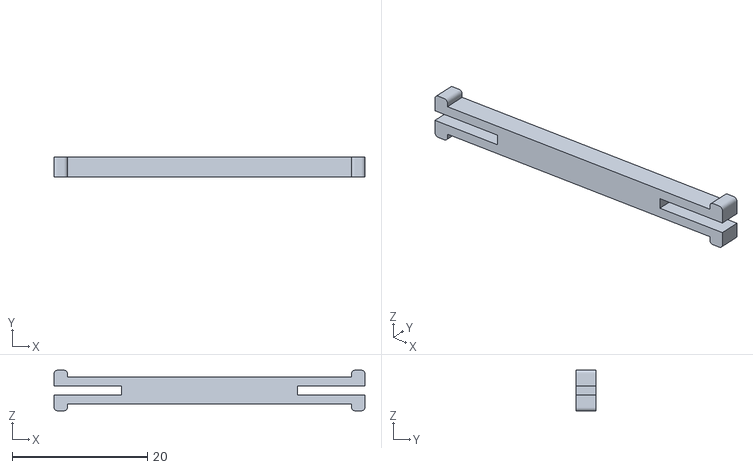
[picture p89: CAD file, 2018-01-29]
CAD/STL/Jan25 - Motor Mount Slot Lock.stl
46.0 x 3.00 x 6.00
