lcall3/Controller/CAD/STL/Jan25 - Motor Reversed Mount.stl

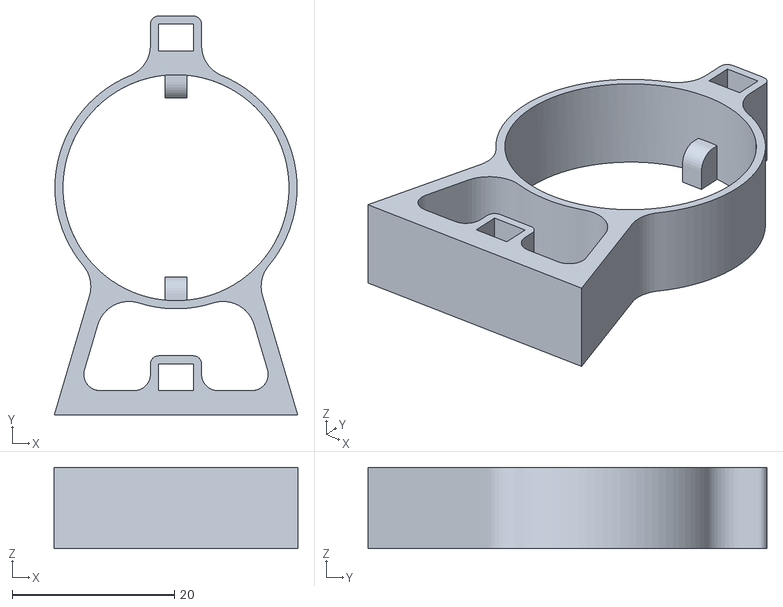
[picture p90: CAD file, 2018-01-29]
CAD/STL/Jan25 - Motor Reversed Mount.stl
30.0 x 49.1 x 10.0
