lcall3/Controller/CAD/STL/Jan25 - Motor Reversed Mount Midsection.stl

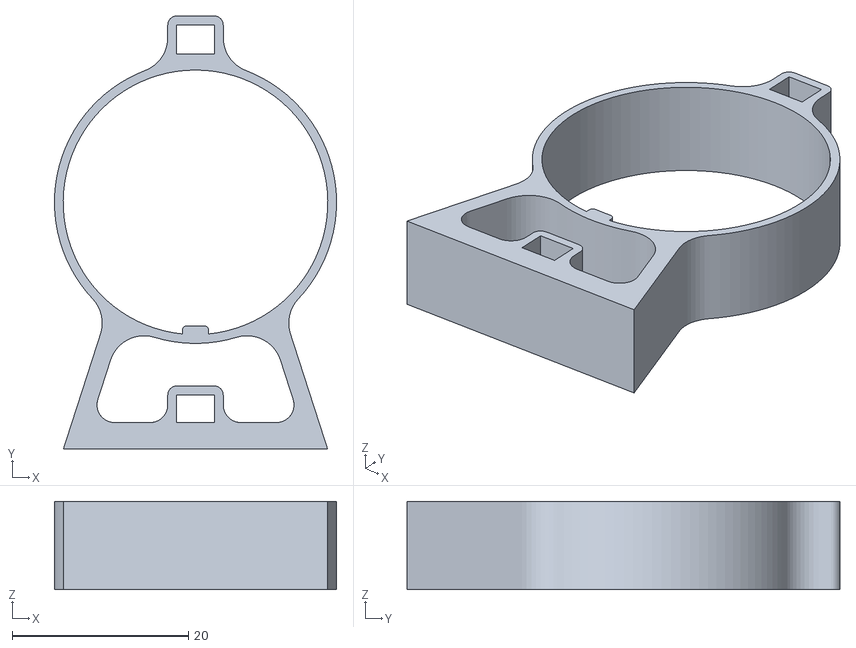
[picture p91: CAD file, 2018-01-29]
CAD/STL/Jan25 - Motor Reversed Mount Midsection.stl
32.0 x 49.1 x 10.0
