lcall3/Controller/cad/STL/Encoder Wheel.STL

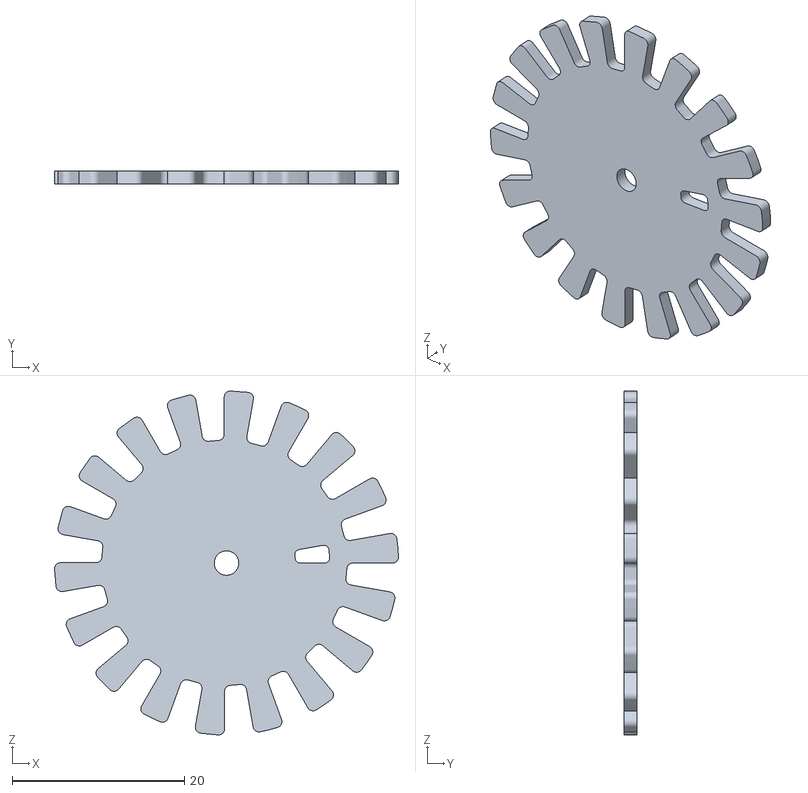
[picture p92: CAD file, 2018-01-24]
cad/STL/Encoder Wheel.STL
40.0 x 1.50 x 40.0
