lcall3/Controller/CAD/STL/Rotary Encoder Mount Mk2.stl

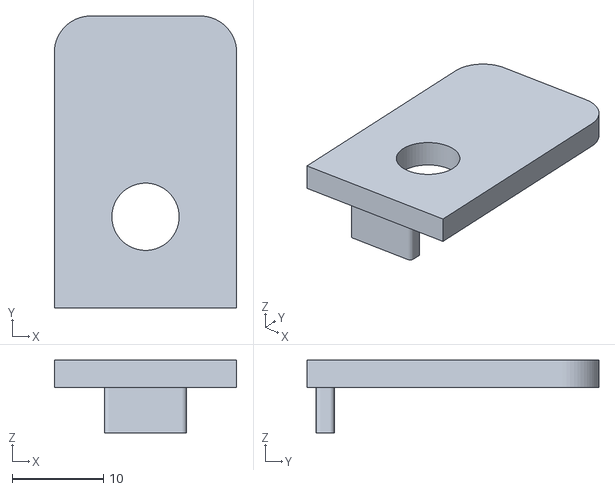
[picture p93: CAD file, 2018-01-24]
CAD/STL/Rotary Encoder Mount Mk2.stl
20.0 x 32.0 x 8.00
