lcall3/Controller/CAD/STL/Motor Shaft Gear.stl

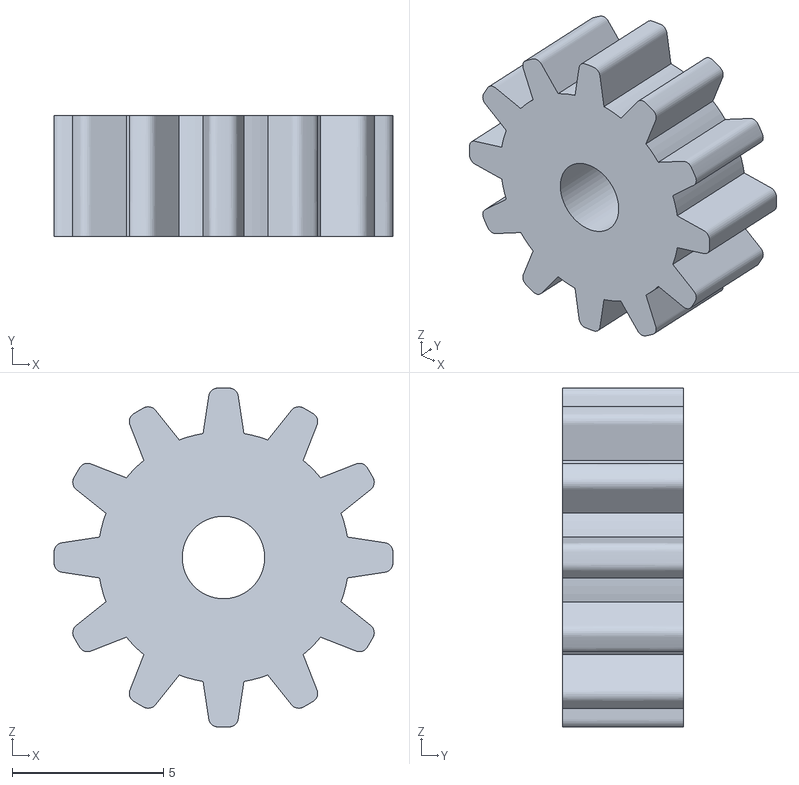
[picture p94: CAD file, 2018-01-24]
CAD/STL/Motor Shaft Gear.stl
11.2 x 4.00 x 11.2
