lcall3/Controller/CAD/STL/Motor Face Mount Mk2.stl

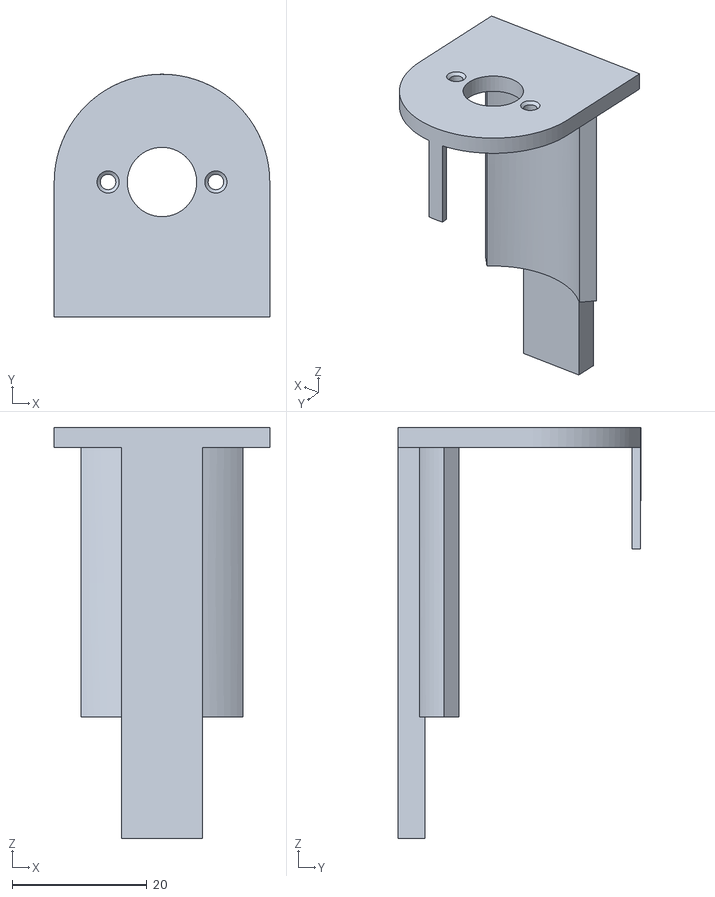
[picture p95: CAD file, 2018-01-24]
CAD/STL/Motor Face Mount Mk2.stl
32.0 x 36.0 x 61.0
