lcall3/Controller/CAD/STL/Motor Rotary Encoder Coupler.stl

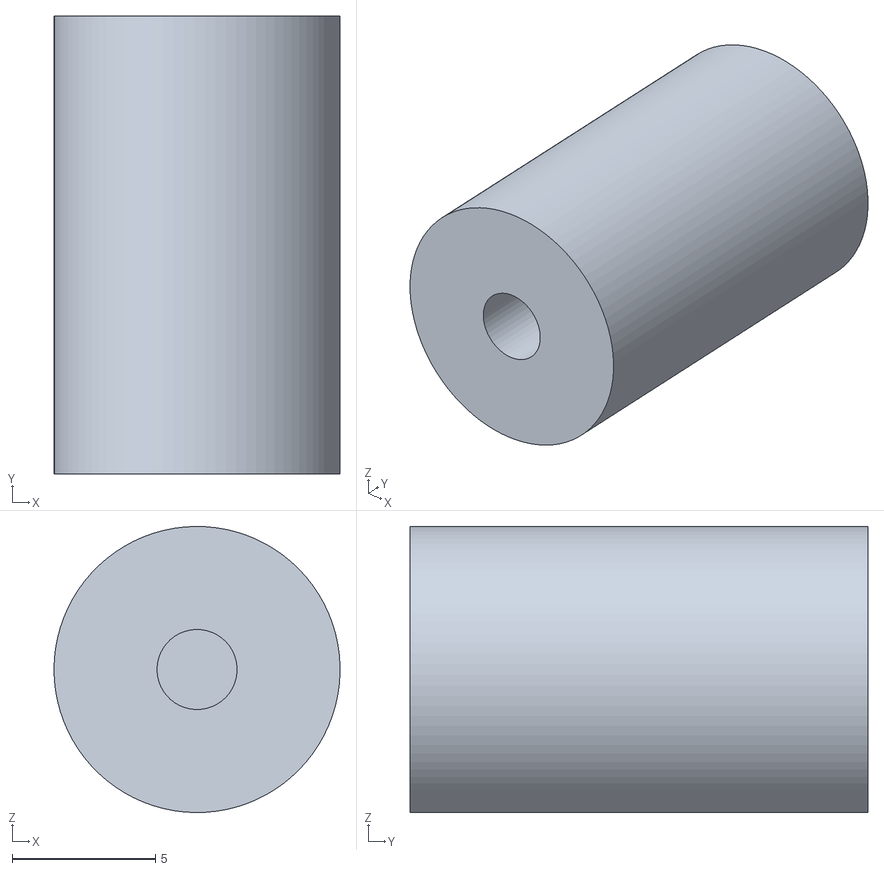
[picture p96: CAD file, 2018-01-16]
CAD/STL/Motor Rotary Encoder Coupler.stl
10.00 x 16.0 x 10.00
