lcall3/Controller/CAD/STL/Laser Mount.stl

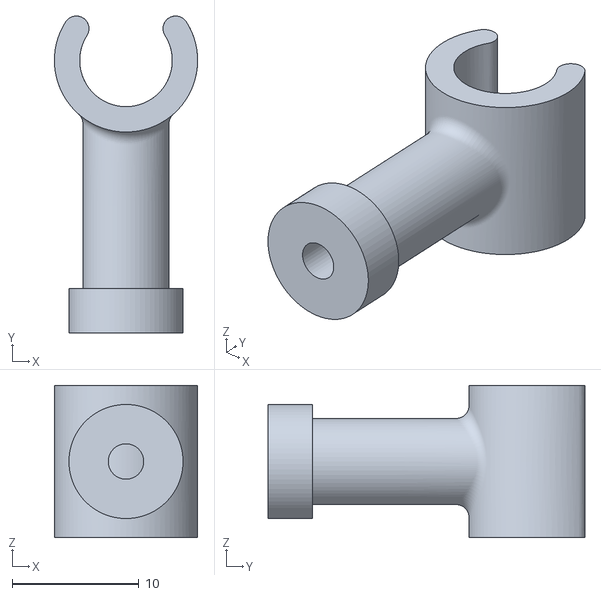
[picture p97: CAD file, 2018-01-16]
CAD/STL/Laser Mount.stl
11.3 x 25.0 x 12.0
