lcall3/Controller/CAD/STL/Motor Face Mount.stl

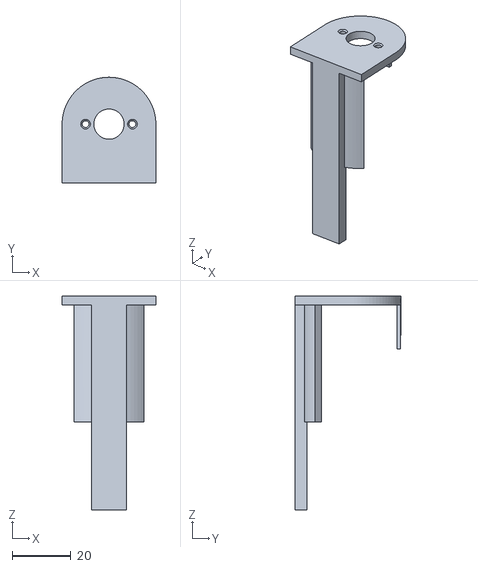
[picture p98: CAD file, 2018-01-13]
CAD/STL/Motor Face Mount.stl
32.0 x 36.0 x 73.0
