lcall3/Controller/(list of files, cad)

Other CAD files:
cad/stl/04-02 GT2Yaw1p94wide.stl
cad/stl/03-29 OmegaRing.stl
CAD/STL/Motor Shaft Gear E.stl
CAD/STL/Rotary Encoder Mount.stl
CAD/Brass Bushing.ipt
CAD/Default Motor Testbench Mk1.iam
CAD/Default Motor Testbench Mk2.iam
CAD/Default Motor Testbench Mk3.iam
CAD/Default Motor Testbench Mk4-1.idw
CAD/Default Motor Testbench Mk4.iam
CAD/Default Motor Testbench Mk4.ipn
CAD/Encoder Mount.ipt
CAD/Encoder Wheel (G16).ipt
CAD/Encoder Wheel With Holes(G16).ipt
CAD/GP1A52HRJ00F (Large slot detector).ipt
CAD/GT2 16 Teeth Free Pulley.ipt
CAD/GT2 Gear Pinion.ipt
CAD/GT2 Gear.ipt
CAD/JD5B-2655W-R.ipt
CAD/Laser Mount Mk2.ipt
CAD/Laser Mount.ipt
CAD/Motor Face Mount Mk2.ipt
CAD/Motor Face Mount.ipt
CAD/Motor Mount C-Clamp Base.ipt
CAD/Motor Mount C-Clamp Top.ipt
CAD/Motor Mount Slot Lock.ipt
CAD/Motor Reversed Mount Midsection.ipt
CAD/Motor Reversed Mount.ipt
CAD/Motor Rotary Encoder Coupler.ipt
CAD/Motor Shaft Gear E.ipt
CAD/Motor Shaft Gear.ipt
CAD/Nylon M3 4mm Spacer.ipt
CAD/PEC12R-4017F-N0024 Base.ipt
CAD/PEC12R-4017F-N0024 Shaft.ipt
CAD/PEC12R-4017F-N0024.iam
CAD/Pok Default Pitch Motor Mount.ipt
CAD/Pok Header Mount.ipt
CAD/Pok Mk 3 Yaw Motor Mount.ipt
CAD/Pok Mk1.iam
CAD/Pok Mk2.iam
CAD/Pok Mk3 Base.ipt
CAD/Pok Mk3 Support.ipt
CAD/Pok Mk3 Yaw Motor Mount Mk2.ipt
CAD/Pok Mk3 Yaw Motor Support Min.ipt
CAD/Pok Mk3 Yaw Motor Support.ipt
CAD/Pok Mk3-DESKTOP-CU9Q4HD.iam
CAD/Pok Mk3.iam
CAD/Pok Washer I2mmO5mm.ipt
CAD/Pok X-Carriage Bottom Support.ipt
CAD/Pok X-Carriage Top Support.ipt
CAD/Pok Y-Carriage.ipt
CAD/Pok Yaw Motor Face Mount Mk2.ipt
CAD/Pok Yaw Motor Face Mount.ipt
CAD/Rod 3-8in Shortened.ipt
CAD/Rod 3-8in.ipt
CAD/Rotary Encoder Mount Mk2.ipt
CAD/Rotary Encoder Mount.ipt
CAD/Shaft Encoder Adapter.ipt
CAD/Shaft Washer.ipt
CAD/Slot Detector Holder.ipt
CAD/Yaw Platform Top.ipt
cad/Belt.ipt
cad/Demo2 Drawings.idw
cad/PitchMotor.iam
cad/Pok Mk3 Demo.iam
cad/Pok Mk3 Demo.ipn
cad/RailBaseBottom.idw
cad/ShaftSyncAdapter.ipt
cad/release/40x40x10 DC Fan.ipt
cad/release/Belt.ipt
cad/release/Board.ipt
cad/release/ControlBox.iam
cad/release/ControlBox.ipn
cad/release/ControlBoxFace.ipt
cad/release/ControlBoxFlatFace.ipt
cad/release/ControlBoxSide.ipt
cad/release/ControlBoxSidePower.ipt
cad/release/ControlBoxTop.ipt
cad/release/CurrentDriver1.iam
cad/release/CurrentDriver2.iam
cad/release/D1.iam
cad/release/D2.iam
cad/release/D3.iam
cad/release/D4.iam
cad/release/D5.iam
cad/release/D6.iam
cad/release/D7.iam
cad/release/D8.iam
cad/release/DIP14.ipt
cad/release/DefaultMotorMount.ipt
cad/release/DefaultMotorMountBack.ipt
cad/release/EncoderPCB.ipt
cad/release/EncoderPCBAssembly.iam
cad/release/EncoderPCBMount.ipt
cad/release/EncoderReadingsAddArrows.iam
cad/release/EncoderWheelAdapter.ipt
cad/release/EncoderWheelAdapterDefaultSlotted.ipt
cad/release/EncoderWheelAdapterSlotted.ipt
cad/release/EncoderWheelAdapterSmall.ipt
cad/release/EncoderWheelAdapterSmallSlotted.ipt
cad/release/EncoderWheelPitch.ipt
cad/release/EncoderWheelYaw.ipt
cad/release/Fasteners/StandoffM4x10A.ipt
cad/release/Fasteners/StandoffM4x15A.ipt
cad/release/Fasteners/StandoffM4x15B.ipt
cad/release/Fasteners/StandoffM4x20A.ipt
cad/release/Fasteners/StandoffM4x20B.ipt
cad/release/Fasteners/StandoffM4x5A.ipt
cad/release/Fasteners/StandoffM4x5B.ipt
cad/release/ForceStopper.ipt
cad/release/GP1A52HRJ00F.ipt
cad/release/GT2Shaft16T.ipt
cad/release/GT2Shaft20T.ipt
cad/release/GT2Shaft32T.ipt
cad/release/GT2Shaft48T.ipt
cad/release/GT2Shaft64T.ipt
cad/release/GT2TimingBeltGear.ipt
cad/release/GT2Yaw.ipt
cad/release/Header1x4.iam
cad/release/Header1x8.iam
cad/release/JD5B-2655W-R.ipt
cad/release/LaserDiodeAdapter.ipt
cad/release/LaserDiodeAdapterLarge.ipt
cad/release/MULTIWATT15.ipt
cad/release/Magnet3010.ipt
cad/release/Magnet6010.ipt
cad/release/Not.iam
cad/release/OmegaRing.ipt
cad/release/OmegaRingTypeB.ipt
cad/release/OmegaRingTypeC.ipt
cad/release/OutputG.iam
cad/release/OutputV.iam
cad/release/PitchAssembly.iam
cad/release/PitchAssemblyB.iam
cad/release/PitchAssemblyC.iam
cad/release/PitchAssemblyNFinal.iam
cad/release/PitchAssemblyOTS.iam
cad/release/PitchMotor.iam
cad/release/PitchMotor/MockPitchMotor.ipt
cad/release/PitchMotor/OldVersions/MockPitchMotor.0003.ipt
cad/release/PitchMotor/OldVersions/pitch_motor_flashlight_attached_model.0006.iam
cad/release/PitchMotor/OldVersions/pitch_shaft.0001.ipt
cad/release/PitchMotor/OldVersions/pitch_stator_front_attachment_flashlight.0003.ipt
cad/release/PitchMotor/Rovo/OldVersions/RovoPitch.0002.iam
cad/release/PitchMotor/Rovo/OldVersions/pitchThings.0003.ipt
cad/release/PitchMotor/Rovo/OldVersions/pitch_StatorShell_v3_Top_Flashlight_attachment.0002.ipt
cad/release/PitchMotor/Rovo/OldVersions/pitch_StatorShell_v3_Top_Flashlight_attachment.0003.ipt
cad/release/PitchMotor/Rovo/OldVersions/pitch_StatorShell_v5.0001.ipt
cad/release/PitchMotor/Rovo/OldVersions/pitch_bearing_mount.0001.ipt
cad/release/PitchMotor/Rovo/OldVersions/pitch_stator_front_attachment_flashlight_v2.0003.ipt
cad/release/PitchMotor/Rovo/OldVersions/pitch_tube_commutator_attachment.0001.ipt
cad/release/PitchMotor/Rovo/RovoPitch.iam
cad/release/PitchMotor/Rovo/pitch6mmBearingAdapter.ipt
cad/release/PitchMotor/Rovo/pitchThings.ipt
cad/release/PitchMotor/Rovo/pitch_StatorShell_v3_Top_Flashlight_attachment.ipt
cad/release/PitchMotor/Rovo/pitch_StatorShell_v5.ipt
cad/release/PitchMotor/Rovo/pitch_bearing_mount.ipt
cad/release/PitchMotor/Rovo/pitch_stator_front_attachment_flashlight_v2.ipt
cad/release/PitchMotor/Rovo/pitch_tube_commutator_attachment.ipt
cad/release/PitchMotor/Rovo/tube.ipt
cad/release/PitchMotor/pitch_RotorCore.ipt
cad/release/PitchMotor/pitch_StatorShell_v1_Top_Flashlight_attachment.ipt
cad/release/PitchMotor/pitch_StatorShell_v5.ipt
cad/release/PitchMotor/pitch_commutator_attachment1.ipt
cad/release/PitchMotor/pitch_motor_flashlight_attached_model.iam
cad/release/PitchMotor/pitch_pressurecap-front.ipt
cad/release/PitchMotor/pitch_shaft.ipt
cad/release/PitchMotor/pitch_stator_front_attachment_flashlight.ipt
cad/release/PowerPlug.iam
cad/release/PwrJack2.1mm.ipt
cad/release/R1038_ZZ_W Bearing.ipt
cad/release/RailBase.ipt
cad/release/RailBaseBottom.ipt
cad/release/ReleaseAssembly.iam
cad/release/Rod3_8in.ipt
cad/release/SecondaryEncoderPCBMount.ipt
cad/release/ShaftArm.ipt
cad/release/ShaftArmB.ipt
cad/release/ShaftArmC.ipt
cad/release/ShaftArmTwoWheels.ipt
cad/release/ShaftBushing.ipt
cad/release/ShaftSyncAdapter.ipt
cad/release/Tensioner.ipt
cad/release/User_Library-Header_Male_4Pin_BodyArray.ipt
cad/release/User_Library-Header_Male_4Pin_PinArray.ipt
cad/release/User_Library-Header_Male_8Pin_BodyArray.ipt
cad/release/User_Library-Header_Male_8Pin_PinArray.ipt
cad/release/VLM-650-03-LPT.ipt
cad/release/WoodBase.ipt
cad/release/YawAssembly.iam
cad/release/YawBottomPlate.ipt
cad/release/YawBottomPlateThick.ipt
cad/release/YawMotor.iam
cad/release/YawMotorPlate.ipt
cad/release/YawTopClamp.ipt
cad/release/diode.ipt
cad/release/pcb.iam
cad/release/pitch_tube_commutator_attachment.ipt
