lcall3/Controller/PCB/GerberInstructions.JPG

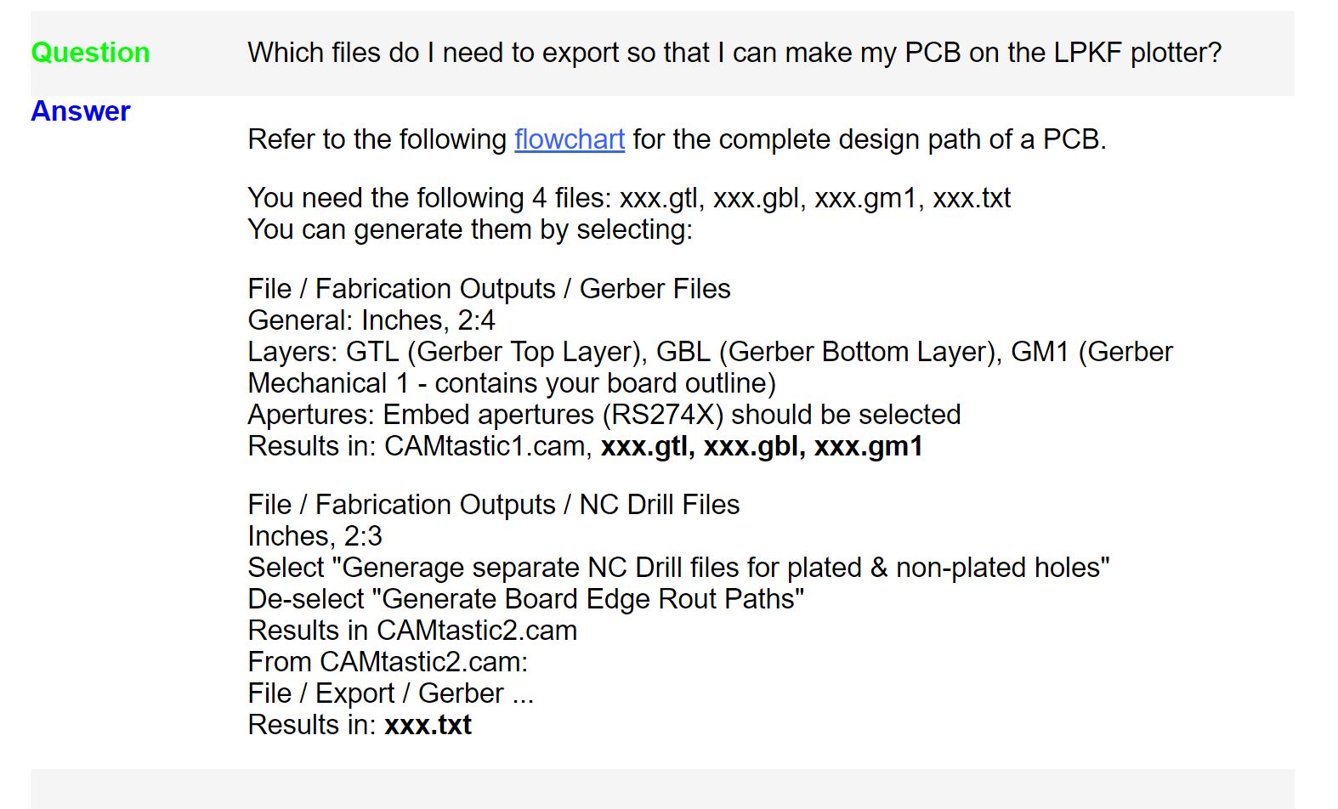
PCB/GerberInstructions.JPG
