lcall3/Controller/PCB/SubmissionInstructions.JPG

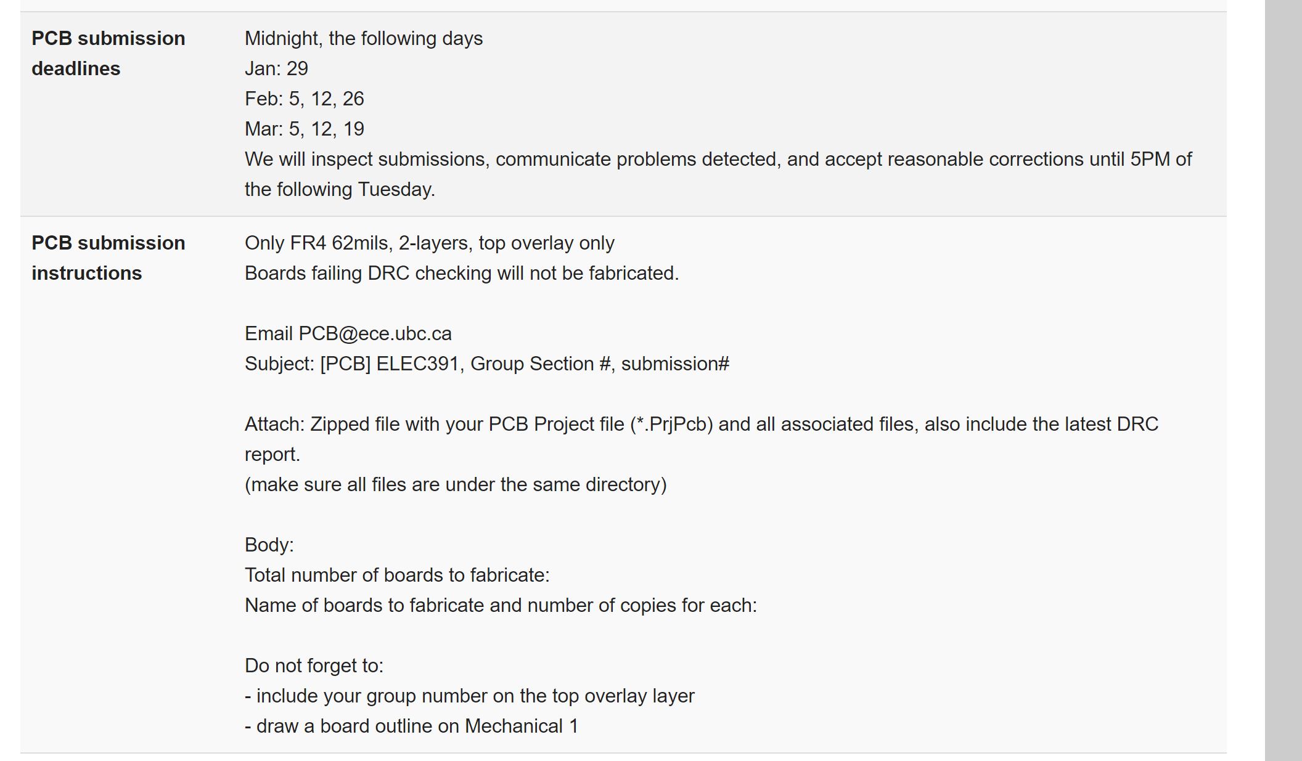
PCB/SubmissionInstructions.JPG
