lcall3/Controller/data/default_motor_speed_test.xlsx

Sheet: Sheet1
Resistance | 8.42
Speed (Pulse/s) | Speed (rad/s) | Speed(RPM) | Voltage at Terminal (V) | Current (A) | Voltage Drop (V) | Back EMF (V) | Power In (W) | Power Loss (W) | Power Out (W) | Torque (mNm) | B (Nms)
1700 | 26.70353756 | 255 | 0.638 | 0.088 | 0.74096 | -0.10296 | 0.056144 | 0.06520448 | -0.00906048 | -0.3392988656 | -0.01270613921
6560 | 103.044239 | 984 | 1.88 | 0.092 | 0.77464 | 1.10536 | 0.17296 | 0.07126688 | 0.10169312 | 0.9868879711 | 0.009577323103
11350 | 178.2853831 | 1702.5 | 3.09 | 0.101 | 0.85042 | 2.23958 | 0.31209 | 0.08589242 | 0.22619758 | 1.268738783 | 0.007116336523
23330 | 366.466783 | 3499.5 | 6.11 | 0.117 | 0.98514 | 5.12486 | 0.71487 | 0.11526138 | 0.59960862 | 1.636188183 | 0.004464765319
35430 | 556.5331386 | 5314.5 | 9.24 | 0.127 | 1.06934 | 8.17066 | 1.17348 | 0.13580618 | 1.03767382 | 1.864531953 | 0.003350262229
46900 | 736.7034773 | 7035 | 12.2 | 0.137 | 1.15354 | 11.04646 | 1.6714 | 0.15803498 | 1.51336502 | 2.054239008 | 0.002788420404
 |  |  |  |  |  |  |  |  |  |  | 0.005459421515 | (Average)
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
