lcall3/Controller/data/motor speed test with current driver.xlsx

Sheet: PWM50
Time | Speed | Time | Speed | Abs Speed | Speed
[s] | [rad/s] | [s] | [pulse/10ms] | [pulse/s] | [rad/s]
0.01 | 0.00 | 0.01 | 0 | 0 | 0.00
0.02 | 0.00 | 0.02 | 0 | 0 | 0.00
0.03 | 1.57 | 0.03 | 0 | 0 | 0.00
0.04 | 0.00 | 0.04 | -1 | 100 | 1.57
0.05 | 4.71 | 0.05 | -2 | 200 | 3.14
0.06 | 4.71 | 0.06 | -2 | 200 | 3.14
0.07 | 6.28 | 0.07 | -2 | 200 | 3.14
0.08 | 6.28 | 0.08 | -4 | 400 | 6.28
0.09 | 9.42 | 0.09 | -4 | 400 | 6.28
0.10 | 11.00 | 0.1 | -6 | 600 | 9.42
0.11 | 12.57 | 0.11 | -6 | 600 | 9.42
0.12 | 14.14 | 0.12 | -6 | 600 | 9.42
0.13 | 18.85 | 0.13 | -8 | 800 | 12.57
0.14 | 18.85 | 0.14 | -10 | 1000 | 15.71
0.15 | 21.99 | 0.15 | -10 | 1000 | 15.71
0.16 | 25.13 | 0.16 | -12 | 1200 | 18.85
0.17 | 26.70 | 0.17 | -14 | 1400 | 21.99
0.18 | 29.85 | 0.18 | -14 | 1400 | 21.99
0.19 | 32.99 | 0.19 | -19 | 1900 | 29.85
0.20 | 36.13 | 0.2 | -21 | 2100 | 32.99
0.21 | 40.84 | 0.21 | -26 | 2600 | 40.84
0.22 | 47.12 | 0.22 | -32 | 3200 | 50.27
0.23 | 50.27 | 0.23 | -39 | 3900 | 61.26
0.24 | 56.55 | 0.24 | -47 | 4700 | 73.83
0.25 | 62.83 | 0.25 | -61 | 6100 | 95.82
0.26 | 69.12 | 0.26 | -75 | 7500 | 117.81
0.27 | 78.54 | 0.27 | -88 | 8800 | 138.23
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
