lcall3/Controller/(threads)

Thread 3 (2018-03-23):

Find motor parameters for team designed motors

FSXAC, 2018-03-23:
[ ]- Yaw motor
[ ]- Pitch motor

Refer to notebook for steps; alternative method available here https://lcall3.github.io/Demo2Feedback/

Closed 2018-04-09.
