lcall3/Controller/doc/report/Demo2 Drawings.pdf

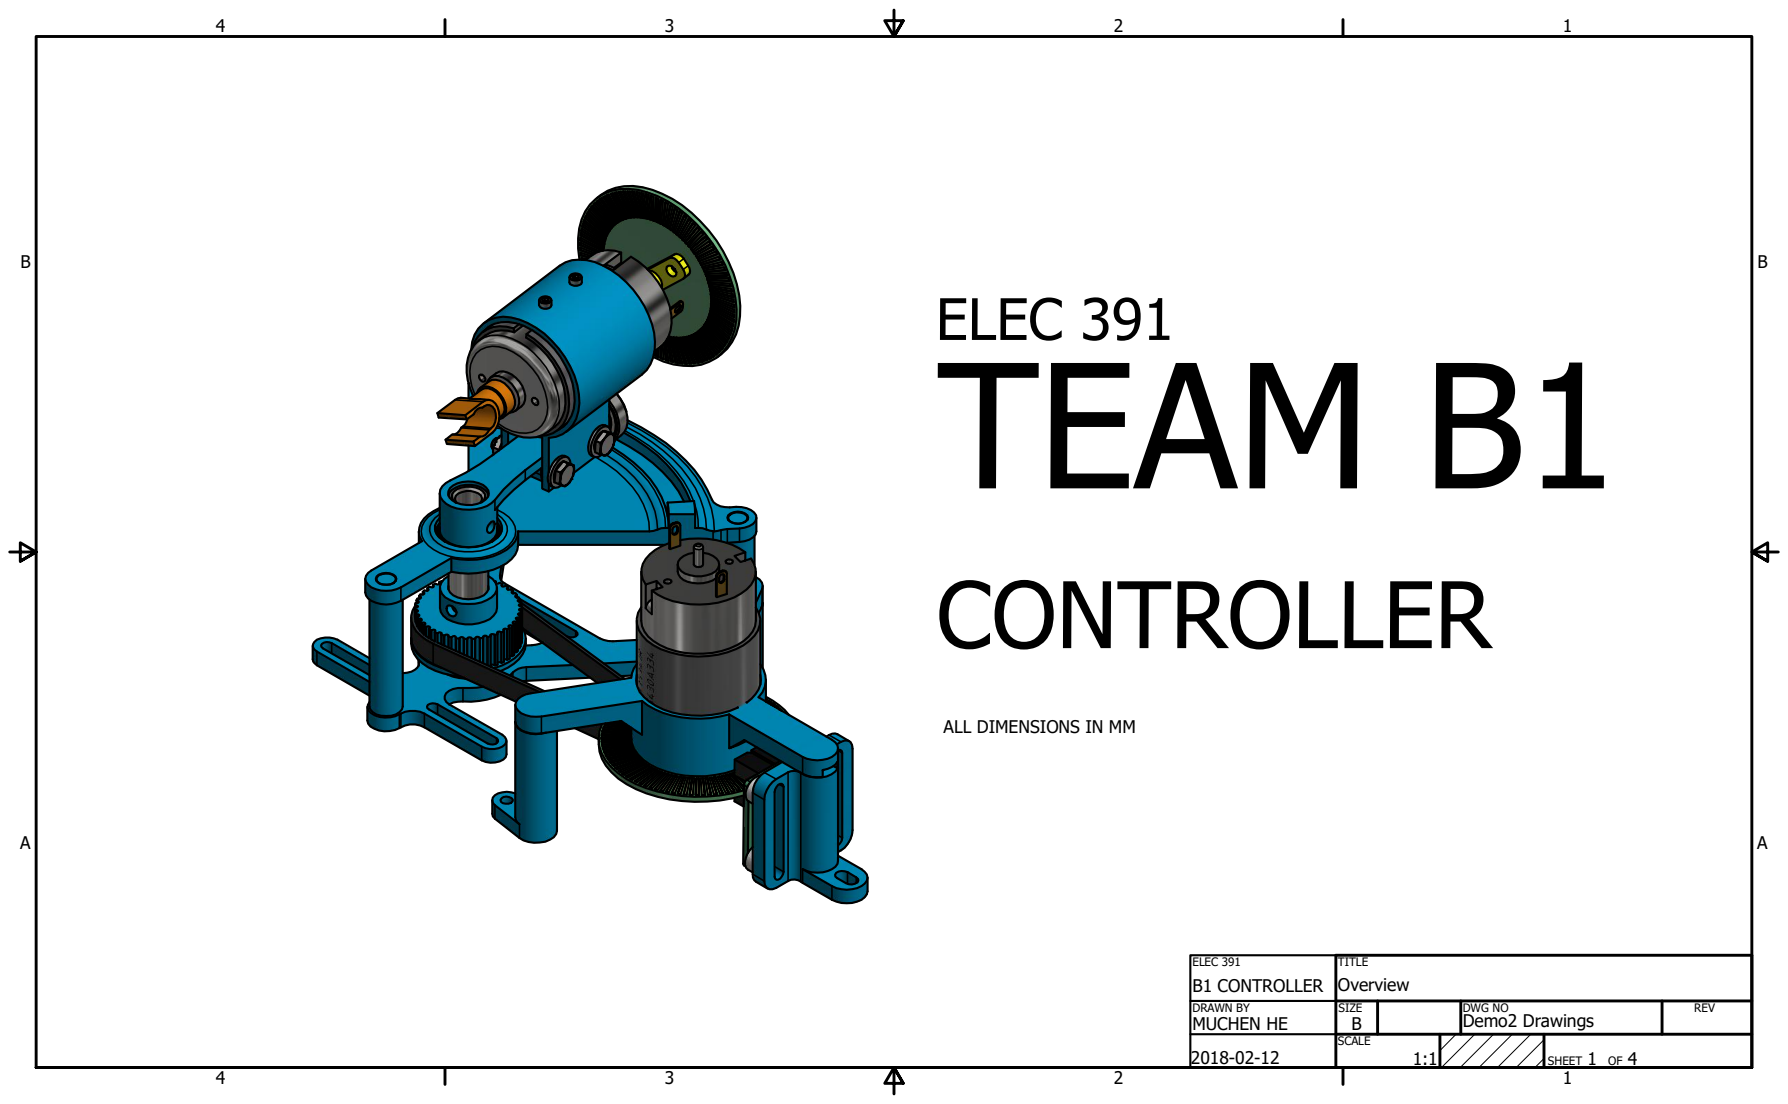
[picture p101: page 1]
ELEC 391 TEAM B1

ALL DIMENSIONS IN MM

ELEC 391 B1 CONTROLLER | TITLE Overview

DRAWN BY MUCHEN HE | SIZE B | DWG NO Demo2 Drawings | REV

2018-02-12 | SCALE 1:1 | SHEET 1 OF 4

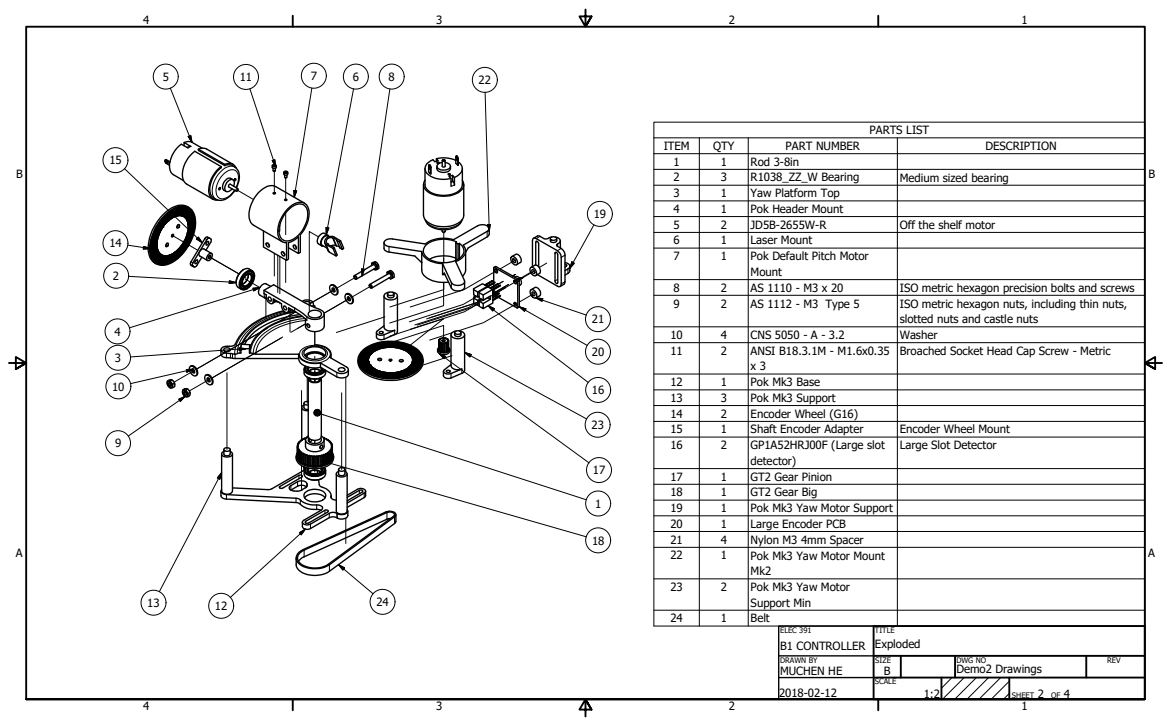
[picture p102: page 2]

I T E M | Q TY | P A RT N U M B E R | D E S C R I P T I O N
1 | 1 | R o d 3 -8 i n
2 | 3 | R 1 0 3 8 _ Z Z _ W B e a r i n g | M e d i u m s i z e d b e a r i n g
3 | 1 | Y a w Pla t fo r m T o p
4 | 1 | P o k H e a d e r M o u n t
5 | 2 | J D 5 B -2 6 5 5 W -R | O ff t h e s h elf m o t o r
6 | 1 | L a s e r M o u n t
7 | 1 | P o k D e fa ult P i t c h M o t o r M o u n t

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

1 0 | 4 | C N S 5 0 5 0 -A -3 . 2 | W a s h e r
1 1 | 2 | A N S I B 1 8 . 3 . 1 M -M 1 . 6 x 0 . 3 5 x 3 | B r o a c h e d S o c k e t H e a d C a p S c r e w -M e t r i c

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

1 7 | 1 | G T 2 G e a r P i n i o n
1 8 | 1 | G T 2 G e a r B i g
1 9 | 1 | P o k M k 3 Y a w M o t o r S u p p o r t
2 0 | 1 | L a r g e E n c o d e r P C B
2 1 | 4 | N ylo n M 3 4 m m S p a c e r
2 2 | 1 | P o k M k 3 Y a w M o t o r M o u n t M k 2

2 4 | 1 | B elt

E L E C 3 9 1 B 1 C O N T R O L L E R | T I T L E E x plo d e d

D RAW N B Y M U C H E N H E | S I Z EB | | D W G N O D e m o 2 D r a w i n g s | R E V

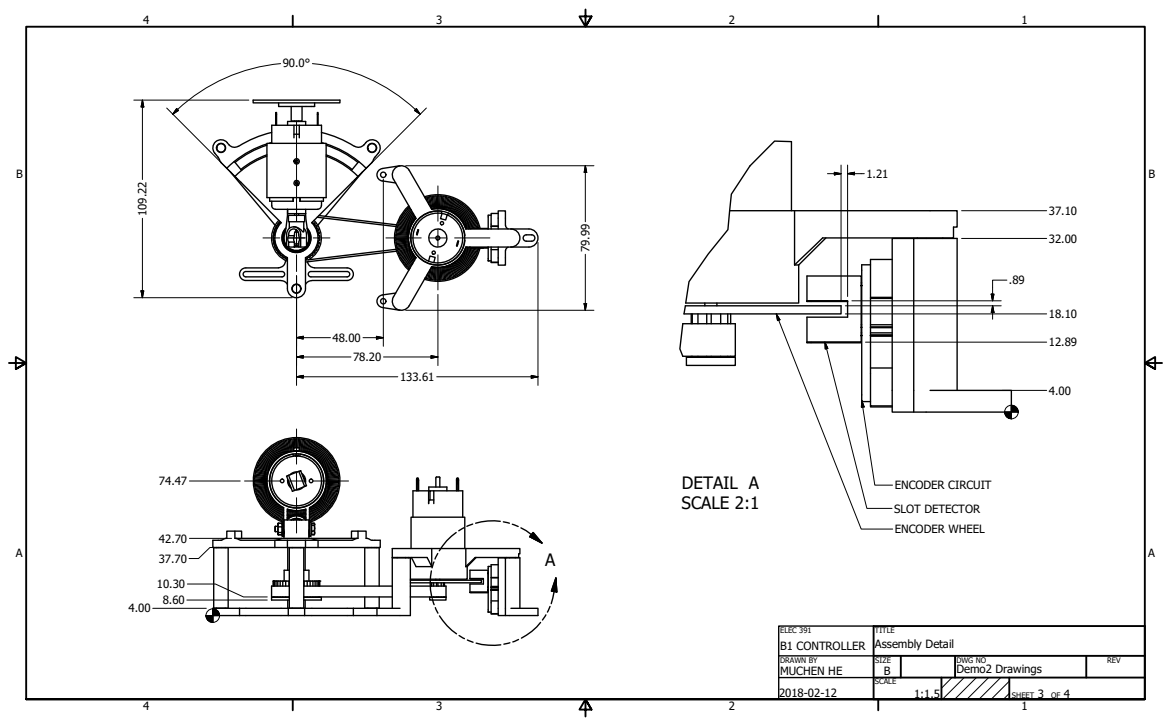
[picture p103: page 3]
DETAIL A SCALE 2:1; SLOT DETECTOR; ENCODER CIRCUIT; ENCODER WHEEL

ELEC 391 B1 CONTROLLER | TITLE Assembly Detail

DRAWN BY MUCHEN HE | SIZE B | DWG NO Demo2 Drawings | REV

1:1.5 | SHEET 3 OF 4

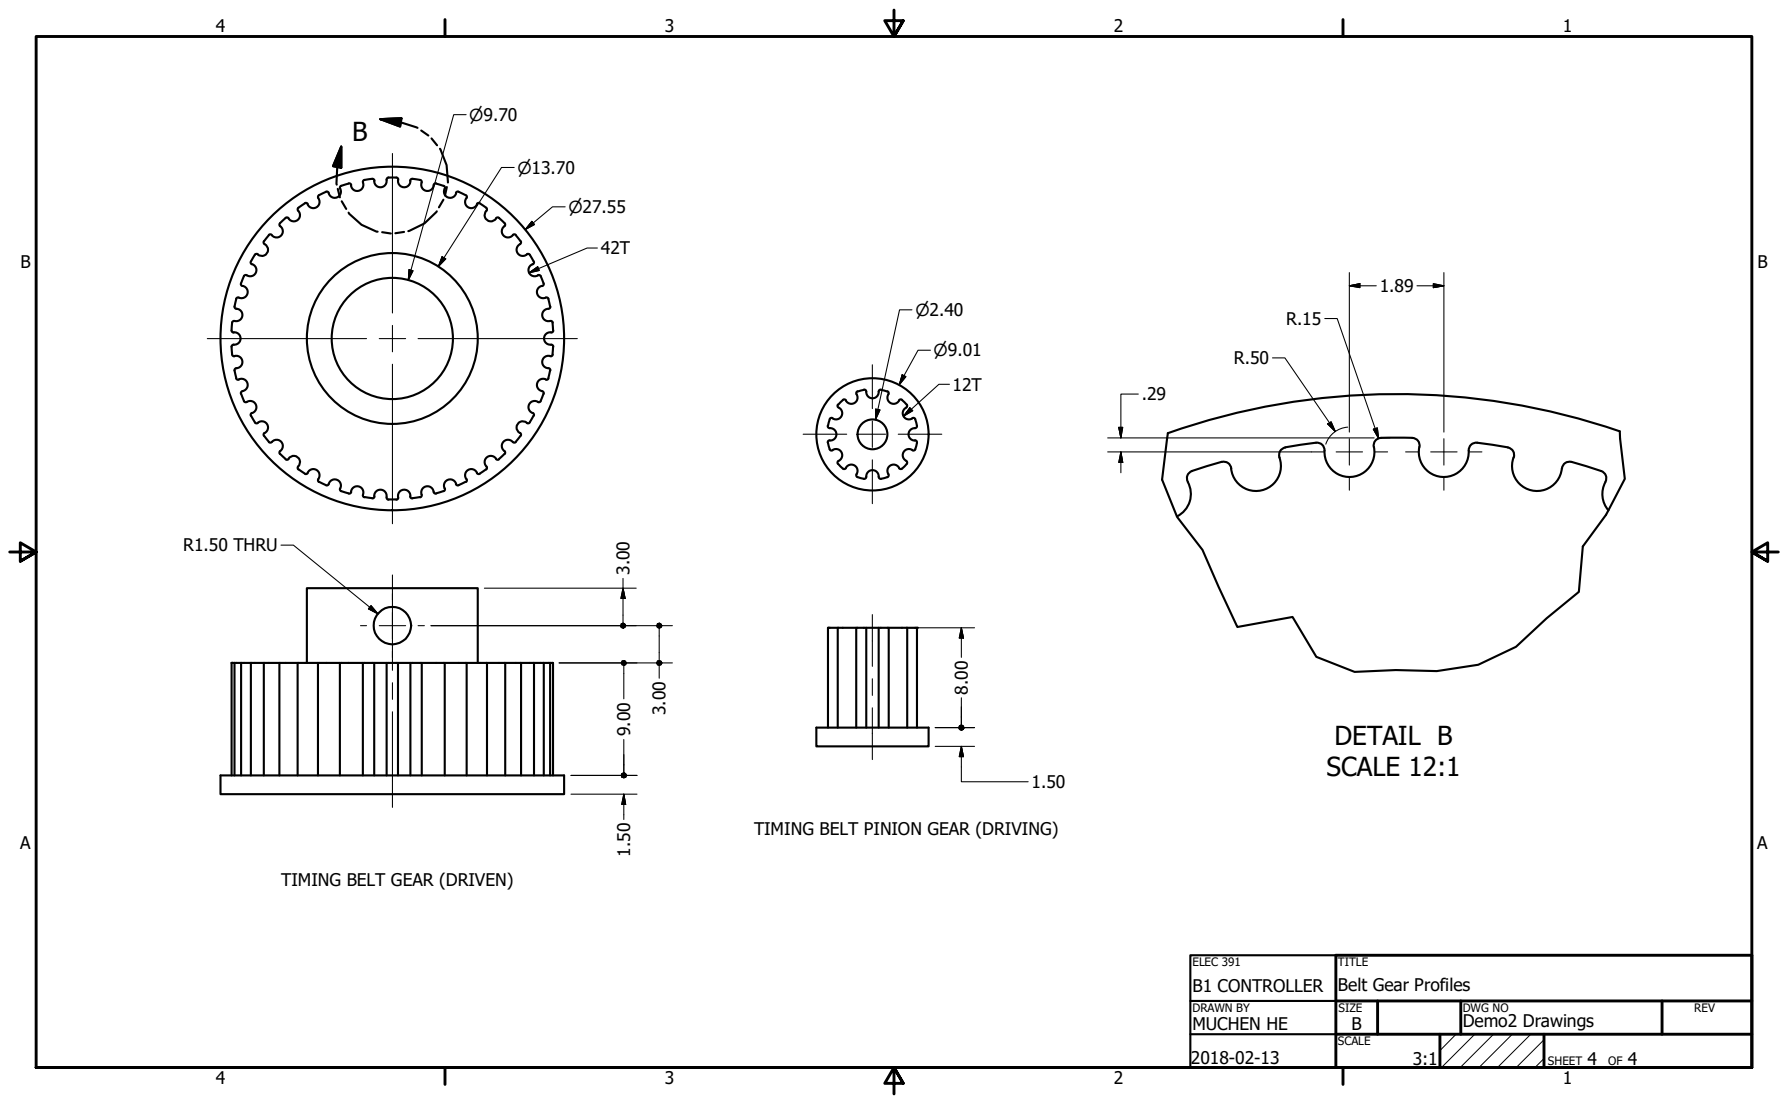
[picture p104: page 4]
DETAIL B SCALE 12:1; R1.50 THRU

TIMING BELT PINION GEAR (DRIVING)

TIMING BELT GEAR (DRIVEN)

ELEC 391 B1 CONTROLLER | TITLE Belt Gear Profiles

DRAWN BY MUCHEN HE | SIZE B | DWG NO Demo2 Drawings | REV

3:1 | SHEET 4 OF 4
