lcall3/Controller/doc/report/block diagram.pdf

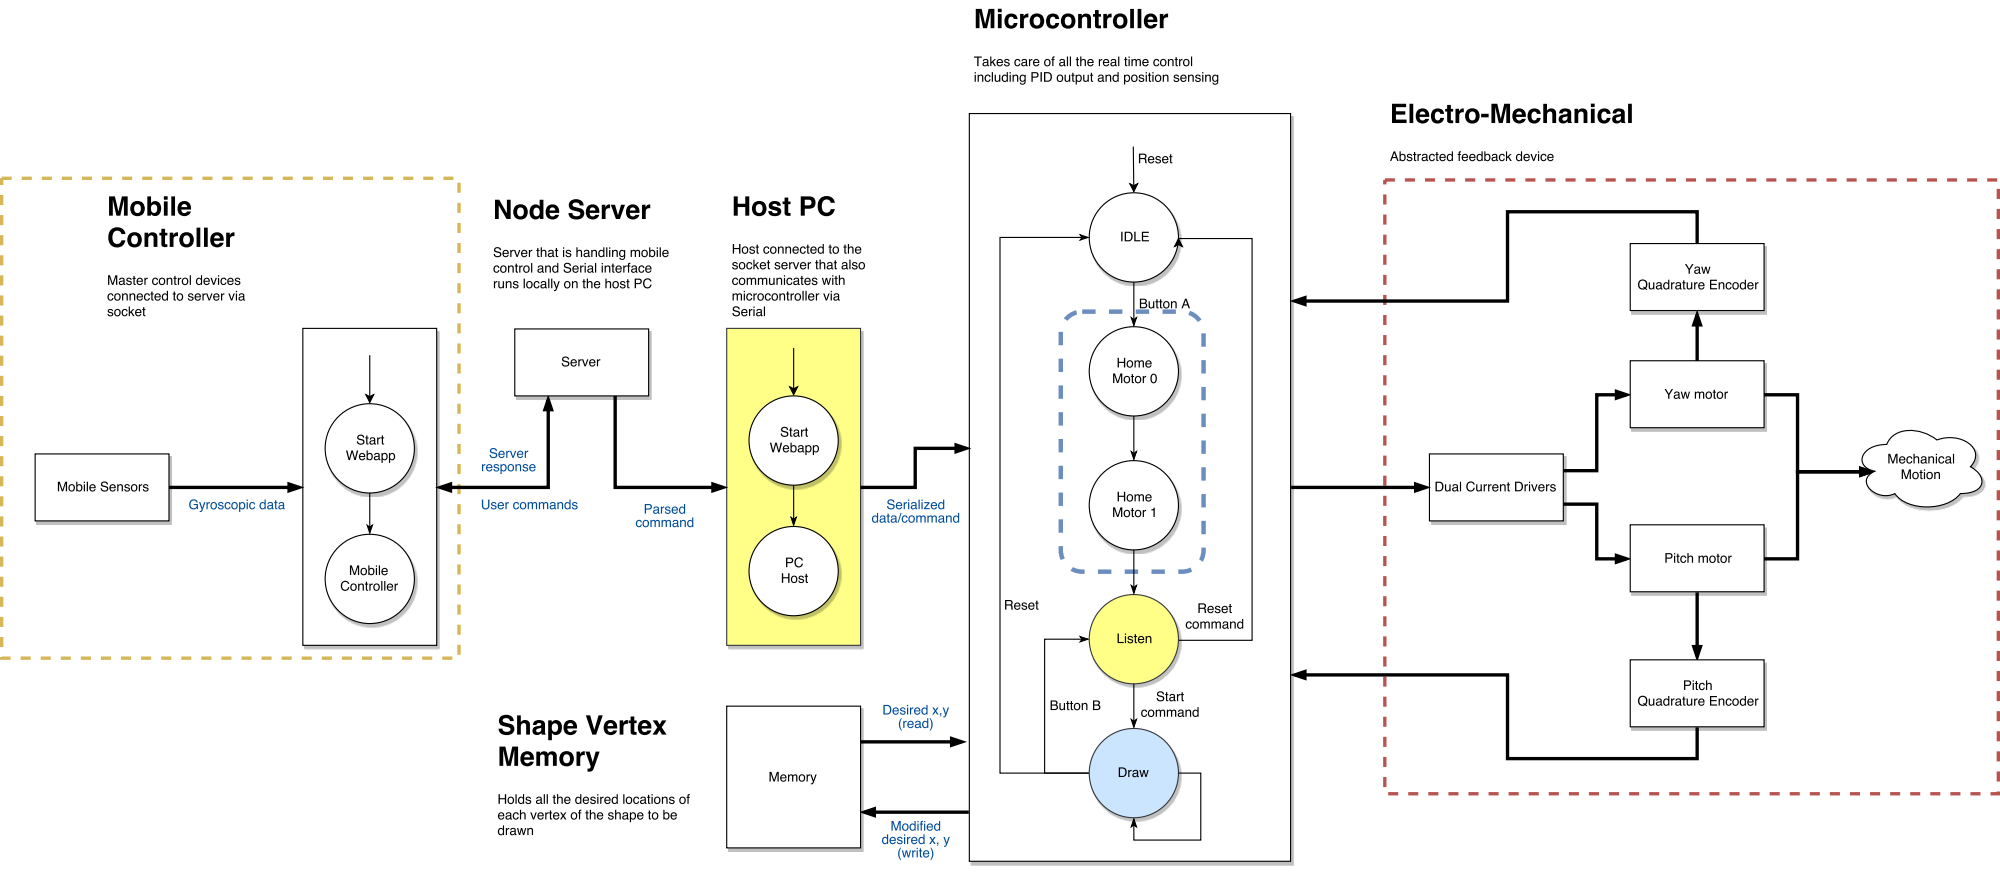
[picture p105: page 1]
