lcall3/Controller/cad/drawings/BaseCutout.pdf

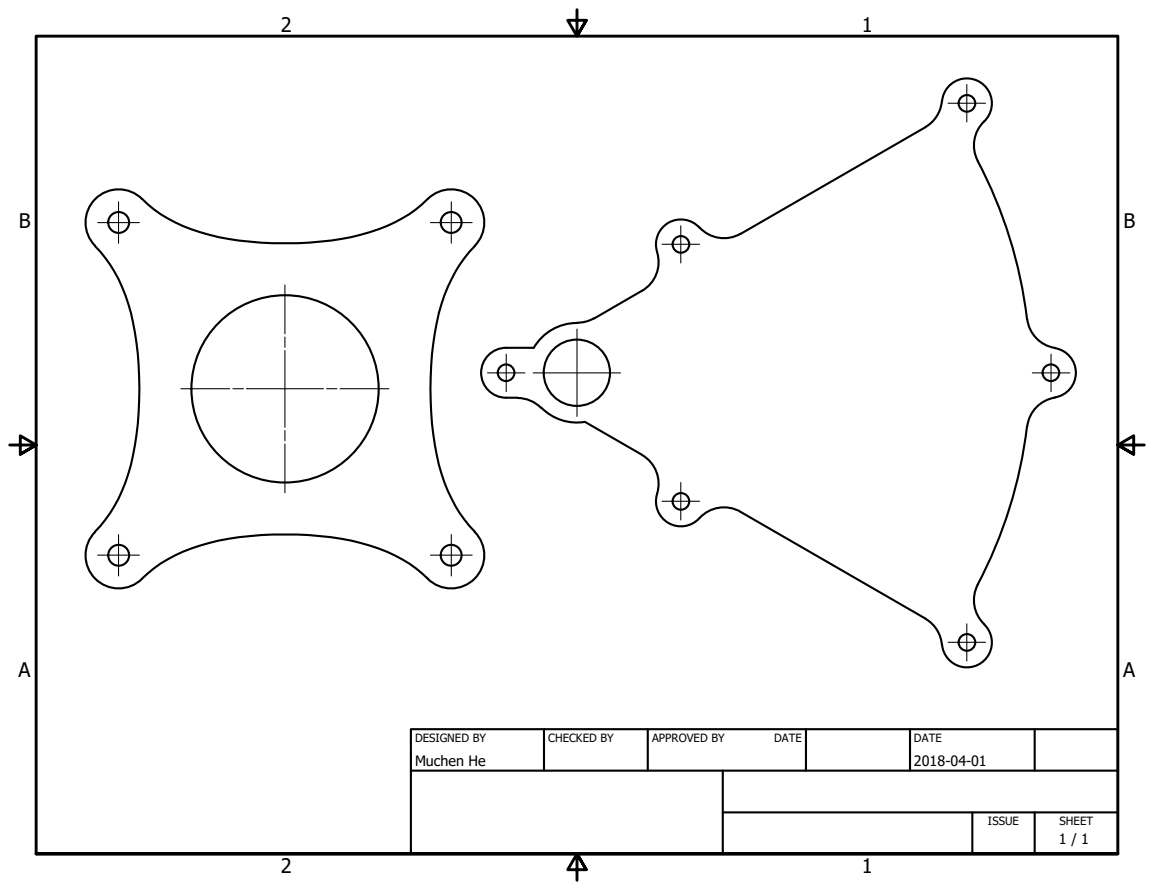
[picture p106: page 1]
DESIGNED BY; CHECKED BY; APPROVED BY; DATE; Muchen He
