lcall3/Controller/(list of files, drawings)

Other design files:
PCB/ELEC391_GroupB1_MainPCBv2/ELEC391_GroupB1_MainPCB/PCB_Project/MainPCB.PcbDoc
PCB/ELEC391_GroupB1_MainPCBv2/ELEC391_GroupB1_MainPCB/PCB_Project/PCB.SchDoc
PCB/ELEC391_GroupB1_MainPCBv2/ELEC391_GroupB1_MainPCB/PCB_Project/PCB_Project.PrjPcb
PCB/TopPCB/PCBPCB.PcbDoc
PCB/TopPCB/Schematics.SchDoc
PCB/TopPCB/TopPCB.PrjPcb
