lcall3/Controller/controller/_experiments/profiling/profiling.ino

#define NUM_SAMPLE 10

int samples[NUM_SAMPLE] = {};

// TEST 1 ::: ISR read and update position
volatile byte q0_encoderA, q0_encoderB;
volatile long q0_encoder_pos_change;
void testISRPortRead() {
    q0_encoderB  = PIND & (1 << 5);
    q0_encoderA ^ q0_encoderB ? q0_encoder_pos_change++ : q0_encoder_pos_change--;
}

// TEST 2 ::: ISR read and update position using digitalRead
void testISRDigitalRead() {
    q0_encoderB  = digitalRead(5);
    q0_encoderA ^ q0_encoderB ? q0_encoder_pos_change++ : q0_encoder_pos_change--;
}

// TEST 3 ::: Floating point to integer converison
void testFloatToInt() {
    int x = int(6.7549584);
}

// TEST 4 ::: Serial print 10 characters
void testSerial10Char() {
    Serial.print("123456789");
}

// TEST 5 ::: Timer ISR function
volatile long pos = 0;
volatile int pos_change = 300;
volatile int speed;
volatile boolean flag1, flag2;
volatile long counter;
void testTimer1ISR() {
    pos       += pos_change;
    speed      = pos_change;
    pos_change = 0;
    flag1 = true;
    flag2 = true;
    counter = 0;
    counter++;
}

// TEST 6 ::: Timer ISR function for dual motors
volatile long pos2 = 0;
volatile int pos_change2 = -365;
volatile int speed2;
void testTimer1ISR2() {
    pos       += pos_change;
    speed      = pos_change;
    pos_change = 0;
    pos2      += pos_change2;
    speed2     = pos_change2;
    pos_change = 0;
    flag1 = true;
    flag2 = true;
    counter = 0;
    counter++;
}

// Test 7 ::: control motor pwm
volatile int motor = 0;
volatile int pwm = -50;
void testControlMotor() {
    if (motor == 0) {
        digitalWrite(3, pwm > 0);
        pwm = constrain(abs(pwm), 30, 255);
        analogWrite(5, pwm);
        
    } else if (motor == 1) {
        digitalWrite(4, pwm > 0);
        pwm = constrain(abs(pwm), 30, 255);
        analogWrite(6, pwm);
    }
}

// Apply PID control for two motors
volatile int control_flag = 1;
volatile int fake_control_flag = 1;
volatile long accum1, accum2;
volatile int xs[2] = {400, -400};
volatile int ys[2] = {234, -432};
volatile int tv[2] = {3, 2};
volatile int desired1 = 0, desired2 = 0;
volatile int desiredi = 0;
volatile int count = 0;
void testApplyControl() {
    if (!control_flag) return;
    desired1 = xs[desiredi];
    desired2 = ys[desiredi];
    if (count >= tv[desiredi]) {
        if (desiredi == 1) {
            desiredi = 0;
        } else {
            desiredi++;
        }
        count = 0;
    }
    int q0_error = desired1 - pos;
    int q1_error = desired2 - pos2;
    accum1 += q0_error;
    accum2 += q1_error;
    int q0_pwm = int((3.4f * q0_error) + (0.033f * pos_change2) + (0.6f * accum1));
    int q1_pwm = int((8.9f * q1_error) + (0.001f * pos_change2) + (1.32f * accum2));
    motor = 0;
    pwm = q0_pwm;
    testControlMotor();
    motor = 1;
    pwm = q1_pwm;
    testControlMotor();
    fake_control_flag = false;
    count++;
}

// Run test helper function
void runFunction(void (*fut)(), char testName[]) {
    Serial.print(testName);
    Serial.println(":");

    // Run test
    for (int i = 0; i < NUM_SAMPLE; i++) {
        uint32_t startTime = micros();

        // Run the test function
        fut();

        uint32_t endTime = micros();
        samples[i] = endTime - startTime;
    }

    for (int i = 0; i < NUM_SAMPLE; i++) {
        Serial.print(samples[i], DEC);
        Serial.print(" ");
    }

    Serial.println("\n");
}

void setup() {
    Serial.begin(115200);

    // Run tests
    runFunction(&testISRPortRead, "ISR with pin reading from port register");
    runFunction(&testISRDigitalRead, "ISR with pin reading from digitalRead()");
    runFunction(&testFloatToInt, "Speed of conversio from float to int");
    runFunction(&testSerial10Char, "Speed of serial print for 10 characters");
    runFunction(&testTimer1ISR, "Timer 1 ISR single motor");
    runFunction(&testTimer1ISR2, "Timer 1 ISR dual motor");
    runFunction(&testControlMotor, "Control motor test");
    runFunction(&testApplyControl, "Dual motor PID control test");
}

void loop() { }
