lcall3/Controller/(commit log)

2018-01-09 motor param
2018-01-09 Added laser simulink model
2018-01-11 Added cad files for test bench
    [Default Motor Testbench Mk2.0001.iam, Default Motor Testbench Mk2.iam, Default Motor Testbench.iam, JD5B-2655W-R.0001.ipt, JD5B-2655W-R.ipt, Motor Face Mount.0003.ipt, Motor Face Mount.ipt, Motor Face Mount.stl]
2018-01-11 Updated motor face mount STL
    [Motor Face Mount.stl]
2018-01-11 Gcode for face mounting plate
    [Motor Face Mount.g]
2018-01-11 Updated simulink motor constants
2018-01-12 Arduino interrupt test
    [Default Motor Testbench.0001.iam, Default Motor Testbench.iam]
2018-01-13 Added new version encoder code
2018-01-13 Motor test bench assembly
    [Default Motor Testbench Mk2.0001.iam, Default Motor Testbench Mk2.0002.iam, Default Motor Testbench Mk2.iam, Default Motor Testbench Mk2.ipn, JD5B-2655W-R.0001.ipt, JD5B-2655W-R.0002.ipt, JD5B-2655W-R.ipt, Laser Mount.0001.ipt]
2018-01-13 Updated STL files
    [Laser Mount.stl, Motor Face Mount.stl, Motor Rotary Encoder Coupler.stl, Rotary Encoder Mount.stl]
2018-01-16 CAD files for updated motor mounts
    [Default Motor Testbench Mk2.0002.iam, Default Motor Testbench Mk2.0003.iam, Default Motor Testbench Mk2.iam, Laser Mount.0001.ipt, Laser Mount.0002.ipt, Laser Mount.ipt, Laser Mount.stl, Motor Rotary Encoder Coupler.0001.ipt]
2018-01-16 Encoder Wheel SolidWorks
    [Encoder Wheel.SLDPRT]
2018-01-17 updated simulink (pwm limiter)
    [Encoder Wheel.STL, Encoder Wheel.g]
2018-01-23 updated input signal and pid values
2018-01-24 Controller arduino files
    [Default Motor Testbench Mk2.0003.iam, Default Motor Testbench Mk2.0004.iam, Default Motor Testbench Mk2.iam, Default Motor Testbench Mk3.0002.iam, Default Motor Testbench Mk3.iam, Laser Mount.0002.ipt, Laser Mount.0004.ipt, Laser Mount.ipt]
2018-01-29 Failed processing serial implementation
    [encoder_interrupt_test.ino, step_test.ino, step_test.pde]
2018-01-29 Updated processing testing code
    [Default Motor Testbench Mk4.0004.iam, Default Motor Testbench Mk4.0006.iam, Default Motor Testbench Mk4.iam, GP1A52HRJ00F (Large slot detector).ipt, Slot Detector Holder.ipt]
2018-01-30 CaD update
    [Default Motor Testbench Mk4-1.0007.idw, Default Motor Testbench Mk4-1.idw, Default Motor Testbench Mk4.0002.ipn, Default Motor Testbench Mk4.0006.iam, Default Motor Testbench Mk4.0009.iam, Default Motor Testbench Mk4.iam, Default Motor Testbench Mk4.ipn, Encoder Wheel (G16).0001.ipt]
2018-01-30 PID stuff
2018-01-30 Encoder mount things
    [Encoder Mount.0003.ipt, Encoder Mount.ipt, Encoder Mount.stl]
2018-01-30 Finalized PI values
    [Default Motor Testbench Mk4.0009.iam, Default Motor Testbench Mk4.0010.iam, Default Motor Testbench Mk4.iam]
2018-02-07 Added testing docs from Feb 6
    [Sheet1.SchDoc, default_motor_speed_test.xlsx]
2018-02-07 Updated assemly
    [GP1A52HRJ00F (Large slot detector).0001.ipt, GP1A52HRJ00F (Large slot detector).0002.ipt, GP1A52HRJ00F (Large slot detector).ipt, Pok Mk1.0008.iam, Pok Mk1.iam, Pok Washer I2mmO5mm.ipt, Pok X-Carriage Bottom Support.0003.ipt, Pok X-Carriage Bottom Support.ipt]
2018-02-08 Renamed variables
    [demo1_data.xlsx]
2018-02-12 Added milestone 2 assembly prototype
    [Bearing1.iam, Brass Bushing.ipt, Default Motor Testbench Mk4.0010.iam, Default Motor Testbench Mk4.0011.iam, Default Motor Testbench Mk4.iam, Encoder Wheel (G16).0001.ipt, Encoder Wheel (G16).0002.ipt, Encoder Wheel (G16).ipt]
2018-02-13 Added Gt2 gear dxf
    [Feb13 - Pok Header Mount.stl, Feb13 - Pok Mk3 Support.stl, Feb13 - Yaw Platform Top.stl, GT2 12T 2p7.dxf]
2018-02-14 GT2 gear CAD
    [Feb13 - Default Test motor mount.stl, Feb13 - Pok Base.stl, Feb13 - Test GT2 Gear.stl, GT2 16 Teeth Free Pulley.ipt, GT2 16 Teeth Free Pulley.stl, GT2 Gear.0001.ipt, GT2 Gear.ipt, Pok Mk3.0019.iam]
2018-02-19 Encoder PCB Filess
2018-02-28 More CAD
    [GT2 Gear Big.0001.ipt, GT2 Gear Big.ipt, GT2 Gear Big.stl, GT2 Gear.0001.ipt, GT2 Gear.0002.ipt, GT2 Gear.ipt, Pok Mk3-DESKTOP-CU9Q4HD.iam]
2018-03-01 Main PCB
2018-03-01 updated simulink comparison
    [default_motor_speed_test.xlsx, vel.xlsx]
2018-03-02 Updated STL and arudino code for demo 2
    [Pok Mk3.0028.iam, Pok Mk3.0029.iam, Pok Mk3.iam, feb28 Pok Mk3 Yaw Motor Mount Mk2.stl, feb28 Pok Mk3 Yaw Motor Support Min.stl, feb28 Pok Mk3 Yaw Motor Support.stl]
2018-03-02 Added timer interrupt example
2018-03-03 Added encoder FSM example
2018-03-03 Encoder FSM written but havent tested
2018-03-03 Implemented encoder FSM with timer interrupts; not tested yet
2018-03-03 Open loop added motor control
2018-03-03 Refactored and reorganized
    [Default Motor Testbench Mk4-1.0007.idw, Default Motor Testbench Mk4.0002.ipn, Default Motor Testbench Mk4.0011.iam, Encoder Mount.0003.ipt, Encoder Wheel (G16).0002.ipt, GP1A52HRJ00F (Large slot detector).0002.ipt, GT2 Gear Big.0001.ipt, GT2 Gear.0003.ipt]
2018-03-04 demo2 powerpoint updates
    [default_motor_speed_test.xlsx, vel.xlsx]
2018-03-05 unzipped pcb
    [MainPCB.PcbDoc, PCB.SchDoc, PCB_Project.PrjPcb]
2018-03-05 More data on OL
    [03-04 GT2 Gear Big.stl, 03-04 GT2 Gear Pinion.stl, 03-04 Pok Mk3 Yaw Motor Mount Mk2.stl, 03-04 Yaw Platform Top.stl, GT2 Gear Big.0002.ipt, GT2 Gear Big.ipt, GT2 Gear Pinion.0001.ipt, GT2 Gear Pinion.ipt]
2018-03-05 Added proportional closed loop step response
    [PWM to curent driver voltage out.xlsx, motor speed test with current driver.xlsx]
2018-03-05 updated no load values and current limiter
    [vel.xlsx]
2018-03-06 added encoder logic and mapping logic
2018-03-06 Added q0 pgain close loop setup
    [03-05 ER Pok Mk3 Support .stl, 03-05 Pok Mk3 Base.stl, 03-05 Pok Mk3 Support.stl, 03-05 Pok Mk3 Yaw Motor Support.stl, Pok Mk3 Base.0008.ipt, Pok Mk3 Base.ipt, Pok Mk3 Support.0001.ipt, Pok Mk3 Support.ipt]
2018-03-06 cl tests
    [cl_matlab.xlsx, pwm.xlsx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]
2018-03-06 combined p response
    [cl_matlab.xlsx, q0 close loop P.xlsx]
2018-03-06 added static friction
    [cl_matlab.xlsx, pwm.xlsx, q0 close loop P.xlsx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]
2018-03-07 Finished adding close loop response data
    [q0 close loop P.xlsx]
2018-03-07 simulink updates
    [pwm.xlsx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]
2018-03-07 Updated how PWM is outputted
    [q0 close loop P.xlsx, q0 close loop PD.xlsx]
2018-03-07 Project clean up
    [Bearing1.iam, Encoder Wheel.SLDPRT, Encoder Wheel.STL, Encoder Wheel.g, GT2 12T 2p7.dxf, GT2 Gear Big.0002.ipt, GT2 Gear Pinion.0001.ipt, MainPCB.PcbDoc]
2018-03-07 excel sheets
    [cl_pid.xlsx, q0 close loop P.xlsx]
2018-03-07 Added drawings for CAD
    [Belt.ipt, Demo2 Drawings.idw, Encoder Wheel (G16).ipt, GT2 Gear Big.ipt, GT2 Gear Pinion.ipt, JD5B-2655W-R.ipt, Large Encoder PCB.ipt, Nylon M3 4mm Spacer.ipt]
2018-03-08 demo version PID done
2018-03-08 Control execution now fixed to control frequency
    [close_loop_PID.ino]
2018-03-08 demo ppt done :)
    [PWM to curent driver voltage out.xlsx]
2018-03-10 Report stuff
    [Pok Mk3 Demo.0005.ipn, Pok Mk3.0039.iam, Pok Mk3.iam]
2018-03-14 Updated PCB
    [MainPCB.PcbDoc, PCB.SchDoc, PCBPCB.PcbDoc, PCB_Project.PrjPcb, PWM to curent driver voltage out.xlsx, Schematics.SchDoc, TopPCB.PrjPcb, cl_pid.xlsx]
2018-03-15 Added header for finalized pin config
    [PWM to curent driver voltage out.xlsx, motor speed test with current driver.xlsx]
2018-03-15 updated pin assignments
2018-03-16 RF example (not working yet)
    [network.ino, rf.ino]
2018-03-16 Updated test and testing data
    [code speed.xlsx]
2018-03-16 Clean up and added more functions to the state machine
    [code speed backup.xlsx]
2018-03-16 Fixed halt flag initializationa nd added port indication
    [controller.h, controller.ino, lcall3.h]
2018-03-16 Fixed bit read in controller
    [controller.ino]
2018-03-19 Added pwm control
2018-03-20 Updated data
    [code speed.xlsx]
2018-03-23 Updated controller states
    [code speed.xlsx]
2018-03-23 Added socket server
2018-03-23 Added calibration
2018-03-24 Refactor socket controller to allow for serial
2018-03-24 Refactored client and server for socket controller
2018-03-24 Serial setup in socket server
2018-03-25 Final release cad added
    [EncoderPCB.ipt, EncoderPCBAssembly.0001.iam, EncoderPCBAssembly.iam, EncoderWheelAdapter.0002.ipt, EncoderWheelAdapter.ipt, EncoderWheelYaw.0006.ipt, EncoderWheelYaw.ipt, GP1A52HRJ00F.0003.ipt]
2018-03-25 Finished yaw assembly
    [EncoderPCB.0003.ipt, EncoderPCB.ipt, EncoderPCBAssembly.0001.iam, EncoderPCBAssembly.0002.iam, EncoderPCBAssembly.iam, EncoderPCBMount.0004.ipt, EncoderPCBMount.ipt, EncoderWheelAdapter.0002.ipt]
2018-03-25 Project space clean up
    [Encoder Wheel.SLDPRT, EncoderPCB.0003.ipt, EncoderPCBAssembly.0002.iam, EncoderPCBMount.0004.ipt, EncoderWheelAdapter.0003.ipt, EncoderWheelYaw.0007.ipt, GP1A52HRJ00F.0004.ipt, GT2Yaw.0003.ipt]
2018-03-27 Arduino web echo works
2018-03-27 Send serial prototype working
2018-03-28 fixed stupid github stuffs
    [serial_parse.ino]
2018-03-28 Updated CAD
    [EncoderPCBMount.dxf, EncoderWheelAdapterSmall.ipt, EncoderWheelPitch.ipt, GT2Shaft16T.ipt, GT2Shaft20T.ipt, GT2Shaft32T.ipt, GT2Shaft48T.ipt, GT2Shaft64T.ipt]
2018-03-28 Added PCB step file
2018-03-28 Good things
    [Board.ipt, CurrentDriver1.iam, CurrentDriver2.iam, D1.iam, D2.iam, D3.iam, D4.iam, D5.iam]
2018-03-28 Fasteners for PCB
    [Belt.ipt, PitchAssembly.0017.iam, RailBaseBottom.0001.ipt, ReleaseAssembly.0002.iam, ReleaseAssembly.iam, SecondaryEncoderPCBMount.0003.ipt, StandoffM4x5A.0003.ipt, StandoffM4x5B.ipt]
2018-03-29 added PCB dimensions
    [PCBPCB.PcbDoc]
2018-03-30 Added finalized CAD and STL for release v1.0
    [03-29 GT2Yaw.stl, 03-29 OmegaRing.stl, 03-29 OmegaRingTypeC.stl, 03-29 ShaftArm.stl, 03-29 YawTopClamp.stl, 03-29.stl, baseplate.dxf, bottombaseplate.dxf]
2018-03-31 Default motor backup
    [03-31 EncoderWheelAdapter.stl, 03-31 EncoderWheelAdapterSlotted.stl, 03-31 EncoderWheelAdapterSmall.stl, 03-31 EncoderWheelAdapterSmallSlotted.stl, 03-31 LaserDiodeAdapter.stl, 03-31 ShaftBushing.stl, 03-31 Tensioner.stl, 03-31 tube.stl]
2018-04-01 Fixed controller bugs and added cad for default motor
    [04-01 EncoderWheelAdapterSmallSlotted.stl, 04-01 LaserDiodeAdapterLarge.stl, EncoderWheelAdapterDefaultSlotted.0001.ipt, EncoderWheelAdapterDefaultSlotted.ipt, EncoderWheelAdapterSmallSlotted.0001.ipt, EncoderWheelAdapterSmallSlotted.0003.ipt, EncoderWheelAdapterSmallSlotted.ipt, LaserDiodeAdapterLarge.0001.ipt]
2018-04-02 Omega ring update
    [04-01 OmegaRing.stl, 04-01 OmegaRingTypeC.stl, OmegaRing.0005.ipt, OmegaRing.ipt, PitchAssemblyOTS.0001.iam, PitchAssemblyOTS.iam, RailBaseBottom.idw]
2018-04-02 Controller firmware now using two wires for direction
2018-04-02 updated PID, pin assignment, pitch testing
2018-04-02 Test controller PID
2018-04-03 More parts CAD
    [04-02 ForceStopper.stl, 04-02 ShaftSyncAdapter.stl, ForceStopper.0002.ipt, ForceStopper.ipt, PitchAssembly.0020.iam, PitchAssembly.0022.iam, PitchAssembly.0027.iam, PitchAssembly.iam]
2018-04-03 CAD folders cleanup
    [ControlBox.0002.iam, ControlBoxFace.0007.ipt, ControlBoxFlatFace.0003.ipt, ControlBoxSide.0002.ipt, ControlBoxTop.0004.ipt, DefaultMotorMount.0004.ipt, DefaultMotorMountBack.0003.ipt, DefaultMotorMountBack.0004.ipt]
2018-04-03 Experiment code and updated controller with homing functions
2018-04-03 GT2 variation cad
    [04-02 - GT2Yaw1p9mm.stl, 04-02 GT2Yaw1p9.stl, 04-02 GT2Yaw1p94wide.stl, 04-02 GT2Yaw1p95.stl, 16gt2.dxf]
2018-04-03 added motor part to the demo slide
2018-04-03 added laser array
